67160366/C7-earphone-web/README.md

# C7-BioSync Earphone Posture Monitoring System (Protocol v2)

ระบบตรวจจับและวิเคราะห์มุมกระดูกคอ (Craniovertebral Angle: CVA) แบบ 3 มิติแบบเรียลไทม์ โดยใช้เซนเซอร์ BNO085 คู่ (ซ้าย-ขวา) ร่วมกับ MPU6050 ที่ต้นคอ (C7) และแสดงผลผ่านหน้าเว็บที่เชื่อมหูฟังทาง USB โดยตรง (Web Serial API)

---

## 📂 ไฟล์หลักในเวอร์ชันนี้

1. **[`esp32_c7_prototype/esp32_c7_prototype.ino`](esp32_c7_prototype/esp32_c7_prototype.ino)**
   - โค้ด Arduino สำหรับบอร์ด ESP32 (Protocol v2: ส่ง `mpu_tilt` แยกจาก `head_pitch`)
   - ใช้ไดรเวอร์ `SafeBNO085` ที่เขียนขึ้นใหม่เพื่อคุยโปรโตคอล SHTP แบบแบ่ง Chunk ละ 32 ไบต์
   - รองรับการอ่านค่าเซนเซอร์ BNO085 พร้อมกัน 2 ตัว (`0x4A` และ `0x4B`) และเซนเซอร์ต้นคอ MPU6050 (`0x68`)
   - USB **460800 baud** (เดิม 115200) คำสั่ง `z` ตั้งท่าเริ่มต้น, `i` ตรวจ address, `s` สแกน I2C, `r` / `n` เปิด/ปิดโหมดเก็บข้อมูลดิบ 50 Hz
2. **[`index.html`](index.html)** หน้าสำหรับผู้ใช้
   - เชื่อมหูฟังด้วยปุ่มเดียว ดูโมเดลศีรษะและคอ 3 มิติ (3 มิติ / ด้านข้างพร้อมเส้น CVA / ด้านหน้า แสดงแบบกระจกเป็นค่าเริ่มต้น) สถานะท่า (ท่าดี / เริ่มก้มคอ / คอยื่น) และแถบ ก้ม-เงย / เอียงศีรษะ / หันหน้า
   - ตั้งท่าเริ่มต้น และเตือนเมื่อคอยื่นนานเกินเวลาที่ตั้งไว้ ถ้ายังไม่มีหูฟัง เปิด `index.html?demo` เพื่อดูด้วยข้อมูลจำลอง (มีป้ายบอกตลอด)
   - โมเดล 3 มิติใช้ Three.js ที่เก็บไว้ในเครื่อง (`assets/vendor`) และหัวสแกน CC BY 3.0 (`assets/models/head`) ต้องเปิดผ่าน http เช่น `http://127.0.0.1:8090/`
3. **[`dev.html`](dev.html)** หน้าสำหรับนักพัฒนา
   - แผง **สูตรมุมคอ (CVA) ทีละขั้น**: ค่าที่รับจากบอร์ดพร้อมที่มา, ค่าคงที่ (วัดได้ / สมมติ / คำนวณ), การคำนวณทีละบรรทัดด้วยตัวเลขจริง, ภาพด้านข้าง SVG, โมเดล 3 มิติที่ขยับตามค่าเดียวกัน และเทียบกับสูตรเก่า v1
   - สถานะบอร์ด (boot_id, calibration_id, อัตราเฟรม), เซ็นเซอร์ 0x4A / 0x4B / 0x68, มุมดิบ, การเทียบ CVA ระหว่างบอร์ดกับเว็บ, log, คำสั่ง `z` / `i` / `s` / คำสั่งดิบ
   - ตรวจทิศทางเซ็นเซอร์ทีละท่า (ก้ม / เอียงขวา / หันซ้าย) เพื่อดูว่าแกนและเครื่องหมายตรงกับที่หน้าเว็บใช้หรือไม่ ดู [`docs/SENSOR_AXES.md`](docs/SENSOR_AXES.md)
   - บันทึกลง `api/save_angle.php` (ปิดไว้ก่อน), ส่งออก CSV, ข้อมูลจำลองแบบปรับมุมเอง และผังต่อสาย
4. **[`collect.html`](collect.html)** หน้าเก็บข้อมูลดิบไว้ทำ data model
   - รับค่า quaternion, accel, gyro และมุม x/y/z ของทั้ง 3 เซ็นเซอร์ที่ 50 Hz พร้อมกราฟสด อัตราจริง บรรทัดที่หาย, δ ซ้าย-ขวา และเวลาห่างของสองหู (ซิงก์)
   - จอกว้างแสดง 3 ส่วนในจอเดียว: สถานะเซ็นเซอร์ | กราฟ | มุมการหมุน 3 มิติ
   - ขั้นตอนท่าพร้อมนับถอยหลังและเสียง, ป้ายท่า, ช่องกรอกมุมอ้างอิงที่วัดเอง, ดาวน์โหลด CSV + JSON (ข้อมูลอยู่ในเครื่อง ไม่ส่งไปที่ไหน)
   - มุมการหมุน 3 มิติ: แกน x/y/z ของเซ็นเซอร์แต่ละตัวในทิศโลก (ตะวันออก/เหนือ/ขึ้น) แบบแยกกันหรือซ้อนกัน, ตามที่ติดจริงหรือจัดแนวสองหูให้ตรงกัน, ทิศที่แต่ละแกนชี้, accel/gyro และมุมระหว่างสองหู
   - แผง "อ่านค่าในหน้านี้" อธิบายที่มาของค่า แกน 3 มิติ กราฟ และคอลัมน์ CSV
   - ข้อมูลจำลอง: `collect.html?demo` รูปแบบข้อมูลและวิธีเก็บที่แนะนำอยู่ใน [`docs/DATA_COLLECTION.md`](docs/DATA_COLLECTION.md)
5. **[`wiring.html`](wiring.html)** แบบร่าง 3 มิติ "หูฟังของผู้ใช้ + อุปกรณ์เสริมของเรา" พร้อมผังต่อสาย (ข้อเสนอ ยังไม่ได้สร้างจริง)
   - ผู้ใช้ใช้หูฟังครอบหูของตัวเอง แล้วติดอุปกรณ์เสริม: ตลับเซ็นเซอร์แปะด้านนอกฝาครอบหูทั้ง 2 ข้าง (BNO085 ข้างละตัว), โครงพาดบ่าจากที่ดามนิ้วอะลูมิเนียม 18 นิ้ว และกล่อง C7 (ESP32 DevKit V1 + แบต + GY-521 + Qwiic Adapter 2 แผ่นเป็นจุดแยกสาย) กลางแถบ สายจากตลับแต่ละข้างลงกล่องเป็นสาย Qwiic 20 ซม. 2 เส้นต่อกันด้วย Qwiic Adapter
   - 3 มุมมอง: สวมใส่, แยกชิ้น, ผังต่อสาย (บอร์ดขนาดจริงมีชื่อขาตามบอร์ด: Adafruit BNO085, ESP32 DevKit V1 30 ขา, GY-521, TP4056, MT3608, LiPo, สวิตช์, SparkFun Qwiic Adapter; สายในผังเดินตามสายจริงทีละเส้นพร้อมหัวต่อ, แตะบอร์ดเพื่อซูม, แตะสายเพื่อดูชนิดสาย, เปิด/ปิดสายแต่ละกลุ่ม) พร้อมตารางต่อสายจัดกลุ่มตามสายจริง 9 ชุด (36 เส้น), วิธีแยกไฟ 3V3 ไปหลายเซ็นเซอร์, ตารางตำแหน่งและจำนวนอุปกรณ์ทุกชิ้น, มุมมองสวมใส่แบบมองทะลุเห็นบอร์ดในตลับและกล่อง พร้อมระยะสายหู → C7 ที่วัดจากโมเดลทุกท่า, วิธีต่อแบต, รายการของที่ต้องซื้อจากร้านในไทย และความยาวสายตลับ→กล่องขณะขยับศีรษะ
   - ไม่ต่อ USB และไม่ใช้ข้อมูลเซ็นเซอร์ ไฟล์คือ `wiring.html` + `assets/wiring.js` + `assets/wiring-models.js` (หูฟัง, ตลับ, โครง) + `assets/wiring-boards.js` (บอร์ด)
6. **[`structure.html`](structure.html)** โครงสร้างในกล่อง (ข้อเสนอ ยังไม่ได้พิมพ์จริง): กล่อง C7 96 × 60 × 35 มม. 2 ชั้นมีถาดบอร์ดคั่น, ตลับเซ็นเซอร์ข้างหู และกล่องข้อต่อกลางสาย
   - แต่ละชิ้นวางตรงไหน ยึดด้วยอะไร สายเดินทางไหน ดูแบบประกอบแล้วหรือแยกชิ้นทีละชั้น แตะชิ้นส่วนหรือแถวในตารางเพื่อดูรายละเอียด
   - ตำแหน่งและขนาดอยู่ใน `assets/structure-layout.js` (หน้า wiring ใช้ชุดเดียวกัน) และ `node scripts/check-web.mjs` ตรวจว่าชิ้นส่วนไม่ชนกันและอยู่ในกล่อง
7. **[`assets/c7-core.js`](assets/c7-core.js)** โค้ดที่ทั้งสองหน้าใช้ร่วมกัน: สูตร CVA geometry 1 (ตรงกับ `calculateCVA()` ในเฟิร์มแวร์และ `api/save_angle.php` อธิบายใน [`docs/FORMULA.md`](docs/FORMULA.md)), การตรวจ Protocol v2 (รับ v1 ได้โดยถอด pitch ออกจาก `c7_angle`), การเชื่อม USB และข้อมูลจำลอง ดีไซน์อยู่ที่ [`docs/DESIGN.md`](docs/DESIGN.md)

### เปิดใช้งาน

ต้องมี PHP 8+ (หรือ XAMPP) และเปิดด้วย Chrome หรือ Edge บนคอมพิวเตอร์ (Web Serial):

```powershell
powershell -NoProfile -ExecutionPolicy Bypass -File scripts/serve.ps1        # เปิด server
powershell -NoProfile -ExecutionPolicy Bypass -File scripts/serve.ps1 -Stop  # ปิด server
node scripts/check-web.mjs                                                     # เทสต์
```

แล้วเปิด http://127.0.0.1:8090/ (ข้อมูลจำลอง: `/?demo`, หน้า dev: `/dev.html`, เก็บข้อมูล: `/collect.html`, แบบอุปกรณ์เสริม: `/wiring.html`, โครงสร้างในกล่อง: `/structure.html`) เฟิร์มแวร์กับหน้าเว็บต้องเป็นรุ่นเดียวกัน (460800 baud) ถ้าบอร์ดยังเป็นรุ่น 115200 ต้อง flash ใหม่ ปิดโปรแกรมอื่นที่ใช้พอร์ต USB เดียวกัน (เช่น Serial Monitor ของ Arduino IDE) ก่อนกดเชื่อมต่อ

ก่อนแก้โค้ดให้อ่าน [AGENTS.md](AGENTS.md) (กฎการทำงาน) และ [HANDOFF.md](HANDOFF.md) (สถานะล่าสุด) ทุกครั้งที่จบงานต้องอัปเดต HANDOFF และเพิ่มบันทึกใน [docs/WORKLOG.md](docs/WORKLOG.md)

---

## 🔍 สาเหตุของปัญหาที่พบ และการแก้ไขเรื่อง I2C Address ชนกัน

### 1. ปัญหาที่พบ (Root Cause: On-Board Pull-Up & Address Collision)
- โมดูลเซนเซอร์ **BNO085 (GY-BNO08X)** มีตัวต้านทาน **Pull-up (หรือการกำหนดค่าเริ่มต้นบนแผ่นบอร์ด)** ต่ออยู่ที่ขาเลือก Address (`DI` / `SA0` / `ADR`) อยู่แล้ว ทำให้ตัวบอร์ดมี I2C Address ตั้งต้นของตัวเองอยู่แล้วตั้งแต่จ่ายไฟ
- ก่อนหน้านี้เราไม่ทราบว่าบอร์ดมี Pull-up และมี Address กำหนดไว้แล้ว จึงทำการต่อสายกำหนด Address ซ้ำเหมือนกันทั้ง 2 ตัว (หรือเข้าใจสลับกันว่าปล่อยว่างคืออีกค่าหนึ่ง) ส่งผลให้เซนเซอร์ทั้ง 2 ตัวกลายเป็น **Address เดียวกัน** บนบัส I2C เดียวกัน (`Wire` ขา `SDA=21, SCL=22`)
- เมื่อเซนเซอร์ 2 ตัวมี Address ชนกันบนบัสเดียวกัน จึงเกิดอาการแย่งกันตอบ ACK / ข้อมูล SHTP ตีกัน ทำให้ทำงานพร้อมกันสองตัวไม่ได้ หรือเห็นเซนเซอร์ขึ้นแค่ตัวเดียว

### 2. การแก้ไขให้เซนเซอร์ทำงานพร้อมกันได้ทั้ง 2 ตัว (Dual BNO085 Solution)
- **แยก I2C Address ของเซนเซอร์ทั้ง 2 ตัวให้ต่างกันอย่างชัดเจน:**
  - **หูซ้าย (`LeftEar_A`)** กำหนดเป็น Address **`0x4A`**
  - **หูขวา (`RightEar_B`)** กำหนดเป็น Address **`0x4B`**
  - **ต้นคอ (`C7` - MPU6050)** ใช้ Address **`0x68`**
- **ตรวจสอบด้วย I2C Scanner (`s`) และล็อกตำแหน่งในโค้ด:**
  - ปรับโค้ดใน `detectAndInitDualBno()` ให้สแกนหาและจับคู่ `0x4A` เป็นเซนเซอร์ฝั่งซ้าย (เริ่มทำงานตัวที่ 1) และ `0x4B` เป็นเซนเซอร์ฝั่งขวา (เริ่มทำงานตัวที่ 2) อย่างแม่นยำ พร้อมรองรับกรณีแยกบัสสำรอง (`Wire` 21/22 และ `Wire1` 18/19)

---

## 🛠️ สรุปการแก้ไขเพิ่มเติมในโค้ดเวอร์ชันใหม่

### 1. แก้ไขฝั่ง Arduino (`esp32_c7_prototype.ino`)
- **สร้างคลาส `SafeBNO085` แทนที่ไลบรารี `SparkFun_BNO080` เดิม:**
  - แก้ปัญหา `Guru Meditation Error: StoreProhibited` (บั๊ก I2C ของ ESP32 Core 3.0.x เมื่อชิป NACK กลางคัน)
  - เช็ค `waitWriteAck()` (`beginTransmission` / `endTransmission`) ก่อนเรียก `requestFrom()` ทุกครั้ง
  - จำกัดขนาดการอ่าน SHTP ครั้งละไม่เกิน **32 ไบต์** (~2.9 ms ที่ 100 kHz) เพื่อไม่ให้เกินเพดาน Hardware Timeout 13.1 ms ของซิลิคอน ESP32
  - ยกเลิกการสั่ง `softReset()` แล้วรอเพียง 50 ms ที่ทำให้ชิปยังไม่พร้อมและเกิด NACK โดยเปลี่ยนเป็นอ่าน SHTP ทันที และหากจำเป็นต้องรีเซ็ตจะใช้ `safeSoftResetAndWait()` ที่รอชิปบูตครบ 450 ms พร้อมเช็ค ACK 5 ครั้งติดกัน
- **ระบบตรวจสอบสายไฟและสลับขาอัตโนมัติ (Electrical PinCheck & Auto-Swap):**
  - เช็คสถานะทางไฟฟ้าของขา `D21` และ `D22` ตอนบูต (`OK_PULLUP_3V3`, `FLOATING`, หรือ `LOW_STUCK`) พร้อมฟังก์ชัน `unstickI2CPins()` ส่งคล็อก 16 ลูกเพื่อปลดล็อกกรณีสาย SDA ค้าง
  - หากไม่พบอุปกรณ์บน `(SDA=21, SCL=22)` บอร์ดจะทดลองสลับเป็น `(SDA=22, SCL=21)` อัตโนมัติเผื่อเสียบสายสลับกัน
- **การคำนวณมุมศีรษะจากเซนเซอร์คู่ (Dual-Ear Circular Midpoint) และ Protocol v2:**
  - ตั้งศูนย์ (Zero Calibration) แยกอิสระรายตัว (`offsetPitchL/R`, `offsetRollL/R`, `offsetYawL/R`, `offsetC7`)
  - เมื่อทั้ง `0x4A` และ `0x4B` ทำงานพร้อมกัน จะคำนวณค่าเฉลี่ยเชิงมุม (`circularMidpointDeg`) ของหูซ้ายและหูขวาเพื่อให้ได้มุมกลางกะโหลกที่แม่นยำ และส่งออกเป็น JSON **Protocol v2** ความถี่ 5 Hz (ทุก 200 ms)
  - field หลัก: `protocol_version: 2`, `geometry_id`, `tilt_estimated`, `mpu_tilt` (มุม MPU ที่ C7 เทียบตอนตั้งศูนย์ ไม่ผสม pitch, `null` ถ้าไม่มี MPU), `mpu_tilt_raw`, `head_pitch`, `head_roll`, `head_yaw`, `cva_angle`
  - CVA ใช้แบบจำลอง 2 ท่อนในระนาบด้านข้าง (geometry 1) roll/yaw ไม่เข้าสูตร ดู [`docs/FORMULA.md`](docs/FORMULA.md)
  - มีระบบ Auto-Reconnect / Health Check ทุก 3 วินาที หากสายหลุดแล้วเสียบใหม่จะกลับมาอ่านค่าต่อได้เองโดยไม่ต้องรีบูตบอร์ด

### 2. หน้าเว็บ
- หน้าเดิม (`live_test.html`, `wiring_guide.html` และ pitch deck ใน `index.html`) ถูกแทนด้วย `index.html` และ `dev.html` ชุดใหม่ ฟีเจอร์ USB เดิม (ปลด DTR/RTS, ตรวจ Protocol v1, Zero รอ `calibration_id`, สแกน I2C, log) ย้ายไปอยู่ใน `assets/c7-core.js` และหน้า dev
