67160366/C7-earphone-web/docs/README.md

# เอกสาร C7-earphone

| อยากรู้เรื่อง | เปิดไฟล์ |
| --- | --- |
| กฎการทำงาน, คำสั่ง, ข้อห้าม | [../AGENTS.md](../AGENTS.md) |
| สถานะล่าสุด, งานค้าง, สิ่งที่ยังไม่ได้ตรวจ | [../HANDOFF.md](../HANDOFF.md) |
| ประวัติการทำงานแต่ละรอบ | [WORKLOG.md](WORKLOG.md) |
| วิธีใช้งานและภาพรวมไฟล์ | [../README.md](../README.md) |
| สูตรมุมคอ (CVA): ตัวแปร, ค่าคงที่, ที่มา, ตัวอย่าง, ข้อจำกัด | [FORMULA.md](FORMULA.md) |
| ทิศแกน pitch/roll/yaw และปัญหาแกนในเฟิร์มแวร์ | [SENSOR_AXES.md](SENSOR_AXES.md) |
| เก็บข้อมูลดิบ 50 Hz: รูปแบบบรรทัด, คอลัมน์ CSV, วิธีเก็บที่แนะนำ | [DATA_COLLECTION.md](DATA_COLLECTION.md) |
| ดีไซน์หน้าเว็บ (สี, ตัวอักษร, หลักการเขียนข้อความ) | [DESIGN.md](DESIGN.md) |
| รายการสั่งซื้อชุดต่อสาย: ร้าน รุ่น ขนาด จำนวน ราคา | [SHOPPING_LIST.md](SHOPPING_LIST.md) ([PDF](SHOPPING_LIST.pdf)) |
| แผนและงานวิจัยเดิม | [../base_plan.md](../base_plan.md) (บางส่วนไม่ตรงกับโค้ดปัจจุบัน) |
