67160366/C7-earphone-web/HANDOFF.md

# Handoff: สถานะปัจจุบันของ C7-earphone

อ่านไฟล์นี้ก่อนเริ่มงาน และแก้ให้เป็นปัจจุบันทุกครั้งที่จบงาน (กฎอยู่ใน [AGENTS.md](AGENTS.md)) ประวัติการทำงานแต่ละรอบอยู่ใน [docs/WORKLOG.md](docs/WORKLOG.md)

## โปรเจกต์นี้คืออะไร
- หูฟังติดเซ็นเซอร์ BNO085 ที่หู (0x4A ซ้าย / 0x4B ขวา) และ MPU6050 ที่ต้นคอ (0x68, ไม่บังคับ) ต่อกับ ESP32
- บอร์ดส่ง JSON **Protocol v2** ทาง USB ที่ **460800 baud** (เปลี่ยนจาก 115200 รอบนี้) ทุก 200 ms โดยส่ง `mpu_tilt` แยกจาก `head_pitch`
- **โหมดเก็บข้อมูล** (คำสั่ง `r` / `n`): ส่งค่าดิบทั้ง 3 ตัวที่ 50 Hz ไปหน้า `collect.html` เพื่อทำ data model ดู [docs/DATA_COLLECTION.md](docs/DATA_COLLECTION.md)
- หน้าเว็บอ่าน USB โดยตรง (Web Serial) แล้วแสดงท่าคอ และเตือนเมื่อคอยื่นนานเกินไป
- สูตรมุมคอ (CVA geometry 1) อธิบายใน [docs/FORMULA.md](docs/FORMULA.md)

## Git
- Clone จาก `https://github.com/67160162-BUU/C7-earphone.git` (upstream `main` = `cf27bb4`)
- งานหน้าเว็บใหม่อยู่บน branch **`feature/user-web`** (ยังไม่ merge เข้า `main`)
- push ขึ้น repo ใหม่แบบ public แล้ว: https://github.com/67160366/C7-earphone-web (remote ชื่อ `web`, default branch = `feature/user-web`)
  - commit ล่าสุดที่ push แล้ว: `ca82c52` (เพิ่มหน้า structure.html, รายการสั่งซื้อ, แก้หน้า wiring) เมื่อ 2026-11-13
  - `origin` ยังชี้ไป upstream `67160162-BUU/C7-earphone` และยังไม่เคย push ไปที่นั่น
  - fork เดิม `67160366/C7-earphone` เป็นของโปรเจกต์ HeadSet ไม่ได้แตะ
- โปรเจกต์เดิม `D:\work\HeadSet` เป็นงานคนละชุด และ**ไม่มีอยู่ในเครื่องนี้แล้ว** (`C:\Users\ESP\Documents\C7-earphone-web`)

## สภาพแวดล้อมในเครื่องนี้ (ตั้งเมื่อ 2026-11-09)
- ติดตั้งผ่าน winget: PHP 8.4.27 (`PHP.PHP.8.4`), Node 24.20.0 (`OpenJS.NodeJS.LTS`), arduino-cli 1.5.1 (`ArduinoSA.CLI`, อยู่ที่ `C:\Program Files\Arduino CLI`)
  - เปิด terminal ใหม่ก่อน PATH จึงจะเห็น `php` / `node` / `arduino-cli`
  - PHP ไม่มี `php.ini` จึงไม่มี `pdo_mysql` API จะใช้ CSV อย่างเดียว (ตอบเร็ว ไม่ติด timeout MySQL) ถ้าจะใช้ MySQL ต้องเปิด extension เอง
- arduino-cli ตั้งค่าที่ `.local/arduino-cli.yaml` เก็บ core/ดาวน์โหลดไว้ใน `.local/arduino/` (gitignore แล้ว) พร้อม ESP32 core 3.3.12 ตรวจแล้วว่า compile ผ่าน (71% / RAM 14%)
  - ถ้า `core install` เจอ 504 จาก github.com ให้ดาวน์โหลดไฟล์ผ่าน GitHub API ไปไว้ใน `.local/arduino/downloads/packages/` ก่อน (ดู WORKLOG 2026-11-09)
- ไม่มี `.env` เพราะโค้ดไม่อ่าน environment variable (MySQL ใช้ `root` รหัสว่างแบบ XAMPP ฝังในโค้ด)
- Chrome และ Edge มีอยู่แล้ว

## วิธีรัน
```powershell
powershell -NoProfile -ExecutionPolicy Bypass -File scripts/serve.ps1
```
- หน้าผู้ใช้: http://127.0.0.1:8090/
- ข้อมูลจำลอง: http://127.0.0.1:8090/?demo
- หน้า dev: http://127.0.0.1:8090/dev.html
- หน้าเก็บข้อมูล: http://127.0.0.1:8090/collect.html (ข้อมูลจำลอง: `collect.html?demo`)
- โครงสร้างในกล่อง: http://127.0.0.1:8090/structure.html (ลิงก์จากหน้า dev และหน้า wiring) **ใหม่ 2026-11-13 (commit `ca82c52`)**
  - กล่อง C7 ออกแบบใหม่เป็น **96 × 60 × 35 มม.** (ด้านใน 92 × 56 × 31) เพราะหัวจัมเปอร์ใต้ ESP32 ต้องการความสูง 19.5 มม. กล่อง 22 มม. เดิมใส่ไม่ได้ รวมราง แผ่นหนีบ แผ่นรองด้านหลังแล้วยื่นจากผิวราว 44.5 มม.
    - ชั้นล่าง (พื้น): MT3608 (ใต้ ESP32), TP4056 (USB-C ผนังล่าง), LiPo (ช่องแบตมุมขวาบน), สวิตช์เลื่อน (ก้านโผล่ผนังล่าง)
    - ถาดบอร์ด สูง 20.5 มม. วางบนเสา 4 ต้น มีร่อง 5 ร่องให้ขาและหัวจัมเปอร์ลอด: ESP32 (micro-USB ผนังซ้าย), Qwiic Adapter 1 และ 2, GY-521
    - ที่ยึด: ESP32 สกรู 4, GY-521 สกรู 2, Adapter ตะขอล็อก, TP4056/MT3608 ช่อง + ตะขอ, LiPo ช่อง + เทปโฟม, ถาดสกรู 2 (เสาซ้าย/ขวา), ฝาสกรู M2.5×20 2 ตัวผ่านปลอกทะลุถาด (เสาบน/ล่าง), แผ่นหนีบแถบสกรู M3 4 ตัวเข้าราง 2 เส้นหลังกล่อง
    - สายหูเข้าทางร่องที่ผนังบน x = ±42.5 มม. สาย Qwiic 5 ซม. โค้งเป็นห่วงบนถาด (หย่อน 15.3 มม.)
  - ตลับข้างหู 39 × 28.5 × 9 มม. (BNO085 สกรู 2 + หมุด 2, แคลมป์รัดสาย, ฝากดล็อก, ตีนตุ๊กแก) และกล่องข้อต่อกลางสาย 45 × 22 × 9 มม. (Adapter วางบนบ่า ฝาสกรู 2, หมุดให้สายคดกันดึง, คลิปหลัง)
  - `assets/structure-layout.js` เป็นแหล่งความจริงของขนาดและตำแหน่ง (มม.) หน้า wiring อ่านไฟล์เดียวกันใน `fillBox()`; `DIM.box` / `DIM.pod` ใน `wiring-models.js` ต้องแก้ให้ตรงเอง
  - ทางเลือกที่ยังไม่ได้ตัดสินใจ: บัดกรีสายเข้าขาแทนหัวจัมเปอร์ จะลดความหนาได้ราว 12 มม. (ยังไม่ได้ออกแบบ)
  - ยังไม่ได้ทำ: ไฟล์ STL สำหรับพิมพ์, ใส่สกรูและตัวยึดใน `docs/SHOPPING_LIST.md` (รายการอยู่บนหน้า structure)
- แบบร่างอุปกรณ์เสริม 3 มิติ + ผังต่อสาย: http://127.0.0.1:8090/wiring.html (ลิงก์จากหน้า dev) **แก้รอบ 2026-11-13 (commit `ca82c52`)**
  - คอนเซ็ป (2026-11-11): ผู้ใช้ใช้หูฟังครอบหูของตัวเอง + อุปกรณ์เสริมของเรา
    - ตลับเซ็นเซอร์ข้างหู 2 ตลับ (Adafruit BNO085 #4754 ข้างละตัว) แปะด้านนอกฝาครอบหู
    - โครงพาดบ่า: ที่ดามนิ้วอะลูมิเนียมแบบตัด (rakmor RMM-FS002, 18 นิ้ว) 1 เส้น มีกล่อง C7 หนีบกลางแถบ
    - กล่อง C7 (96×60×35 มม. ดูหน้า structure): ESP32 DevKit V1 30 ขา, LiPo 503035, TP4056 USB-C, สวิตช์, MT3608, GY-521, SparkFun Qwiic Adapter 2 แผ่น
    - **ไม่มีโมดูลมอเตอร์สั่นแล้ว** (ผู้ใช้สั่งเอาออก 2026-11-13) เฟิร์มแวร์ยังมี `HAPTIC_MOTOR_PIN` (D25) ไม่ได้แตะ
  - **การต่อสายจริง (2026-11-13):** ขา ESP32 ขาละ 1 สาย ไม่แยกสายที่ขา จุดแยกคือแผ่น SparkFun Qwiic Adapter (ช่อง Qwiic 2 ช่อง + รู 4 รู GND/3V3/SDA/SCL บนบัสเดียวกัน)
    - ESP32 (3V3, GND ฝั่ง 3V3, D21, D22) → สายจัมเปอร์เมีย-เมีย 4 เส้น → ก้านขาที่บัดกรีบน Adapter 1
    - Adapter 1 ช่องซ้าย → หูซ้าย, ช่องขวา → สาย Qwiic 5 ซม. → Adapter 2 ช่องซ้าย
    - Adapter 2 ก้านขา → สายจัมเปอร์เมีย-เมีย 4 เส้น → GY-521, ช่องขวา → หูขวา
    - สายไปหูแต่ละข้าง: Flexible Qwiic 20 ซม. + Qwiic Adapter (ข้อต่อกลางสาย) + Flexible Qwiic 20 ซม. = 40 ซม.
    - BNO ซ้าย 0x4A (DI ว่าง), BNO ขวา 0x4B (บัดกรี 3Vo → DI), GY-521 0x68; ไฟ: LiPo → TP4056 B± → OUT+ ผ่านสวิตช์ → MT3608 (ตั้ง 5.0 V) → VIN/GND
  - **มุมมองสวมใส่ (2026-11-13 รอบ 3):** ติ๊ก "มองทะลุเห็นบอร์ดข้างใน" (เปิดเป็นค่าเริ่มต้น) เห็นบอร์ดขนาดจริงในตลับ (BNO085) และในกล่อง C7 2 ชั้น (ตำแหน่งจาก `structure-layout.js`) สายในกล่องดูที่หน้า structure
    - ระยะหู → C7 วัดจากโมเดลอัตโนมัติ (`measureRange()` ไล่ 75 ท่า): (วัดใหม่กับกล่อง 96×60×35) เส้นตรงท่าตรง 19.4 ซม., สายเดินจริงท่าตรง 17.2, ก้มสุด 45° 19.1, เงยสุด 30° 16.1, ยาวสุด 30.0 ซม. ที่ก้ม 45° หัน 70° เอียง -30° จึงเหลือเผื่อ 10.0 ซม. จากสาย 40 ซม. (ยังไม่รวมสายในกล่องและในตลับราว 1.5–2 ซม. ต่อปลาย) (หัวสแกนปรับให้ศีรษะกว้าง 16 ซม. ยังไม่ได้วัดจากผู้สวมจริง)
    - การ์ด "อุปกรณ์ตัวไหนอยู่ตรงไหน" ใน `wiring.html` บอกตำแหน่งและจำนวนทุกชิ้น
    - ปัญหากล่องหนา 22 มม. ไม่พอ แก้แล้วด้วยการขยายกล่องเป็น 35 มม. (ดูหน้า structure)
    - ยังไม่ได้ตรวจ: ภาพบอร์ดในตลับ/กล่องดูจากภาพขนาดเล็กเท่านั้น ไม่ได้ซูมตรวจว่าบอร์ดไม่ทะลุผนัง; ที่จอ 375 px กล่องตัวเลขระยะบังโมเดลเกือบครึ่ง; ไม่ได้ตรวจมุมมองแยกชิ้นกับบอร์ดข้างใน
  - **รายการสั่งซื้อ:** [docs/SHOPPING_LIST.md](docs/SHOPPING_LIST.md) และ `docs/SHOPPING_LIST.pdf` (สร้างจากไฟล์ md ด้วยสคริปต์ชั่วคราว + Edge headless ไม่มีสคริปต์ใน repo; ถ้าแก้ md ต้องสร้าง PDF ใหม่เอง) ผู้ใช้มีเซ็นเซอร์ ESP32 แบตแล้ว กล่องจะพิมพ์ 3 มิติ; หมวดสายและข้อต่อซื้อ Arduitronics ร้านเดียว 1,012 บาท; ยังไม่ได้เช็กราคา MT3608 และสต็อกที่ดามนิ้ว; ลิงก์สายไฟ 26AWG ชี้ไปหน้าค้นหาของร้าน
  - ร้านในไทยที่ใช้อ้างอิง (ดูหน้าร้าน 2026-11-13):
    - Arduitronics: Qwiic Adapter AG00305 95 บาท พร้อมส่ง; Flexible Qwiic 200 mm AG30260 120 บาท พร้อมส่ง; Flexible Qwiic 100 mm AG20260 120 บาท; Flexible Qwiic Female Jumper AG20282 125 บาท พร้อมส่ง; BNO085 AS90163 1,685 บาท **สินค้าหมด**
    - Cytron ไทย: สาย Qwiic 50 mm WR-SQ-50MM 10 บาท (สต็อก 18); Female to Female Jumper Wire 18 บาท (หน้าร้านไม่บอกความยาว)
    - ไม่พบ: สาย Qwiic 500 mm, Qwiic MultiPort / ตัวแยกหลายช่อง; หน้า ModuleMore (สาย SH1.0 สองหัว 30 ซม. แบบ reverse) เปิดไม่ได้ จึงไม่มีรายละเอียด
  - ไฟล์: `assets/wiring.js` (หน้า; รายการสายจริงอยู่ที่ `CABLES`, ทิศที่สายออกจากขาอยู่ที่ `wireEnd()`), `assets/wiring-models.js` (หูฟัง ตลับ โครง; ขนาดใน `DIM`), `assets/wiring-boards.js` (บอร์ดขนาดจริง รวม `qwiicAdapter`)
  - ตรวจแล้วในเบราว์เซอร์ (2026-11-13): ผังต่อสายแสดงบอร์ด 12 ชิ้น สาย 36 เส้นใน 9 ชุด, แตะสายแล้วการ์ดบอกชนิดสาย, ตารางจัดกลุ่มตามสาย, มุมมองสวมใส่มีข้อต่อสีแดงกลางสาย (ก้ม 40° หัน 60°: ยาวสุด 25.6 ซม. จาก 40 ซม.), 375 px ธีมสว่างไม่ล้น (scrollWidth 375), ธีมมืด, console ไม่มี error
  - ยังไม่ได้ยืนยัน:
    - ยังไม่ได้ซื้อของหรือต่อวงจรจริงตามผังนี้ ยังไม่ได้ทดสอบ I2C ผ่านสาย 40 ซม. 2 ข้าง + ข้อต่อกับบอร์ดจริง (Adafruit เตือนว่าสาย 300 มม. ก็ถือว่ายาวสำหรับ I2C)
    - ขนาดและลำดับรูของ Qwiic Adapter ในโมเดลเป็นค่าประมาณ (หน้าร้านไม่ระบุ) ต้องดูตัวหนังสือบนแผ่นจริง
    - ก้านขาตัวผู้ 2.54 มม.: ก้างปลาขาตรง 1×40 (Arduitronics SKU-00487 5 บาท พร้อมส่ง ขายาว 11 มม. หรือ Cytron ไทย CN-PH-M140S 10 บาท สต็อก 48) หักใช้ 4 ขา; ยังไม่ได้ยืนยันว่ารูของ Qwiic Adapter ห่างกัน 2.54 มม.; สายจัมเปอร์ของ Cytron ไม่รู้ความยาวและจำนวนเส้น; ราคาและสต็อกเปลี่ยนได้
    - รอบนี้ไม่ได้ตรวจท่าศีรษะสุดช่วงทุกแกนกับสาย 40 ซม. (รอบก่อนวัดยาวสุด 28.8 ซม.) และไม่ได้ตรวจมุมมองแยกชิ้น
    - ไม่ได้ซูมตรวจบอร์ด TP4056, MT3608, LiPo, สวิตช์ทีละชิ้น; ตำแหน่งขาของ TP4056 และ MT3608 เป็นแบบที่พบบ่อย ไม่ได้เทียบกับของที่ผู้ใช้มี
    - ขนาดบอร์ด ESP32 (51.5×28.2 มม. ระยะแถวขา 25.4 มม.) เป็นค่าประมาณ ต้องวัดจากบอร์ดจริง
    - ขนาดตลับ กล่อง ความหนาแถบ และฟองน้ำรองเป็นค่าสมมติ; การใส่ได้ของกล่อง 96×60×35 มม. ตรวจด้วยเทสต์กล่องสี่เหลี่ยมในโค้ดเท่านั้น ยังไม่ได้พิมพ์หรือประกอบจริง
    - เฟิร์มแวร์ส่งข้อมูลทาง USB เท่านั้น แบตจึงยังไม่ทำให้ใช้งานไร้สายได้; ผลของแม่เหล็กลำโพงต่อ BNO085 ยังไม่ได้ทดสอบ
  - skill ที่ใช้ทำโมเดล: `.claude/skills/threejs-procedural-geometry/` (MIT, untracked ยังไม่ commit) ใช้เป็นแนวทางเท่านั้น
  - ใช้ Three.js และหัวสแกนที่มีในเครื่อง (`assets/models/head/`, CC BY 3.0 ดู `assets/vendor/README.md`)
- บอร์ดที่ COM3 เป็นเฟิร์มแวร์รุ่น working tree **format 2** (460800, sha256 `5a26a7f9…`) แล้ว (flash 2026-11-10 ตามที่ผู้ใช้สั่ง) ใช้กับ `collect.html` ได้
- ต่อหูฟังได้ใน Chrome หรือ Edge ปิด Serial Monitor ตัวอื่นก่อนเชื่อมต่อ

Compile เฟิร์มแวร์ (ไม่ flash):
```bash
arduino-cli --config-file .local/arduino-cli.yaml compile --fqbn esp32:esp32:esp32 --build-path <โฟลเดอร์ชั่วคราว> esp32_c7_prototype
```

## สถานะปัจจุบัน

### สูตร CVA (geometry 1)
แบบจำลอง 2 ท่อนในระนาบด้านข้าง (หน่วย cm):
- คอ C7→C0 ยาว L = 12 cm หมุนตาม `tilt` ของ MPU
- ติ่งหูอยู่ที่ (1, 2) cm จาก C0 หมุนตาม `head_pitch`
- φ0 = 40.058° แก้สมการให้ท่าตั้งศูนย์ได้ 52.05°
- roll/yaw ไม่เข้าสูตร

ไม่นับ pitch ซ้ำแล้ว และยื่นคอพร้อมเงยหน้าสวนยังทำให้ค่าลด เช่น tilt +10 กับ pitch −10 ได้ 45.0° ขณะที่สูตรเก่าได้ 50.5°

ไม่มี MPU: `tilt ≈ 0.5 × max(0, pitch)` ติดป้ายประมาณ

สูตรเดียวกันอยู่ 3 ที่: `assets/c7-core.js`, เฟิร์มแวร์ และ `api/save_angle.php`

### Protocol v2
- field: `protocol_version: 2`, `geometry_id: 1`, `tilt_estimated`, `mpu_tilt`, `mpu_tilt_raw`, `head_pitch/roll/yaw`, `cva_angle` (ไม่มี `c7_angle` แล้ว)
- หน้าเว็บยังรับ v1 ได้: ถอด pitch ออกจาก `c7_angle` เอง แล้วติดป้าย "เฟิร์มแวร์ v1"
- `GEOMETRY_MISMATCH` เมื่อ `geometry_id` ไม่ตรง

### หน้าผู้ใช้ (`index.html`)
- **โมเดล 3 มิติแบบ skinned mesh ชิ้นเดียว:**
  - กระดูก `chest → c7 → c5 → c3 → C0`
  - ผิวยืดต่อเนื่อง ก้ม เงย หรือยื่นคอแล้วคอไม่หัก 2 ท่อน
  - เส้นวัดมุมวาดจากสูตรชุดเดียวกับตัวเลข
- ข้อความเป็น "มุมคอ (ค่าประมาณ)" ถ้าไม่มี MPU จะบอกว่าไม่มีเซ็นเซอร์ที่ต้นคอ
- สถานะท่า, แถบ ก้ม-เงย / เอียง / หัน, ตั้งท่าเริ่มต้น, แถบเตือน และตั้งค่า เหมือนเดิม
- demo มีช่วงยื่นคอพร้อมเงยหน้าสวน และช่วงก้มดูโต๊ะ

### หน้า dev (`dev.html`)
- แผง "การเชื่อมต่อเซ็นเซอร์" และ "บอร์ด" อยู่บนสุด
- โมเดลในแผงสูตรแสดงแบบกระจกเป็นค่าเริ่มต้นเหมือนหน้าผู้ใช้ และมีสวิตช์ปิดได้
- ใบหน้า คาง และปากหมุนไปกับหัวทั้งชิ้น (เส้นแบ่งหัวกับคอวัดจากสแกน) ตอนก้มหรือเงยจึงไม่บิด
- **แผงใหม่ "สูตรมุมคอ (CVA) ทีละขั้น"** (`assets/dev-formula.js`):
  - ค่าที่รับจากบอร์ด พร้อมที่มาและชนิด (วัดได้ / สมมติ / คำนวณ / ประมาณ / ไม่เข้าสูตร)
  - ตารางค่าคงที่
  - การคำนวณ 8 บรรทัดที่แทนตัวเลขจริง
  - ภาพด้านข้าง SVG หน่วย cm
  - โมเดล 3 มิติที่ขยับตามค่าเดียวกัน
  - เทียบกับ CVA จากบอร์ดและสูตรเก่า
  - ข้อจำกัด
- ข้อมูลจำลองใช้ตัวเลื่อน tilt และติ๊กได้ว่ามี MPU หรือไม่
- หน้า dev ส่งข้อมูลไป API เป็น v2

### โหมดเก็บข้อมูล (บอร์ดเป็น format 2 แล้ว)
- เฟิร์มแวร์:
  - `r` เปิด, `n` ปิด
  - บรรทัด `D` ทุก 20 ms: quaternion/accel/gyro/ความแม่นยำของทั้งสองหู และ accel/gyro ของ MPU เป็นจำนวนเต็มดิบ
  - **format 2 (flash แล้ว 2026-11-10):** ต่อท้ายบรรทัด `D` ด้วยอายุค่า `L_age,R_age,C_age` (ms) และอ่าน BNO ซ้าย-ขวาสลับกันทีละแพ็กเก็ต (`pollEarStep()`) ให้สองหูในบรรทัดเดียวกันมาจากเวลาใกล้กัน header เพิ่ม `age=ms,ear_poll=interleaved`
  - `H` ทุก 5 วินาที, `RATE` ทุก 1 วินาที, JSON v2 ทุก 1 วินาที
- BNO085 ในโหมดนี้: เปิด 0x28 + 0x01 + 0x02 ทุก 20 ms และปิด 0x05/0x08
- `getReadings()` อ่านทุก report ในแพ็กเก็ตเดียวแล้ว (เดิมอ่านแค่ตัวแรก)
- I2C 400 kHz ระหว่างโหมดนี้ กลับเป็น 100 kHz ตอนออก
- MPU ตั้ง DLPF ~44 Hz และอ่าน 14 ไบต์ (เพิ่ม gyro) ทุกโหมด
- `assets/c7-collect.js`:
  - อ่าน `H`/`D` และแปลงหน่วย
  - มุม x/y/z ตาม**แกนของชิป** (ยังไม่ใช่แกนศีรษะ)
  - δ ซ้าย-ขวา แบบไม่ขึ้นกับการติดตั้ง
  - สร้าง CSV และข้อมูลจำลองที่ติดป้าย
  - อ่านได้ทั้ง format 1 และ 2 (`FORMATS`), อายุค่า `.ageMs` และ `skewMs` (เวลาห่างสองหู)
  - ฟังก์ชันสำหรับแกน 3 มิติ: `alignTo()` (จัดแนวหูขวาเทียบหูซ้ายจากท่าเริ่มต้น), `relRotation()`, `worldAxes()`, `worldAcc()`, `worldUpCheck()`, `gravityQuat()` (MPU จากแรงโน้มถ่วง), `dirName()` (ชื่อทิศภาษาไทย)
  - ข้อมูลจำลองใช้โลก ENU (z ขึ้น) แบบเดียวกับ BNO085 และติดชิปสองหูแบบกระจก
- `collect.html` (จัดใหม่ 2026-11-10 ตามที่ผู้ใช้ขอ):
  - จอกว้าง ≥ 1280 px แสดง 3 คอลัมน์ในจอเดียว: **สถานะเซ็นเซอร์ | กราฟ | มุมการหมุน 3 มิติ** (หน้านี้กว้างสุด 1840 px) จอกลาง 2 คอลัมน์ มือถือแถวเดียว
  - สถานะ: การ์ด 3 ตัว (Hz, ความแม่นยำ), ซิงก์สองหู (เวลาห่างเฉลี่ย/สูงสุดใน 1 วิ, อายุค่า, δ), สาย USB (บรรทัด/วินาที, หาย, อ่านไม่ได้, รูปแบบ)
  - กราฟ: มุม/accel/gyro ของ 3 ตัว + δ และเวลาห่างซ้าย-ขวา
  - **มุมการหมุน 3 มิติ** (`assets/axes-view.js`, แทนโมเดลศีรษะ): แกน x/y/z ของเซ็นเซอร์แต่ละตัวในโลก ENU พร้อมคำบอกทิศ (เหนือ/ใต้/ตะวันออก/ตะวันตก/ขึ้น) ลูกศร accel ในทิศโลก โหมดแยกกัน/ซ้อนกัน และตามที่ติดจริง/จัดแนวให้ตรงกัน ตารางค่า (quaternion, มุมแกนชิป, ทิศแต่ละแกน, accel, ความเร่งตัด g, gyro, ความแม่นยำ, อายุค่า, เช็ก z โลกกับแรงโน้มถ่วง) และมุมระหว่างสองหู มุมแบบเฟิร์มแวร์ยังแสดงเป็นตัวเลขไว้เทียบ
  - ส่วนบันทึก ขั้นตอนท่า ข้อมูล session ข้อความจากบอร์ด และ "อ่านค่าในหน้านี้" อยู่ถัดลงไป
  - ดาวน์โหลด CSV 49 คอลัมน์ (เพิ่ม `L_age_ms`, `R_age_ms`, `C_age_ms`) + JSON metadata
- `.gitignore` เพิ่ม `data/` และไฟล์ `SIM_*` ไม่ให้ข้อมูลผู้เข้าร่วมเข้า git

### API
- `save_angle.php`:
  - ตรวจชนิดและช่วงค่า
  - คิด CVA ด้วยสูตรใหม่ทุกครั้ง
  - ปฏิเสธเมื่อ `cva_angle` ไม่ตรงกับสูตร
  - เพิ่มคอลัมน์ `mpu_tilt`, `protocol_version` (CSV ต่อท้ายเป็นคอลัมน์ 8–9, MySQL ALTER อัตโนมัติ)
- `get_latest.php` และ `db_init.sql` อัปเดตตามแล้ว

## ตรวจแล้ว
- `node scripts/check-web.mjs` ผ่าน 37 ข้อ (2026-11-13 เพิ่ม 3 ข้อของ `structure-layout.js`: ชิ้นส่วนในกล่อง C7 อยู่ในกล่อง ไม่ชนกัน ลอดร่องถาดได้ และความสูงรวมตรงกับด้านใน; ตลับและกล่องข้อต่อมีที่ให้หัวต่อ ≥ 8 มม.; ทุกชิ้นมีที่ยึดและสายทุกเส้นลงขาที่มีจริง ขาละ 1 เส้น) (2026-11-10 เพิ่ม 3 ข้อ: format 2/อายุค่า/อ่าน format 1 ได้, จัดแนว/มุมระหว่างหู/ทิศแกน/แรงโน้มถ่วง, simulator เป็นโลก ENU):
  - เดิม 21 ข้อ รวมเทียบกับสูตรที่เขียนแยก (63 จุด) ทิศตามกายวิภาค v1/v2 และ demo ครบ 3 สถานะ
  - ใหม่ 9 ข้อของโหมดเก็บข้อมูล: แปลงหน่วย, บรรทัดเสีย, Euler เทียบสูตรเฟิร์มแวร์, δ ซ้าย-ขวา, seq วนรอบ, CSV, รายการท่า, simulator และสถานะ live
- โหมดเก็บข้อมูล:
  - `SafeBNO085::getReadings()` ดึงออกมา compile ด้วย g++ แล้วป้อนแพ็กเก็ตปลอม (หลาย report ในแพ็กเก็ตเดียว, report ที่ไม่รู้จัก, ตัดกลาง, channel ควบคุม) ผ่านทุกข้อ
  - compile ESP32 Dev Module + core 3.3.12 ผ่าน (flash 71%, RAM 14%) **ยังไม่ได้ flash**
  - `collect.html?demo`: ได้ 50 บรรทัด/วินาที ทั้ง 3 ตัว 50 Hz
  - เดินขั้นตอนท่าจนจบ ได้ CSV 46 คอลัมน์ ป้ายท่า/มุมอ้างอิง/`simulated=1` ถูก และ JSON มีช่วงเวลาแต่ละขั้น
  - ความกว้าง 375 px ไม่ล้น, ธีมสว่างและมืด, console ไม่มี error
  - `index.html?demo` และ `dev.html` (ข้อมูลจำลอง) ยังทำงาน
- `node --check` ไฟล์ `assets/*.js` ทุกไฟล์ผ่าน และ `git diff --check` ผ่าน
- เฟิร์มแวร์:
  - `calculateCVA()` (ดึงออกมา compile ด้วย g++) ตรงกับ JS ต่างไม่เกิน 7.9e-6° ทั้ง 63 จุด
  - compile กับ ESP32 Dev Module + core 3.3.12 ผ่าน (flash 71%, RAM 14%) **ยังไม่ได้ flash**
- PHP:
  - `cva_geometry1()` ตรงกับ JS ต่างไม่เกิน 4.9e-11°
  - ยิง API จริงผ่าน server: v2, v2 ไม่มี MPU, v1, CVA ไม่ตรง, ชนิดผิด และค่าเกินช่วง ได้ผลตามคาด
  - คืนไฟล์ตัวอย่างด้วย `git restore` แล้ว
- เบราว์เซอร์ (โหมดจำลอง):
  - `?demo` ผ่านทั้ง ท่าดี / เริ่มก้มคอ / คอยื่น และแถบเตือนขึ้น "คอยื่นมา 15 วินาทีแล้ว"
  - โมเดลงอต่อเนื่องที่ tilt +15/pitch −6, tilt +5/pitch 45 และ tilt −10/pitch −25
  - ความกว้าง 375 px ไม่ล้นจอทั้งสองหน้า
  - ธีมสว่างและธีมมืด
  - console ไม่มี error

- **บอร์ดจริง (COM3) หลัง flash 2026-11-10:**
  - 460800 baud อ่านได้ปกติ
  - คำสั่ง `r` ได้ `H` และบรรทัด `D` 50 บรรทัดต่อวินาที (`RATE ... out=50`) และ `n` ใช้ได้
  - รอบแรกทุกช่องของเซ็นเซอร์ว่าง เพราะสาย I2C ค้าง LOW (เฟิร์มแวร์รุ่นเก่าก็เป็นเหมือนกัน)
  - **หลังผู้ใช้แก้สายแล้ว flash รุ่นใหม่กลับ:**
    - PinCheck `OK_PULLUP_3V3` ทั้ง 21/22, ACK ครบ 0x4A / 0x4B / 0x68
    - โหมดเก็บข้อมูลได้ `out=52` บรรทัด/วินาที, `RATE` วินาทีที่ 2: L q51/a64/g51, R q40/a47/g88, C7 38
    - บรรทัด `D` มีค่าครบทั้ง 3 ตัว (flags 63 ราวครึ่งหนึ่ง ที่เหลือคือบางตัวไม่มีค่าใหม่ในบรรทัดนั้น)
    - หูขวาตอนบูตไม่ได้ quaternion (rdFail=4) แต่ health check เปิด report ใหม่แล้วมาเอง
    - ความแม่นยำ BNO ตอนบูตเป็น 0 ยังไม่ได้หมุนให้ปรับตัว
- **ซิงก์สองหู + แกน 3 มิติ (2026-11-10, ข้อมูลจำลองเท่านั้น):**
  - compile เฟิร์มแวร์ format 2 กับ ESP32 Dev Module + core 3.3.12 ผ่าน (940596 B / 71%, RAM 48660 B / 14%) และ flash ลง COM3 แล้ว (hash verified)
  - **บอร์ดจริง หูฟังวางนิ่ง จับ 9.4 วินาที (473 บรรทัด):**
    - บรรทัด `D` 35 ช่องครบทุกบรรทัด, header `format=2 ... age=ms,ear_poll=interleaved`, 50.1 บรรทัด/วินาที (`RATE out=50–51`), `n` กลับโหมดปกติได้
    - เวลาห่างซ้าย-ขวา: เฉลี่ย 9.1 ms, มัธยฐาน 6, p95 24, สูงสุด 64 ms (หูขวาได้ quaternion แค่ 42–47/วินาที จึงอายุค่ามากกว่า: L เฉลี่ย 8.2 ms, R 10.7 ms)
    - หูซ้าย: `q·acc` ตรงกับ +z โลก 1.000 ทุกบรรทัด จึงยืนยันว่าโลกของ BNO เป็น z ขึ้น (ENU) และทิศ quaternion ที่หน้าเว็บใช้ถูก
  - `collect.html?demo` ที่ 1700 px: 3 ส่วนอยู่ในจอเดียว, แกน 3 มิติขยับ, แยกกัน/ซ้อนกัน, จัดแนวแล้วแกนหูขวาทับหูซ้ายสนิท (δ 0.0°), เวลาห่างซ้าย-ขวา 1–5 ms, เช็ก z โลก 1.00
  - บันทึก 2 วินาทีได้ 100 แถว CSV 49 คอลัมน์ มีอายุค่า (ดักจาก Blob)
  - 375 px ไม่ล้น (scrollWidth 375), ธีมสว่างและมืด, console ไม่มี error

- **ตรวจทานเฟิร์มแวร์ + โค้ดระบบ (2026-11-10, อ่านโค้ดและรันสคริปต์ ไม่ได้ต่อบอร์ด ไม่ได้แก้โค้ด):**
  - `check-web` 34/34, `node --check assets/*.js`, `git diff --check` ผ่าน
  - สคริปต์ตรวจข้ามที่เขียนแยก (17 ข้อ ผ่านหมด) อ่านค่าคงที่จากไฟล์จริง:
    - ค่าคงที่สูตร, `geometry_id`, baud, `COLLECT_FORMAT` และช่วง clamp ตรงกันทั้งเฟิร์มแวร์ / `c7-core.js` / PHP
    - สูตร CVA เทียบกับเรขาคณิตที่เขียนใหม่ด้วยเมทริกซ์หมุน (φ0 หาด้วย bisection) 898 จุด ต่าง 0
    - `calculateCVA()` จำลองแบบ float32 ต่างจาก JS ไม่เกิน 9.5e-6° และ JSON 2 ตำแหน่งที่บอร์ดพิมพ์ผ่าน `validatePacket` ครบ 898/898 (ต่างสูงสุด 0.005° จากเกณฑ์ 0.15°)
    - `cva_geometry1()` ของ PHP (ดึงจากไฟล์มารันจริง) ต่างจาก JS ไม่เกิน 4.3e-14°
    - `chipEulerDeg` = `quaternionToEulerDeg` ของเฟิร์มแวร์, บรรทัด `D` 35 ช่องแบบที่ `sendCollectLine()` พิมพ์ถอดหน่วยถูก, `lrDeg` / `alignTo` / `worldUpCheck` / `gravityQuat` ถูกตามนิยาม
  - อ่านโค้ดแล้วถูก: scale ของ SH-2 (Q14 / Q8 / Q9 / Q4 / Q12), ความยาว report, ลำดับไบต์ของ Set Feature / ME Calibration / Product ID, MPU6050 (±2 g, ±250 °/s, big-endian)
  - สิ่งที่พบเพิ่ม อยู่ในข้อ 8–13 ของ "ปัญหาที่รู้แล้วแต่ยังไม่ได้แก้"

## ยังไม่ได้ตรวจ
- **หน้า `collect.html` กับบอร์ด format 2:** ตรวจจากการอ่านพอร์ตตรง ๆ ยังไม่ได้เปิดหน้าเว็บต่อบอร์ดจริง และยังไม่ได้ลองหันศีรษะในโหมด "จัดแนวให้ตรงกัน"
- ทิศเหนือมาจากเข็มทิศในชิป (ความแม่นยำหูซ้าย 1 หูขวา 0 ตอนวัด ยังไม่ได้หมุนเลข 8) อาจเพี้ยนใกล้โลหะ
- **ความแม่นยำ BNO ค้างที่ 0 (ผู้ใช้แจ้ง 2026-11-10):** เฟิร์มแวร์เดิมไม่เคยส่งคำสั่ง SH-2 0x07 (Configure ME Calibration) และไม่ได้อ่านเข็มทิศ
  - working tree เพิ่ม `configureCalibration(accel, gyro, mag)` ตอน init และทุกครั้งที่เปิด report, อ่าน report 0x03 (สนามแม่เหล็ก 10 Hz เฉพาะโหมดเก็บข้อมูล) และค่าประมาณความคลาดเคลื่อนของ rotation vector (ไบต์ 12–13)
  - log ใหม่ทุก 1 วินาทีในโหมดเก็บข้อมูล: `ACCURACY L=rv<0-3>/err<องศา>/mag<uT>/a<0-3>/n<report> R=...` สนามแม่เหล็กโลกปกติราว 25–65 uT ถ้าเกินมากแปลว่าแม่เหล็กลำโพงรบกวน
  - compile ผ่าน (941868 B / 71%) **ยังไม่ได้ flash** บรรทัด `D` ไม่เปลี่ยน (ยัง format 2)
- **ค่าหูขวาเสีย (วางนิ่ง, แทนข้อ "gyro หูขวากระโดด" เดิม):**
  - accel z หูขวา 33 จาก 473 บรรทัด (7%) เหลือ ~150 แทน ~2198 คือ **ไบต์สูงของค่าสุดท้ายใน report หายเป็น 0** (0x0896 → 0x0096) ไม่ใช่การขยับ
  - quaternion หูขวาเป็น 0 ทั้งหมด 2 บรรทัด, ความแม่นยำหูขวา 0 ตลอด, `RATE` หูขวา g≈99/วินาที (ขอไว้ 50) และ rdFail R=2
  - หูซ้ายไม่มีอาการนี้ (|a| 9.73–9.80 ทุกบรรทัด) จึงน่าจะเป็นการอ่านแพ็กเก็ตของหูขวาสั้นไป 1 ไบต์ หรือแยก report ผิดใน `receivePacket()` / `getReadings()` ยังไม่ได้แก้
- **โหมดเก็บข้อมูลกับเซ็นเซอร์จริง (ส่วนที่เหลือ):**
  - 50 Hz ต่อเนื่องนานกว่า 2 วินาที และ C7 ได้ 38/วินาทีในวินาทีที่วัด
  - I2C 400 kHz กับสายหูฟังเสถียรหรือไม่
  - การปิด 0x05/0x08 และสลับกลับโหมดปกติ
  - MPU DLPF ไม่ทำให้ `mpu_tilt` ในโหมดปกติเปลี่ยนจนผิด
- ยังไม่ได้เปิดไฟล์ CSV จริงที่ดาวน์โหลดจาก UI (ตรวจผ่านการดัก Blob ในหน้าแทน)
- บอร์ด flash v2 แล้วและส่ง JSON v2 ได้ แต่ **ยังไม่ได้ข้อมูลจากเซ็นเซอร์จริง** เพราะสแกน I2C ไม่พบอุปกรณ์ จึงยังไม่ได้ตรวจตั้งศูนย์, CVA จากบอร์ดเทียบกับเว็บ และทิศแกน
- ค่าคงที่ของสูตร (L, t_z, t_y, g, k) และเกณฑ์ 48 / 43.5 ยังเป็นค่าสมมติ ยังไม่ได้ปรับเทียบกับคนจริง
- ตำแหน่งติด MPU ว่าจับการยื่นคอ (C4–C7) ได้จริงหรือไม่
- การ ALTER ตาราง MySQL (เครื่องนี้ไม่มี MySQL ทดสอบได้แค่ CSV)
- รูปร่างโมเดลในท่าสุดขอบ ตรวจด้วยตาจากภาพเล็กเท่านั้น ยังไม่มีเทสต์อัตโนมัติ

## ปัญหาที่รู้แล้วแต่ยังไม่ได้แก้
0. **(แก้แล้ว 2026-11-10 หลังผู้ใช้แก้สาย) สาย I2C ถูกดึงลง GND (ฮาร์ดแวร์):** ตอนบูต PinCheck ได้ `D21(SDA)=LOW_STUCK` และ `D22(SCL)=LOW_STUCK` ทั้งคู่ จึงไม่มีเซ็นเซอร์ตอบ
   - ครั้งแรกหลัง flash หูซ้าย (0x4A) ส่ง quaternion ได้ 1 ครั้งแล้วหลุด แปลว่าการต่อติด ๆ ดับ ๆ
   - สาเหตุที่เป็นไปได้: SDA/SCL แตะ GND, โมดูลไม่มีไฟเลี้ยงแต่ต่อสายข้อมูลอยู่ (ดึงสายลงผ่านไดโอดป้องกัน) หรือชิปค้างดึงสาย
   - ตอนบัสค้าง health check ทำให้บรรทัด `D` สะดุดราว 450 ms ทุก 3 วินาที (เห็น `out=28` ในวินาทีนั้น)
1. **ทิศแกนในเฟิร์มแวร์** ([docs/SENSOR_AXES.md](docs/SENSOR_AXES.md)): บอร์ดใช้ Euler ตามแกนของชิป ไม่ได้แปลงเป็นแกนศีรษะ
   - ถ้าติดบอร์ดแนบข้างศีรษะ การก้มกับการเอียงจะสลับแกน
   - สองหูเฉลี่ยกันแล้วหักล้างจนเหลือเกือบ 0
2. **เฟิร์มแวร์ใช้ข้อมูลการหมุน 3 แบบปนกัน** (report 0x28/0x05/0x08) ค่าหันหน้ากระโดดได้
3. **การตั้งศูนย์**บังคับท่าตอนนั้นเป็น 52.05° เสมอ จึงวัด CVA จริงของแต่ละคนไม่ได้
4. **แยกเอนตัวทั้งตัวกับคอยื่นไม่ได้** เพราะไม่มีเซ็นเซอร์ที่ลำตัว และ MPU วัดเทียบแรงโน้มถ่วง
5. **MPU ใช้ `atan2(ax, az)` จาก accelerometer อย่างเดียว** ไม่มี gyro/filter จึงสั่นตอนขยับเร็ว และขึ้นกับทิศที่ติดบอร์ด
6. **`api/save_angle.php`** ถ้าไม่มี MySQL แต่ละ request ใช้ราว 2 วินาทีขึ้นไป (timeout PDO) และเขียนลงไฟล์ตัวอย่างที่ git track อยู่
7. ข้อความใน `README.md` ส่วนเฟิร์มแวร์อ้างถึงบัส `Wire1` ที่โค้ดไม่ได้เปิดใช้
8. **เครื่องหมายของ `head_pitch` และ `mpu_tilt` ขึ้นกับการติดตั้ง** (พบจากการตรวจทาน 2026-11-10 ยังไม่ได้ยืนยันกับบอร์ด): สูตรต้องการ pitch บวก = ก้ม และ tilt บวก = เอนหน้า แต่เฟิร์มแวร์ไม่มีค่ากลับเครื่องหมาย
   - จำลองชิปวางราบแกนตรงศีรษะ ก้ม 15° ได้ `head_pitch` −15 (CVA จะเพิ่มแทนที่จะลด)
   - `mpu_tilt` = `atan2(ax, az)` ถ้าติดบอร์ดกลับด้าน การยื่นคอจะทำให้ CVA เพิ่ม
9. **ไม่มี MPU แล้วไวกว่ามาก:** ก้มหน้าอย่างเดียว 10° ได้ 46.3° (เริ่มก้มคอ) และ 20° ได้ 40.5° (คอยื่น) ขณะที่มี MPU และคอไม่ขยับ ก้ม 20° ได้ 48.9° (ยังท่าดี) มาจาก `CVA_EST_GAIN` 0.5 ที่ยังเป็นค่าสมมติ
10. **`receivePacket()` ไม่ดูบิต continuation ของ header แรก:** ถ้าอ่าน chunk กลางแพ็กเก็ตล้มเหลว ส่วนที่เหลือของแพ็กเก็ตนั้นจะถูกอ่านเป็นแพ็กเก็ตใหม่ แล้ว `getReadings()` แยก report จากกลางข้อมูล ค่าเพี้ยนได้ 1 รอบ
11. **เซ็นเซอร์ที่มาช้าตั้งศูนย์ตัวเองเงียบ ๆ:** หูที่เพิ่งต่อ หรือ MPU ที่ไม่ fresh ตอนตั้งศูนย์ จะใช้ค่าแรกที่อ่านได้เป็นศูนย์ (`leftZeroed` / `rightZeroed` / `c7Zeroed`) โดย `calibration_id` ไม่เปลี่ยน ท่าอ้างอิงของแต่ละตัวจึงอาจไม่ใช่ท่าเดียวกัน
12. **timeout ของ I2C ค้างที่ 500 ms** หลัง `initEarSlot()` และ `scanI2CBus()` (ตอน setup ตั้งไว้ 150 ms) ถ้าบัสค้างแต่ละครั้งจะสะดุดนานขึ้น
13. **การลบ Euler ทีละแกนเพี้ยนเมื่อขยับหลายแกนพร้อมกัน:** ชิปแกนตรงศีรษะ ก้ม 30° พร้อมเอียง 20° ได้ yaw ปลอม −10° (เป็นส่วนหนึ่งของข้อ 1 แก้ด้วยการตั้งศูนย์แบบควอเทอร์เนียน)

## งานต่อไป (เรียงตามความสำคัญ)
0. **หาสาเหตุไบต์หายของหูขวา** ใน `receivePacket()` / `getReadings()` (ดูความยาวแพ็กเก็ตและ report ที่ได้จาก 0x4B) ก่อนเก็บข้อมูลจริง
   - ข้อสังเกตจากการตรวจทาน (ยังเป็นสมมติฐาน): payload `[0xFB 5][0x28 14][0x01 10]` ยาว 29 ไบต์ `getData()` อ่านรอบแรก 28 ไบต์ ไบต์สุดท้าย (ไบต์สูงของ accel z) จึงถูกอ่านแยกในรอบที่สองแค่ 5 ไบต์ ตรงกับอาการ ให้ log `lastLen` กับ hex ของแพ็กเก็ตเมื่อ |a| ผิด และลองอ่านทั้งแพ็กเก็ตในครั้งเดียวเมื่อยาวไม่เกิน ~124 ไบต์ที่ 400 kHz
   - อีกทางคือบิตตกจาก 1 เป็น 0 บนสายหูขวาที่ 400 kHz (0x08 มีบิตเดียว) ให้ลอง `COLLECT_I2C_HZ` 200000 เทียบ
   - แล้วเปิด `collect.html` ต่อบอร์ด ลอง "จัดแนวให้ตรงกัน" + หันศีรษะ ดูว่าแกนสองหูทับกัน
2. เปิด `collect.html` กด "เริ่มส่งค่าดิบ" ดูว่าได้ 50 Hz ทั้ง 3 ตัว บรรทัดหาย <1% และ `RATE` ครบ ถ้าไม่ครบให้ปรับ `COLLECT_I2C_HZ` / `COLLECT_REPORT_MS` แล้วเก็บข้อมูลทดลองตาม `docs/DATA_COLLECTION.md`
3. ใช้ "ตรวจทิศทางเซ็นเซอร์" กับหูฟังจริงทีละหู และลองยื่นคอ / ก้ม ดูว่า `mpu_tilt` ขยับจริง บันทึกผลลง WORKLOG
4. แก้ทิศแกนในเฟิร์มแวร์ตาม `docs/SENSOR_AXES.md` (ตั้งศูนย์แบบควอเทอร์เนียน, แปลงแกนต่อหู, report 0x28 อย่างเดียว)
5. ปรับเทียบค่าคงที่และเกณฑ์ด้วย 4 ท่า ตาม `docs/FORMULA.md` หัวข้อ "ปรับเทียบ"
6. ตัดสินใจกับเพื่อนว่าจะรวม branch นี้เข้า upstream อย่างไร (ต้องให้ผู้ใช้สั่งก่อน)
