67160366/C7-earphone-web/docs/DATA_COLLECTION.md

# การเก็บข้อมูลดิบ (collect mode)

ใช้เก็บค่าดิบของเซ็นเซอร์ทั้ง 3 ตัวที่ 50 Hz ไว้ทำ data model ภายหลัง
- หูซ้าย BNO085 0x4A
- หูขวา BNO085 0x4B
- ต้นคอ MPU6050 0x68

หน้าเว็บคือ [`collect.html`](../collect.html) ข้อมูลจำลองเปิดได้ที่ `collect.html?demo`

ข้อมูลนี้ใช้พัฒนาแบบจำลองเท่านั้น ไม่ใช่การวินิจฉัยทางการแพทย์ และไม่ใช้กล้องในขั้นตอนใดเลย

## ภาพรวม
1. เฟิร์มแวร์เปิด USB ที่ **460800 baud** (เดิม 115200) ค่าดิบ 50 Hz ใช้แบนด์วิดท์ราว 9 KB/s ซึ่งเกือบเต็ม 115200
2. คำสั่ง `r` เข้าโหมดเก็บข้อมูล ส่วน `n` กลับโหมดปกติ (JSON v2 ที่ 5 Hz) ส่วน `z` / `i` / `s` ยังใช้ได้ทั้งสองโหมด
3. ระหว่างโหมดเก็บข้อมูล บอร์ดส่ง:
   - บรรทัด `D` ทุก 20 ms
   - บรรทัด `H` ตอนเข้าโหมดและทุก 5 วินาที
   - `[ESP-LOG] RATE ...` ทุก 1 วินาที
   - JSON v2 ทุก 1 วินาที เพื่อให้ปุ่มตั้งท่าเริ่มต้น (`calibration_id`) ยังทำงาน
4. ในโหมดนี้ BNO085 เปิด report 3 ชนิด ทุก 20 ms:
   - `0x28` ARVR rotation vector
   - `0x01` accelerometer
   - `0x02` calibrated gyro

   และปิด `0x05` / `0x08` ไม่ให้ quaternion ปนกันตาม [SENSOR_AXES.md](SENSOR_AXES.md) ข้อ 4
5. บัส I2C เปลี่ยนเป็น 400 kHz ระหว่างเก็บข้อมูล เพราะที่ 100 kHz อ่านไม่ทัน **ยังต้องตรวจกับสายจริง** ว่าไม่หลุด
6. MPU6050 ตั้ง DLPF ~44 Hz, accel ±2 g, gyro ±250 °/s และอ่าน 14 ไบต์ (accel + gyro) ทุก 20 ms
7. **ซิงก์สองหู:** บอร์ดอ่าน BNO ซ้ายและขวาสลับกันทีละแพ็กเก็ต (เดิมอ่านซ้ายจนหมดแล้วค่อยอ่านขวา) และจดเวลาที่อ่าน quaternion ของแต่ละตัวได้ ส่งเป็นอายุค่าท้ายบรรทัด `D` หน้าเว็บจึงบอกได้ว่าค่าของสองหูในบรรทัดเดียวกันห่างกันกี่ ms
   - เวลานี้คือเวลาที่ ESP32 อ่านได้ ไม่ใช่เวลาที่ชิปวัด (ชิปมีหน่วงภายในอีกเล็กน้อย และไม่ได้ต่อขา INT จึงไม่ได้ใช้ timestamp ของชิป)

## รูปแบบบรรทัด (format 2)

### `H` (header)
```
H,format=2,boot_id=123,calibration_id=1,rate_hz=50,i2c_hz=400000,bno_q=14,bno_acc_q=8,bno_gyro_q=9,mpu_acc_lsb_g=16384,mpu_gyro_lsb_dps=131,age=ms,ear_poll=interleaved,left=1,right=1,c7=1
```
หน้าเว็บอ่านได้ทั้ง format 1 และ 2 (`C7.Collect.FORMATS`) ถ้าเป็น 1 จะเตือนว่าไม่มีอายุค่า ถ้าเป็นเลขอื่นจะเตือนให้อัปเดต ถ้าเปลี่ยนลำดับคอลัมน์ของ `D` ต้องเพิ่ม `COLLECT_FORMAT` ในเฟิร์มแวร์และ `FORMAT` ใน `assets/c7-collect.js` พร้อมกัน

### `D` (ค่าดิบ 1 จังหวะ)
```
D,seq,t_ms,flags, L_qw,L_qx,L_qy,L_qz,L_ax,L_ay,L_az,L_gx,L_gy,L_gz,L_acc, R_...(11 ค่า), C_ax,C_ay,C_az,C_gx,C_gy,C_gz, L_age,R_age,C_age
```
มีทั้งหมด 35 ช่องรวม `D` (format 1 มี 32 ช่อง ไม่มีอายุค่า 3 ช่องท้าย) ทุกค่าเป็นจำนวนเต็มดิบ ตัวที่ไม่ fresh ส่งเป็นช่องว่างทั้งชุด รวมช่องอายุค่าของตัวนั้น

| ช่อง | ความหมาย |
| --- | --- |
| `seq` | ตัวนับ 16 บิต (วนรอบที่ 65536) ใช้นับบรรทัดที่หาย เริ่ม 0 ใหม่ทุกครั้งที่เข้าโหมด |
| `t_ms` | `millis()` ของ ESP32 |
| `flags` | bit0–2 = หูซ้าย / หูขวา / C7 fresh (ได้ค่าภายใน 500 ms), bit3–5 = มีค่าใหม่ตั้งแต่บรรทัดก่อน |
| `q` | quaternion w,x,y,z ของ report 0x28, Q14 (หาร 16384) |
| `a` (BNO) | accelerometer m/s², Q8 (หาร 256) รวมแรงโน้มถ่วง |
| `g` (BNO) | gyro rad/s, Q9 (หาร 512) |
| `acc` | ความแม่นยำของ rotation vector 0–3 (3 = ดีมาก) |
| `C_a` | MPU accel, 16384 LSB/g |
| `C_g` | MPU gyro, 131 LSB/(°/s) |
| `L_age`, `R_age`, `C_age` | ms ระหว่างที่ ESP32 อ่านค่านั้นได้ จนถึง `t_ms` ของบรรทัดนี้ ผลต่าง `|L_age − R_age|` คือเวลาห่างของสองหู |

ถ้าบัสอ่านไม่ทัน บรรทัด `D` ยังออกทุก 20 ms โดยใช้ค่าล่าสุดซ้ำ ให้ดูจาก bit3–5 และ `RATE`

## ไฟล์ที่ได้จากหน้าเว็บ
กดดาวน์โหลดได้ 2 ไฟล์ ชื่อ `<รหัส>_s<รอบ>_<YYYYMMDD-HHMMSS>` ข้อมูลจำลองขึ้นต้นด้วย `SIM_`

### CSV (49 คอลัมน์)
| คอลัมน์ | หน่วย / ความหมาย |
| --- | --- |
| `t_host_ms` | ms นับจากกดเริ่มบันทึก (นาฬิกาเบราว์เซอร์) |
| `seq`, `t_dev_ms`, `flags` | ตามบรรทัด `D` |
| `label` | ป้ายท่าตอนนั้น (`transition` = ช่วงเปลี่ยนท่า, `free` = ไม่ได้อยู่ในขั้นตอน) |
| `step` | ลำดับขั้นในรายการท่า (ว่าง = ตั้งป้ายเอง) |
| `ref_angle_deg` | มุมอ้างอิงที่วัดด้วยมือ (ว่าง = ไม่ได้วัด) |
| `L_qw..L_qz` | quaternion หน่วย |
| `L_ax..L_az` | m/s² |
| `L_gx..L_gz` | °/s |
| `L_acc` | ความแม่นยำ 0–3 |
| `L_ex, L_ey, L_ez` | มุม Euler ตาม**แกนของชิป** (สูตรเดียวกับ `quaternionToEulerDeg()`) ยังไม่ใช่ก้ม/เอียง/หันของศีรษะ |
| `R_...` | แบบเดียวกับหูซ้าย |
| `C_ax..C_az`, `C_gx..C_gz` | MPU, m/s² และ °/s |
| `C_ex`, `C_ey` | มุมจาก accel: `atan2(ay, az)`, `atan2(ax, az)` (`C_ey` คือค่าเดียวกับ `mpu_tilt_raw`) |
| `C_ez_gyro` | gyro z ของ MPU รวมสะสมตั้งแต่เริ่มบันทึก **ลอยไปเรื่อย ๆ** ใช้ดูแนวโน้มสั้น ๆ เท่านั้น |
| `L_age_ms`, `R_age_ms`, `C_age_ms` | อายุค่าจากบรรทัด `D` (ms) ว่าง = เฟิร์มแวร์ format 1 หรือเซ็นเซอร์ไม่ fresh |
| `lr_deg` | มุมที่สองหูหมุนต่างกัน นับจากตอนตั้งท่าเริ่มต้น (ค่าสูง = หูฟังหลวม) |
| `simulated` | 1 = ข้อมูลจำลอง |

เก็บค่าดิบไว้ครบ จึงคำนวณ feature ใหม่ (เช่น tare แบบควอเทอร์เนียน หรือแปลงแกนชิปเป็นแกนศีรษะ) ภายหลังได้โดยไม่ต้องเก็บใหม่

### JSON (metadata)
เก็บข้อมูลเหล่านี้:
- ข้อมูล session (รหัส, รอบ, ตำแหน่งติดเซ็นเซอร์, หมายเหตุ)
- header `H` ล่าสุด, `boot_id` และ `calibration_id`
- รายการท่าที่ตั้งไว้ และช่วงเวลาจริงของแต่ละขั้น (`steps`)
- มุมอ้างอิงที่กรอก, จำนวนบรรทัดที่หาย, ชื่อคอลัมน์ และหน่วย

## หน้าจอ: สถานะ กราฟ และมุมการหมุน 3 มิติ
จอกว้าง (≥ 1280 px) แสดง 3 คอลัมน์ในจอเดียว: สถานะเซ็นเซอร์ | กราฟ | มุมการหมุน 3 มิติ ส่วนบันทึก ขั้นตอนท่า ข้อมูล session และข้อความจากบอร์ดอยู่ถัดลงไป จอกลางเป็น 2 คอลัมน์ (สถานะ + 3 มิติ แล้วกราฟเต็มแถว) จอมือถือเรียงเป็นแถวเดียว

### มุมการหมุน 3 มิติ (`assets/axes-view.js`)
แทนโมเดลศีรษะเดิม แต่ละเซ็นเซอร์วาดเป็นแกน x (ส้ม) / y (เขียว) / z (ม่วง) ของชิปเอง พร้อมแผ่นแทนตัวชิป และลูกศร **a** = accel ในทิศโลก (`q · acc` ตอนนิ่งต้องชี้ขึ้น)
- **ทิศโลก:** ใช้ค่าเริ่มต้นของ BNO085 คือ ENU: x = ตะวันออก, y = เหนือแม่เหล็ก, z = ขึ้น ฉากใช้แกนนี้ตรง ๆ ไม่สลับหรือกลับแกน
  - แถว "z โลกตรงแรงโน้มถ่วง" ในตาราง = cos ระหว่าง `q · acc` กับ +z ตอนนิ่ง (`C7.Collect.worldUpCheck()`) ใกล้ 1.00 แปลว่าสมมติฐานนี้ถูก **ยังไม่ได้ตรวจกับบอร์ดจริง**
- **ตามที่ติดจริง:** หมุนตาม quaternion ดิบ สองหูติดกลับด้านกัน (กระจก) จึงชี้คนละทาง และ "ขวาเทียบซ้าย ตามที่ติดจริง" ควรใกล้ 180°
- **จัดแนวให้ตรงกัน:** ใช้ quaternion ตอนกด "ตั้งท่าเริ่มต้น" `qR_aligned = qR · qR0⁻¹ · qL0` (`alignTo()`) คือหูขวาที่เหมือนติดแนวเดียวกับหูซ้าย ถ้าศีรษะหมุนทั้งชิ้น แกนสองหูจะซ้อนกันสนิท มุมที่เหลือ = δ (`lr_deg`) และ "ต่างรอบแกน x y z" บอกว่าต่างรอบแกนไหนของชิปซ้าย
- **แยกกัน / ซ้อนกัน:** ซ้อนกันวางทุกแกนไว้จุดเดียว หูขวาเป็นเส้นจาง และซ่อนต้นคอ
- **ต้นคอ C7:** MPU ไม่มี quaternion จึงวาดจากแรงโน้มถ่วงอย่างเดียว (`gravityQuat()`) รู้แค่เอียง ไม่รู้ทิศหัน ตารางจึงบอกแค่มุมเหนือ/ใต้แนวราบของแต่ละแกน
- ตารางใต้ภาพ: quaternion, มุมรอบแกนชิป, ทิศที่แต่ละแกนชี้ (เช่น "เหนือ ↑12°"), accel และขนาด, ความเร่งเมื่อตัดแรงโน้มถ่วง, gyro และความเร็วหมุนรวม, ความแม่นยำ, อายุค่า
- "มุมแบบเฟิร์มแวร์" ยังคิดแบบเดียวกับเฟิร์มแวร์ทุกขั้น (`C7.Collect.firmwareHead()`: Euler แกนชิปลบท่าเริ่มต้น ค่ากลางสองหู) ไว้เทียบ ถ้าเลขไม่ตรงท่าแปลว่าเฟิร์มแวร์ต้องแก้ตาม [SENSOR_AXES.md](SENSOR_AXES.md)
- ข้อมูลจำลองติดชิปแบบกระจกเหมือนหูฟังจริง (หูขวา x หน้า y ขึ้น z ออกขวา, หูซ้าย x หลัง y ขึ้น z ออกซ้าย) ในโลก ENU หันหน้าไปทิศเหนือ

## วิธีเก็บข้อมูลที่แนะนำ

### ก่อนเริ่ม
1. ใส่หูฟังให้แน่น ติด MPU ที่ปุ่มกระดูก C7 ด้วยเทปให้ตำแหน่งเดิมทุกครั้ง และจดตำแหน่งในช่อง "ตำแหน่งติดเซ็นเซอร์"
2. กด "เริ่มส่งค่าดิบ" แล้วรอให้แผงสถานะขึ้น "สัญญาณพร้อมบันทึก" ซึ่งแปลว่า:
   - ทั้ง 3 ตัวได้ราว 50 Hz
   - บรรทัดหายน้อยกว่า 1%
   - ความแม่นยำ BNO 2 ขึ้นไป
3. ถ้าความแม่นยำต่ำ ให้หมุนศีรษะเป็นเลข 8 ช้า ๆ ราว 10 วินาที (รายการท่ามาตรฐานมีขั้น `calib_fig8` ให้แล้ว)
4. นั่งหลังตรง มองตรง แล้วกด "ตั้งท่าเริ่มต้น"
   - ค่าดิบไม่เปลี่ยน แต่ `lr_deg` และ JSON v2 จะนับจากท่านี้
   - จะ tare ใหม่ตอนวิเคราะห์ก็ได้

### ระหว่างเก็บ
1. ใช้ปุ่ม "เริ่มตามขั้นตอน" หน้าเว็บจะเริ่มบันทึก นับถอยหลัง และส่งเสียงทุกท่า
   - ระหว่างท่ามีช่วง `transition` (ค่าเริ่มต้น 3 วินาที) ตอนวิเคราะห์ให้ตัดช่วงนี้ หรือใช้เป็นข้อมูลการเคลื่อนไหว
2. ค้างท่าละ 20–30 วินาที ท่ามาตรฐาน:

| ป้าย | ท่า | ทำไม |
| --- | --- | --- |
| `neutral` | นั่งตรง มองตรง | ฐานอ้างอิง ทำซ้ำหลายครั้งระหว่างรอบ |
| `forward_head` | ยื่นคอไปหน้า ตามองจอ | คอยื่นแบบหัวตรง ซึ่งเซ็นเซอร์ที่หูอย่างเดียวจับยาก |
| `text_neck` | ก้มดูมือถือ | ก้มทั้งคอ |
| `desk_down` | ก้มดูโต๊ะ | ก้มหัวเป็นหลัก |
| `look_up` | เงยหน้า | ทิศตรงข้าม |
| `chin_tuck` | เก็บคาง | ทิศตรงข้ามของคอยื่น |
| `tilt_left` / `tilt_right` | เอียงหูลงหาไหล่ | roll |
| `turn_left` / `turn_right` | หันหน้า | yaw |
| `lean_back` | เอนหลังพิงเก้าอี้ | ลำตัวเอน คอไม่ยื่น |
| `trunk_forward` | โน้มตัวทั้งตัวไปหน้า คอตรง | ไว้แยกการเอนตัวออกจากคอยื่น (ปัญหาข้อ 4 ใน HANDOFF) |

3. **มุมอ้างอิง (ถ้าต้องการโมเดลประมาณ CVA):**
   - ระหว่างค้างท่า ให้อีกคนวัดมุมแนว C7 ถึงติ่งหูเทียบแนวนอน ด้วยไม้โปรแทรกเตอร์, goniometer หรือแอป inclinometer ในมือถือ (ใช้ accelerometer ไม่ใช่กล้อง)
   - กรอกตัวเลขแล้วกด "ใช้กับท่านี้"
   - ค่าจะติดเฉพาะแถวตั้งแต่ตอนกดจนจบท่านั้น
4. ถ้าทำท่าผิดหรือมีอะไรรบกวน ให้กด "ข้ามขั้นนี้" หรือตั้งป้ายเองด้วยปุ่มหรือคีย์ 1–9 แล้วจดในหมายเหตุ

### ต่อคนและต่อชุดข้อมูล
1. **ทำ 3 รอบต่อคน:**
   - กด "สลับลำดับ" ก่อนแต่ละรอบ ให้ลำดับท่าไม่เหมือนกัน
   - ถอดและใส่หูฟังใหม่ระหว่างรอบ ให้โมเดลเจอความต่างของการติดตั้ง
   - เปลี่ยน "รอบที่" ทุกครั้ง
2. **ช่วงใช้งานจริง:** หลังจบรอบ ให้ทำงานหน้าคอมตามปกติ 5–10 นาทีโดยไม่สั่งท่า (ป้าย `free`) ไว้ทดสอบว่าโมเดลใช้ได้นอกท่าที่สั่ง
3. **จำนวนคน:** ตั้งเป้าอย่างน้อย 8–10 คน ให้มีทั้งเพศ ส่วนสูง และทรงผมต่างกัน (ทรงผมมีผลกับการติดหูฟัง)
4. **แบ่ง train/test ตามคน** (leave-one-subject-out หรือ group k-fold)
   - ห้ามสุ่มแถวจากคนเดียวกันไปอยู่ทั้งสองชุด เพราะแถวที่ติดกันที่ 50 Hz แทบเหมือนกัน คะแนนจะสูงเกินจริง
5. **การเตรียม feature เบื้องต้น:**
   - ตัด `transition` และ 2 วินาทีแรกของแต่ละท่าออก
   - ตัดเป็นหน้าต่าง 1–2 วินาที (50–100 แถว) ซ้อนกันครึ่งหนึ่ง
   - ใช้ค่าเฉลี่ยและส่วนเบี่ยงเบนของ quaternion ที่ tare แล้ว, accel, gyro และมุม MPU

### ความเป็นส่วนตัวและการเก็บไฟล์
- ใช้รหัส (P01, P02, …) แทนชื่อ ตารางจับคู่รหัสกับชื่อเก็บแยกไว้นอก repo
- ไฟล์ข้อมูลอยู่ในเครื่องที่ดาวน์โหลดเท่านั้น หน้าเว็บไม่ส่งไปที่ไหน
- **ห้าม commit ไฟล์ข้อมูลเข้า git** ให้เก็บในโฟลเดอร์ `data/` (อยู่ใน `.gitignore` แล้ว)
- ขอความยินยอมจากผู้เข้าร่วมก่อนเก็บ และบอกว่าเป็นข้อมูลเพื่อพัฒนา ไม่ใช่การวินิจฉัย

## สิ่งที่ยังไม่ได้ตรวจกับบอร์ดจริง
ดูสถานะล่าสุดใน [HANDOFF.md](../HANDOFF.md) ตอนเขียนเอกสารนี้ยังไม่ได้ flash และยังไม่ได้ต่อเซ็นเซอร์ จึงยังไม่รู้ว่า:
- ได้ 50 Hz ครบทุก report ต่อหูหรือไม่ (ดู `[ESP-LOG] RATE`)
- I2C 400 kHz กับสายหูฟังจริงเสถียรหรือไม่ ถ้าไม่ ให้ลด `COLLECT_I2C_HZ` หรือ `COLLECT_REPORT_MS`
- 460800 baud กับชิป USB ของบอร์ดใช้ได้หรือไม่
