67160366/C7-earphone-web/docs/SENSOR_AXES.md

# ทิศทางแกนเซ็นเซอร์: หน้าเว็บกับเฟิร์มแวร์

## ทิศที่หน้าเว็บและสูตร CVA ใช้
`C7.cvaParts()` ใน `assets/c7-core.js`, `calculateCVA()` ในเฟิร์มแวร์, `cva_geometry1()` ใน PHP และโมเดล 3 มิติ (`assets/neck-model.js`) ใช้ทิศเดียวกัน คือศีรษะหันหน้าไปทาง +Z, แกน Y ชี้ขึ้น และหมุนแบบ Euler ลำดับ YXZ (ใช้กับโมเดล)
สูตร CVA อธิบายใน [FORMULA.md](FORMULA.md)

| ค่า (protocol v2) | ค่าบวกหมายถึง | ผลต่อ CVA |
| --- | --- | --- |
| `head_pitch` | ก้มหน้า (คางลง) | ติ่งหูหมุนรอบ C0 ลดลงเล็กน้อย (ก้ม 20° ลดราว 3°) |
| `head_roll` | เอียงหูขวาลงหาไหล่ขวา | ไม่เข้าสูตร |
| `head_yaw` | หันหน้าไปทางซ้ายของผู้สวม | ไม่เข้าสูตร |
| `mpu_tilt` | MPU ที่ต้นคอเอนไปข้างหน้าเทียบตอนตั้งศูนย์ (`null` = ไม่มี MPU) | CVA ลดลงราว 0.85° ต่อ 1° |

Protocol v1 ส่ง `c7_angle = −9 + ΔMPU + 0.35·pitch` (ผสม pitch) แทน `mpu_tilt` หน้าเว็บยังรับ v1 ได้โดยถอดกลับเป็น `tilt = c7_angle + 9 − 0.35·pitch`
ทั้งสี่ที่ตรงกันในเชิงซอฟต์แวร์: JS กับ PHP ต่างกันไม่เกิน 1e-10° และเฟิร์มแวร์ (float) ต่างไม่เกิน 1e-5° บน 63 จุด
`scripts/check-web.mjs` ตรวจเทียบกับสูตรที่เขียนแยกไว้อีกชุด
หน้าผู้ใช้แสดงแบบกระจกเป็นค่าเริ่มต้น เมื่อผู้ใช้เอียงหูขวาลง ภาพจะเอียงไปทางขวาของจอเหมือนส่องกระจก ถ้าปิดแบบกระจก ภาพจะเป็นเหมือนมองคนอื่นที่หันหน้าเข้าหาเรา และจะดูเหมือน "เอียงผิดด้าน"

## ปัญหาที่เฟิร์มแวร์ (ยังไม่ได้แก้ ต้องยืนยันกับบอร์ดจริง)
`quaternionToEulerDeg()` แปลงควอเทอร์เนียนของ BNO085 เป็น Euler ตาม**แกนของชิปเอง** แล้ว `calibrateNeutralPosture()` ลบค่าตอนตั้งศูนย์ออกทีละแกน
จากนั้นเฉลี่ยสองหูด้วย `circularMidpointDeg()` โดยไม่มีการแปลงจากแกนชิปเป็นแกนศีรษะเลย ชื่อ pitch/roll/yaw จึงตรงกับท่าจริงก็ต่อเมื่อชิปวางขนานกับแกนศีรษะพอดี

ผลจำลองด้วยสูตรของเฟิร์มแวร์ (`quaternionToEulerDeg` + ลบค่าตั้งศูนย์ + ค่ากลางสองหู):

| การติดตั้ง | ท่า | หูซ้าย | หูขวา | ค่าที่ส่งออก |
| --- | --- | --- | --- | --- |
| ชิปวางราบ แกนตรงกับศีรษะ | ก้ม 15° | pitch −15 | pitch −15 | pitch **−15** (เครื่องหมายกลับถ้าแกน X ของชิปชี้ไปทางขวา) |
| แผ่นบอร์ดตั้งแนบข้างศีรษะ ชิปหันออกด้านนอก | ก้ม 15° | roll −15 | roll +15 | ทุกค่า **0** |
| แบบเดียวกัน | เอียงหูขวาลง 15° | pitch −15 | pitch +15 | ทุกค่า **0** |
| แบบเดียวกัน | หันซ้าย 20° | yaw +20 | yaw +20 | yaw +20 |

สรุปจากผลจำลอง:
1. ถ้าติดแผ่นบอร์ดแนบข้างศีรษะ การก้มจะไปออกที่ `roll` และการเอียงไปออกที่ `pitch` คือแกนสลับกัน
2. ทิศ (+/−) ขึ้นกับว่าติดหูข้างไหน ถ้าใช้สองหูพร้อมกัน ค่า pitch และ roll ที่เฉลี่ยออกมาจะหักล้างกันจนเหลือเกือบ 0
3. ตอนนี้ทดสอบกับบอร์ดจริงที่มี BNO ตัวเดียว (หูขวา 0x4B) จึงยังไม่เห็นการหักล้าง แต่จะเห็นอาการแกนสลับหรือเอียงผิดด้าน ซึ่งตรงกับที่สังเกตได้

## วิธีตรวจกับบอร์ดจริง
เปิด `dev.html` แล้วใช้ส่วน **ตรวจทิศทางเซ็นเซอร์**: ตั้งท่าเริ่มต้น จากนั้นก้มหน้า เอียงหูขวาลง และหันซ้ายตามลำดับ
หน้าจะบอกว่าแต่ละท่าไปออกที่แกนไหนและเครื่องหมายถูกหรือไม่ ให้ตรวจทีละหูด้วย โดยถอดหูอีกข้างออกหรือดูสถานะ fresh

## ข้อเสนอแก้เฟิร์มแวร์
1. ตั้งศูนย์แบบควอเทอร์เนียนตาม `base_plan.md` §4.1: `q_rel = q_tare⁻¹ ⊗ q_now` ต่อหู แทนการลบ Euler
2. แปลงแกนชิปเป็นแกนศีรษะต่อหูด้วยค่าคงที่ที่ได้จากการตรวจด้านบน เช่น `q_head = M ⊗ q_rel ⊗ M⁻¹` (M ของหูซ้ายและขวาไม่เหมือนกัน)
3. แปลง `q_head` เป็น pitch/roll/yaw ตามทิศในตารางแรก แล้วค่อยเฉลี่ยสองหู
4. ใช้ report ชนิดเดียว (0x28 ARVR-stabilized rotation vector) ไม่ปนกับ 0x05/0x08 เพื่อไม่ให้ yaw กระโดด

การแก้ทั้งหมดนี้ต้อง compile และตรวจกับบอร์ดจริงก่อนถือว่าเสร็จ หน้าเว็บไม่ควรสลับหรือกลับเครื่องหมายแกนเอง
