67160366/C7-earphone-web/docs/SHOPPING_LIST.pdf

รายการสั่งซื้อ: ซื้ | ชุดต่อสายหูฟัง C7
ราคาและสต็อกดูจากห ดู | น้าร้านเ ร้ | มื่อ 13 พ.ย. 2026 อาจเปลี่ยนได้ ใด้ | ห้เห้ | ช็กอีกคอี | รั้งก่อนกดสั่ง ผังผั | ต่อสายและตำ แหน่งอุปกรณ์อยู่ในห ยู่ | น้า wiring.html
มีแมี | ล้วล้ | ไม่ต้ม่ | อต้ | งซื้อซื้
ของ | จำ นวน | หมายเหตุ
BNO085 (Adafruit #4754) | 2 | หูซ้หู าซ้ ย 0x4A, หูขหู วา 0x4B
GY-521 MPU6050 | 1 | ต้อต้ งมีก้มี าก้ นขาตัวตั ผู้บัผู้ ดบั กรีแรี ล้วล้
ESP32 DevKit V1 30 ขา | 1
แบต LiPo 3.7 V | 1
กล่อง C7 และตลับลั ข้าข้ งหู | 1 + 2 | พิมพิ พ์ 3 มิติมิ เติ อง
1. สายและข้อข้ | ต่อ (ต้อต้ | งซื้อซื้ | )
ซื้อจาก Ar ซื้ | duitronics ร้านเ ร้ | ดียวไ ดี | ด้ครบ ด้
# | ของ | รุ่นรุ่ / รหัสหั ร้าร้ น | ขนาด / ความยาว | จำ นวน | ราคาต่อ ชิ้นชิ้ | รวม | สต็อก | ใช้ตช้ รงไหน

1 | SparkFun Qwiic Adapter (https://www.arduitronics.com/product/1997/sparkfun-qwiic-adapter) | AG00305 | ช่อง Qwiic 2 ช่อง + รู 4 รู (GND, 3V3, SDA, SCL) ขนาดแผ่นร้าร้ นไม่ระบุ | 4 | 95 | 380 | พร้อร้ ม ส่ง | จุดจุ แยกในกล่อง 2 แผ่น, ข้อข้ ต่อกลางสายหูข้หู าข้ งละ 1 แผ่น
2 | Flexible Qwiic Cable 200 mm (https://www.arduitronics.com/product/6809/flexible-qwiic-cable-200mm-sparkfun-usa-%E0%B8%AA%E0%B8%B2%E0%B8%A2%E0%B8%AD%E0%B9%88%E0%B8%AD%E0%B8%99-%E0%B8%A2%E0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) | AG30260 | 20 ซม. หัวหั JST 1.0 มม. 4 ขา ฉนวนซิลิซิ โลิ คน | 4 | 120 | 480 | พร้อร้ ม ส่ง | สายหู → กล่อง ข้าข้ งละ 2 เส้นส้ (รวมข้าข้ งละ 40 ซม.)
3 | Flexible Qwiic Cable 100 mm (https://www.arduitronics.com/product/6808/flexible-qwiic-cable-100mm-sparkfun-usa-%E0%B8%AA%E0%B8%B2%E0%B8%A2%E0%B8%AD%E0%B9%88%E0%B8%AD%E0%B8%99-%E0%B8%A2%E0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) | AG20260 | 10 ซม. หัวหั JST 1.0 มม. 4 ขา ฉนวนซิลิซิ โลิ คน | 1 | 120 | 120 | พร้อร้ ม ส่ง | ในกล่อง: Adapter 1 → Adapter 2
4 | สาย Jumper Female to Female 40 × 10 cm (https://www.arduitronics.com/product/2588/%E0%B8%AA%E0%B8%B2%E0%B8%A2-jumper-female-to-female-40-x-10cm) | SD20033 | 10 ซม. หัวหั ตัวตั เมียมี 2.54 มม. 40 เส้นส้ /แพ | 1 แพ | 27 | 27 | สั่งซื้อซื้ ได้ | ใช้ 10 เส้นส้ : ESP32 → Adapter 1 (4), Adapter 2 → GY-521 (4), MT3608 → ESP32 (2)
5 | ก้าก้ งปลาตัวตั ผู้ขผู้ าตรง 1 × 40 ขา 2.54 มม. (https://www.arduitronics.com/product/487/%E0%B8%81%E0%B9%89%E0%B8%B2%E0%B8%87%E0%B8%9B%E0%B8%A5%E0%B8%B2-40p-2-54mm-pin-header-dip-straight-single-row-1-x-40-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) | SKU-00487 | ขายาว 11 มม. หักแหั บ่งบ่ ได้ | 1 เส้นส้ | 5 | 5 | พร้อร้ ม ส่ง | หัก หั 4 ขา 2 ชิ้นชิ้ บัดบั กรีบรี น Adapter 1 และ 2

รวมหมวด 1: 1,012 บาท (ไม่รวมค่าส่ง)
ทางเลือกของ ลื | ข้อ 3: ข้ | สาย Qwiic 50 mm ของ Cytron ไทย (https://th.cytron.io/p-stemmaqt-qwiic-jst-sh-4-pin-cable-50mm-long) รหัส WR-SQ-50MM ราคา 10 บาท หั | มีของ 18 เ มี | ส้น ส้ | ถูกกถู | ว่า 110 บาท แต่ต้องต้ | จ่ายค่าส่งอีกอี | ร้านร้

2. ชุดไฟแบต (ซื้อซื้ | เฉพาะที่ยัที่ | งยั | ไม่มีม่ | )มี
# | ของ | รุ่นรุ่ / รหัสหั ร้าร้ น | ขนาด | จำ นวน | ราคา | สต็อก | หมายเหตุ

6 | TP4056 1A Type-C มีวมี งจร ป้องกันกั (https://www.arduitronics.com/product/2610/tp4056-1a-type-c-usb-battery-charger-board-with-protection-2) | Arduitronics AG10211 | 26 × 17 มม. | 1 | 30 | พร้อร้ มส่ง | ชาร์จร์ 5 V สูงสู สุดสุ 1 A ตัดตั ที่ 4.2 V ต้อต้ งเป็นรุ่นรุ่ ที่มีที่ ขมี า OUT+ / OUT-
7 | MT3608 DC-DC Step Up 2A (https://www.allnewstep.com/product/961/2a-dc-dc-step-up-booster-power-mt3608-2) | ArduinoAll | ร้าร้ นไม่ได้เด้ ปิดดู ขนาดทั่วไปราว 36 × 17 มม. | 1 | ราว 20– 40 | ยังยั ไม่ได้ เช็ก | ตั้งไฟออก 5.0 V ก่อนต่อ ESP32
8 | สวิตวิ ช์เช์ลื่อน SS12D00 G3 (https://www.arduitronics.com/product/3365/%E0%B8%AA%E0%B8%A7%E0%B8%B4%E0%B8%95%E0%B8%8A%E0%B9%8C%E0%B9%80%E0%B8%A5%E0%B8%B7%E0%B9%88%E0%B8%AD%E0%B8%99-on-off-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) | Arduitronics SD00273 | 3 ขา ก้าก้ นยาว 3 มม. | 1 | 2.50 | พร้อร้ มส่ง | คั่นสาย OUT+ ระหว่าง TP4056 กับกั MT3608
MT3608 อีกอี | ร้าน: ร้ | Arduitronics (https://www.arduitronics.com/product/1230/dc-to-dc-boost-step-up-module-2v-24v-to-5v-28v-2) (เปิดหน้าไม่ได้ตอน ด้ | ค้น ค้ | ยังไยั | ม่รู้ราคา) และ รู้ | CyberTice รุ่น Mini รุ่ (https://cybertice.com/product/699/2a-dc-dc-step-up-booster-power-mt3608-2-24v-to-5-28v-2a)
3. ของประกอบ (ซื้อซื้ | เฉพาะที่ยัที่ | งยั | ไม่มีม่ | )มี
# | ของ | รุ่นรุ่ / รหัสหั ร้าร้ น | ขนาด / ความยาว | จำ นวน | ราคา | สต็อก | ใช้ตช้ รงไหน

9 | ที่ดที่ ามนิ้วนิ้ อะลูมิลู เมิ นียม JASMINE (https://rakmor.com/product/finger-splint-rmm-fs002/) | rakmor RMM-FS002 | ยาว 18 นิ้วนิ้ (45.7 ซม.) เลือลื ก กว้าว้ ง ¾ นิ้วนิ้ | 1 | 460–560 ตาม ความกว้าว้ ง | ข้อข้ มูลเก่าราว 5 เดือดื น ต้อต้ งเช็ก | โครงพาดบ่าบ่ ยึดยึ กล่อง C7
10 | สายไฟอ่อน 26AWG UL1007 10 ม. สีแสี ดงและสีดำสี ดำ (https://www.arduitronics.com/search?q=26AWG) | Arduitronics AG00822, AG00823 | 26AWG ไส้ฝอส้ ย ม้วม้ นละ 10 ม. | อย่าย่ งละ 1 | 45 ต่อม้วม้ น | สั่งซื้อซื้ ได้ | วงจรแบต และสายสั้นสั้ 3Vo → DI บน BNO085 ขวา
11 | ชุดชุ ท่อหดสีดำสี ดำ 385 ชิ้นชิ้ (https://www.arduitronics.com/product/2108/%E0%B8%8A%E0%B8%B8%E0%B8%94%E0%B9%80%E0%B8%8B%E0%B8%95-%E0%B8%97%E0%B9%88%E0%B8%AD%E0%B8%AB%E0%B8%94%E0%B8%AA%E0%B8%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) | Arduitronics AG10320 | 1–12 มม. ยาว 40–90 มม. | 1 ชุดชุ | 160 | พร้อร้ มส่ง | หุ้มหุ้ จุดจุ บัดบั กรี และหุ้มหุ้ ข้อข้ ต่อกลางสาย (ใช้ ขนาด 12 มม.)
12 | แผ่นตีนตี ตุ๊กแตุ๊ กแบบมีกามี ว หรือรื เทปกาว สองหน้า | ไม่พบใน Arduitronics | ราว 3 × 3 ซม. ต่อตลับลั | 2 ชิ้นชิ้ | – | – | แปะตลับลั เซ็นเซอร์กัร์ บกั ฝาครอบหูฟัหู ฟัง หาซื้อซื้ ร้าร้ นเครื่อรื่ งเขียขี นได้

## สรุปยอด

กลุ่มลุ่ | ยอด (บาท)
หมวด 1 สายและข้อข้ ต่อ | 1,012
หมวด 2 ชุดชุ ไฟแบต (ถ้าถ้ ซื้อซื้ ครบ 3 ชิ้นชิ้ ) | ราว 55–75
หมวด 3 สายไฟ 2 ม้วม้ น + ท่อหด | 250
หมวด 3 ที่ดที่ ามนิ้วนิ้ | 460–560

กลุ่มลุ่ | ยอด (บาท)
รวมถ้าถ้ ซื้อซื้ ทุกทุ อย่าย่ ง | ราว 1,780–1,900 ไม่รวมค่าส่งและตีนตี ตุ๊กแตุ๊ ก

## เช็กก่อนสั่ง

1. วัดระยะจ วั | ริง:ริ | จากหลังใบ ลั | หูถึหู | งถึ | ปุ่ม C7 ของคนที่จะใ ที่ | ส่ โมเดลได้ 19.4 ซม. และ ด้ | ท่าที่ยืที่ | ดยื | สุดใสุ | ช้สาย 29.8 ซม. สาย ช้ | ข้างละ 40 ซม. ข้ | จึงเ จึ | หลือเ ลื | ผื่อราว 10 ซม. ถ้าระยะจ ถ้ | ริงยาวก ริ | ว่าโมเดลเกิน 8 ซม. ใ กิ | ห้
เพิ่มสาย Qwiic 100 mm ( พิ่ | ข้อ 3) และ Qwiic Adapt ข้ | er (ข้อ 1) ข้ | ข้างละ 1 ข้ | ชุดชุ
2. ความหนากล่อง: หัวหั | จัมเ จั | ปอร์ที่ร์ที่เสียบสี | ตั้งฉากใต้ ESP32 ยาวราว 14 มม. ก ต้ | ล่องที่พิที่ | มพิ | พ์ต้พ์ | องหนาราว 35 มม. ต้ | ถ้าจะใ ถ้ | ห้กห้ | ล่องบาง 22 มม. ให้บัห้ | ดกบั | รีสายไฟ ( รี | ข้อ 10) เ ข้ | ข้าขา ESP32 แทนสาย ข้ | จัมเ จั | ปอร์
3. ระยะรูของ Qwiic Adapter: ร้านไ ร้ | ม่ระบุ คาดว่า 2.54 มม. ลองเทียบที | กับกั | ก้างปลา ก้ | ก่อนบัดกบั | รี
4. สายยี่ห้ยี่ | อห้ | อื่น: สาย JST-SH 1.0 มม. ที่ไม่ใช่ Qwiic / STEMMA QT อาจเรียงขาก รี | ลับลั | ด้าน ด้ | ต้องต้ | วัดวั | ด้วยด้ | มิเตอ มิ | ร์ก่ร์ | ก่อนเสียบสี
5. ยังไยั | ม่ไม่ | ด้ทดสอบ: ด้ | I2C ผ่านสาย 40 ซม. 2 ข้างพข้ | ร้อมร้ | ข้อข้ | ต่อกับบอ กั | ร์ดจร์ | ริง ริ | ถ้าถ้ | อ่านค่าผิดพลาดใ ผิ | ห้ลดความเ ห้ | ร็วร็ | บัสในเ บั | ฟิร์มแว ร์ | ร์
ร้าร้ | นที่อ้ที่ | าอ้ | งอิงอิ

Arduitronics (https://www.arduitronics.com/) ข้อ 1–6, 8, 10, 11 ข้
Cytron ไทย (https://th.cytron.io/) ทางเลือกของ ลื ข้อ 3 ข้ ArduinoAll (https://www.allnewstep.com/) ข้อ 7 ข้
rakmor (https://rakmor.com/) ข้อ 9 ข้
