67160366/C7-earphone-web/wiring.html

# หูฟังของคุณ + อุปกรณ์เสริม C7

หน้า dev · โครงสร้างในกล่อง · แบบร่างข้อเสนอ ยังไม่ได้สร้างจริง · ขนาดเป็นค่าประมาณ

กำลังโหลดโมเดลศีรษะ…

แถบที่ดามนิ้ว (ยาว 45.7 ซม.)

กว้าง–

ใช้จริง–

ปลาย–

ระยะหู → C7 (ค่าจากโมเดล)

เส้นตรง ท่าตรง–

สายเดินจริง ท่าตรง–

ก้มสุด 45°–

เงยสุด 30°–

ยาวสุดทุกท่า–

สายที่ใช้ 20 + 20 = 40 ซม.

ซ้าย ตอนนี้–

ขวา ตอนนี้–

เหลือเผื่อ–

ลากเพื่อหมุน · ล้อเมาส์/สองนิ้วเพื่อซูม · แตะชิ้นส่วนเพื่อดูรายละเอียด

## มุมมอง

สวมใส่ทุกชิ้นอยู่ในที่ แยกชิ้นชิ้นไหนเป็นของเรา ผังต่อสายบอร์ดจริง + ขา

เฉียงหลัง หน้า ข้าง หลัง บน

แสดงตัวคน ป้ายชื่อ มองทะลุเห็นบอร์ดข้างใน

สีเขียวอมฟ้าและสีขาว = อุปกรณ์เสริมของเรา · สีเทาเข้ม = หูฟังของผู้ใช้

## เปิด/ปิดสายในผัง

ดูทั้งผัง ป้ายชื่อขาทุกขา (ปกติแสดงเฉพาะขาที่ต่อสาย)

## ความกว้างแถบที่ดามนิ้ว

½ นิ้ว12.7 มม. ¾ นิ้ว19 มม. 1 นิ้ว25.4 มม.

ที่ดามนิ้วรุ่นนี้ขายเป็นแถบยาว 18 นิ้ว มี 3 ความกว้าง ตัดและดัดเองได้

## ลองขยับศีรษะ

ก้ม/เงย0°

หันซ้าย/ขวา0°

เอียงหู0°

ขยับอัตโนมัติ ท่าตรง

ค่าบวก: ก้ม, หันซ้าย, หูขวาลง (ตาม SENSOR_AXES.md) · หูฟังกับตลับขยับตามศีรษะ ส่วนโครงพาดบ่าอยู่กับลำตัว

## อุปกรณ์ตัวไหนอยู่ตรงไหน

ตำแหน่ง | อุปกรณ์ | จำนวน
ข้างหูซ้าย ด้านนอกฝาครอบหูฟัง | ตลับเซ็นเซอร์ | 1
| BNO085 (0x4A) ในตลับ | 1
ข้างหูขวา ด้านนอกฝาครอบหูฟัง | ตลับเซ็นเซอร์ | 1
| BNO085 (0x4B) ในตลับ + สายสั้น 3Vo → DI | 1
ข้างคอซ้าย จากใต้หูลงมาถึงหลังคอ | สาย Qwiic อ่อน 20 ซม. | 2
| Qwiic Adapter (ข้อต่อกลางสาย) | 1
ข้างคอขวา | สาย Qwiic อ่อน 20 ซม. | 2
| Qwiic Adapter (ข้อต่อกลางสาย) | 1
บ่าทั้งสองข้าง จากใต้ไหปลาร้า อ้อมหลังคอ | แถบที่ดามนิ้วอะลูมิเนียม 45.7 ซม. | 1
หลังคอ ตรงปุ่ม C7 กล่อง C7 หนีบกลางแถบ | กล่อง C7 | 1
| ESP32 DevKit V1 | 1
| GY-521 MPU6050 (0x68) | 1
| Qwiic Adapter (จุดแยก) + ก้านขา 4 ขา | 2
| สาย Qwiic 5 ซม. | 1
| สายจัมเปอร์เมีย-เมีย 8 เส้นสำหรับ I2C + 2 เส้นตัดปลายสำหรับ VIN, GND | 10
| แบต LiPo 503035 | 1
| TP4056 USB-C | 1
| สวิตช์เลื่อน | 1
| MT3608 | 1
บนศีรษะ | หูฟังครอบหูของผู้ใช้ | 1

รวม: BNO085 2, Qwiic Adapter 4, สาย Qwiic 20 ซม. 4, สาย Qwiic 5 ซม. 1 · ติ๊ก "มองทะลุเห็นบอร์ดข้างใน" ในมุมมองสวมใส่เพื่อดูบอร์ดขนาดจริงในตลับและกล่อง

กล่อง C7 ขยายเป็น 96 × 60 × 35 มม. เพื่อให้หัวจัมเปอร์ใต้ ESP32 ใส่ได้จริง ดูว่าแต่ละชิ้นวางและยึดอย่างไร สายเดินทางไหน และภาพแยกชิ้นได้ที่หน้า โครงสร้างในกล่อง

## ขา 3V3 ขาเดียว ไปเซ็นเซอร์ 3 ตัวได้อย่างไร

1. ขา ESP32 แต่ละขาเสียบสายได้เส้นเดียว จึงไม่แยกสายที่ขา ใช้ 4 ขา (3V3, GND, D21, D22) ขาละ 1 เส้น ไปที่แผ่น Qwiic Adapter 1
2. บนแผ่น Qwiic Adapter จุดที่ชื่อเดียวกันต่อถึงกันด้วยลายทองแดง: ช่อง Qwiic 2 ช่อง + รู 4 รู จึงเป็นจุดแยก 1 เข้า 2 ออก
3. Adapter 1: ช่องซ้าย → สายไปหูซ้าย, ช่องขวา → สายสั้นไป Adapter 2
4. Adapter 2: ขา 4 ขา → GY-521, ช่องขวา → สายไปหูขวา
5. สายไปหูแต่ละข้าง: สาย Qwiic 20 ซม. 2 เส้น ต่อกันด้วย Qwiic Adapter อีก 1 แผ่นกลางสาย

หัวต่อมี 2 แบบ · หัว Qwiic (JST-SH ระยะขา 1.0 มม. 4 ขา): ที่ปลายสายเป็นหัวพลาสติกขาวตัวเมีย เสียบเข้าช่องบนบอร์ดซึ่งเป็นขาตัวผู้ มีร่องบังคับ เสียบได้ทางเดียว · หัวจัมเปอร์ (ระยะขา 2.54 มม.): หัวพลาสติกดำตัวเมียรูเดียว เสียบเข้าขาตัวผู้ของ ESP32, GY-521 และก้านขาที่บัดกรีบน Adapter

ต้องบัดกรี 4 จุด: ก้านขาตัวผู้ 4 ขาบน Adapter 1 และ 2, ก้านขาของ GY-521, สายสั้น 3Vo → DI บน BNO085 ขวา ที่เหลือเสียบอย่างเดียว ดูสายทุกเส้นได้ในมุมมอง "ผังต่อสาย" (แตะสายเพื่อดูว่าเป็นสายอะไร)

## ของที่ต้องซื้อ (ร้านในไทย)

- SparkFun Qwiic Adapter × 4 (จุดแยกในกล่อง 2, ข้อต่อกลางสาย 2)Arduitronics AG00305 (https://www.arduitronics.com/product/1997/sparkfun-qwiic-adapter) · 95 บาท/แผ่น · พร้อมส่ง
- Flexible Qwiic Cable 200 mm × 4 (ข้างละ 2 เส้น) ฉนวนซิลิโคนอ่อน หัว JST 1 มม. 4 ขาArduitronics AG30260 (https://www.arduitronics.com/product/6809/flexible-qwiic-cable-200mm-sparkfun-usa-%E0%B8%AA%E0%B8%B2%E0%B8%A2%E0%B8%AD%E0%B9%88%E0%B8%AD%E0%B8%99-%E0%B8%A2%E0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) · 120 บาท/เส้น · พร้อมส่ง
- สาย Qwiic 50 mm × 1 (Adapter 1 → Adapter 2) หัว JST SH 4 ขาตัวเมียทั้งสองปลายCytron ไทย WR-SQ-50MM (https://th.cytron.io/p-stemmaqt-qwiic-jst-sh-4-pin-cable-50mm-long) · 10 บาท · มีของ 18 เส้น · ถ้าจะซื้อร้านเดียว ใช้ Flexible Qwiic 100 mm AG20260 (https://www.arduitronics.com/product/6808/flexible-qwiic-cable-100mm-sparkfun-usa-%E0%B8%AA%E0%B8%B2%E0%B8%A2%E0%B8%AD%E0%B9%88%E0%B8%AD%E0%B8%99-%E0%B8%A2%E0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) 120 บาทแทนได้
- สายจัมเปอร์เมีย-เมีย 8 เส้น (ESP32 → Adapter 1 และ Adapter 2 → GY-521)Cytron ไทย Female to Female Jumper Wire (https://th.cytron.io/c-jumper-wire) · 18 บาท · หน้าร้านไม่บอกความยาวและจำนวนเส้น ต้องเช็กก่อนสั่ง
- ก้านขาตัวผู้ 2.54 มม. 4 ขา × 2 (บัดกรีบน Adapter 1 และ 2) ซื้อก้างปลาขาตรง 1×40 ขา 1 เส้น แล้วหักออกมา 4 ขา 2 ชิ้น (ที่เหลือใช้กับ GY-521 ได้)Arduitronics SKU-00487 (https://www.arduitronics.com/product/487/%E0%B8%81%E0%B9%89%E0%B8%B2%E0%B8%87%E0%B8%9B%E0%B8%A5%E0%B8%B2-40p-2-54mm-pin-header-dip-straight-single-row-1-x-40-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) · 5 บาท/เส้น · พร้อมส่ง · ขายาว 11 มม. · หรือ Cytron ไทย CN-PH-M140S (https://th.cytron.io/p-straight-pin-header-male-1x40-ways) 10 บาท มีของ 48 เส้น

รวมทั้งหมด 893 บาท ไม่รวมค่าส่ง

รายการสั่งซื้อฉบับเต็ม (ซื้อร้านเดียว, ชุดไฟแบต, ของประกอบ, จำนวนและขนาดทุกชิ้น): docs/SHOPPING_LIST.pdf

ราคาและสต็อกดูจากหน้าร้านเมื่อ 13 พ.ย. 2026 อาจเปลี่ยนได้ · ไม่พบสาย Qwiic 50 ซม. และตัวแยก Qwiic หลายช่องในร้านไทยที่ค้น จึงใช้สาย 20 ซม. 2 เส้นต่อกันแทน · สาย JST-SH 1.0 มม. ยี่ห้ออื่น (เช่นสาย "reverse") อาจเรียงขากลับด้าน ต้องวัดด้วยมิเตอร์ก่อนเสียบ

Adafruit ระบุว่าสาย 300 มม. ถือว่ายาวสำหรับ I2C ยังไม่ได้ทดสอบสาย 40 ซม. 2 ข้างกับบอร์ดจริง ถ้าอ่านค่าผิดพลาดให้ลดความเร็วบัสในเฟิร์มแวร์

## วิธีต่อแบต

1. แบต LiPo 3.7 V: สายแดง → B+, สายดำ → B- ของ TP4056
2. TP4056 OUT+ → สวิตช์เลื่อน → VIN+ ของ MT3608
3. TP4056 OUT- → VIN- ของ MT3608
4. ยังไม่ต่อ ESP32: เปิดสวิตช์ หมุนตัวปรับของ MT3608 จนวัด VOUT ได้ 5.0 V
5. MT3608 VOUT+ → ขา VIN, VOUT- → ขา GND ของ ESP32
6. ชาร์จแบตผ่านช่อง USB-C ของ TP4056

ห้ามต่อแบตเข้าขา 3V3 หรือ VIN โดยตรง และปิดสวิตช์แบตก่อนเสียบ USB เข้า ESP32

เฟิร์มแวร์ตอนนี้ส่งข้อมูลผ่านสาย USB เท่านั้น แบตจึงจ่ายไฟได้ แต่หน้าเว็บยังรับค่าไม่ได้ถ้าไม่เสียบ USB

## ตารางต่อสาย

จัดกลุ่มตามสายจริงแต่ละเส้น · ความยาวสายในผังไม่ตรงมาตราส่วน · ตำแหน่งขาในผังตรงกับบอร์ดจริงในรูปที่ใช้อ้างอิง ถ้าบอร์ดที่ซื้อเป็นรุ่นอื่นให้ดูชื่อขาบนบอร์ด

## ชิ้นส่วนในแบบร่างนี้

ชิ้นส่วน | ของใคร | ขนาด
หูฟังครอบหู | ผู้ใช้ | ฝาครอบ ~100×84 มม.
ตลับเซ็นเซอร์ข้างหู × 2 | ของเรา | 39×28.5×9 มม.
แถบที่ดามนิ้วอะลูมิเนียม × 1 | ของเรา | 457 มม. × ½–1 นิ้ว
Adafruit BNO085 (#4754) × 2 | ของเรา | 25.6×22.7 มม.
ESP32 DevKit V1 30 ขา | ของเรา | ~51.5×28.2 มม.
GY-521 MPU6050 | ของเรา | 21×16 มม.
LiPo 503035 500 mAh | ของเรา | 35×30×5 มม.
TP4056 USB-C + MT3608 + สวิตช์ | ของเรา | 28×17 / 36×17 มม.
SparkFun Qwiic Adapter × 4 | ของเรา | ~25×13 มม.
กล่อง C7 | ของเรา | 96×60×35 มม.

บอร์ดในมุมมอง "ผังต่อสาย" มีขนาดจริง ส่วนตลับ กล่อง และแถบเป็นขนาดที่เสนอ

หัวสแกน: “Infinite, 3D Head Scan” โดย Lee Perry-Smith, CC BY 3.0 (https://creativecommons.org/licenses/by/3.0/), อ้างอิงจาก triplegangers.com ไฟล์จากตัวอย่างของ three.js (ดู assets/vendor/README.md) ส่วนหูฟังและอุปกรณ์เสริมสร้างจากโค้ด
