67160366/C7-earphone-web/docs/WORKLOG.md

# Work log

บันทึกทุกรอบการทำงาน รายการใหม่สุดอยู่บน ทุกรายการมีหัวข้อเหล่านี้:

```
## YYYY-MM-DD หัวข้อสั้น ๆ
- งานที่ทำ:
- ไฟล์ที่แตะ:
- ตรวจแล้ว: (คำสั่งที่รัน + ผล เช่น "check-web 17/17 ผ่าน")
- ยังไม่ได้ยืนยัน:
- งานต่อไป:
```

---

## 2026-11-13 commit และ push งานรอบ 2026-11-13 (ca82c52)
- งานที่ทำ (ผู้ใช้สั่ง push งานใหม่ขึ้น repo): commit งานที่ค้าง 3 รอบของวันนี้ (หน้า structure, รายการสั่งซื้อ, หน้า wiring) เป็น `ca82c52` แล้ว push ไป `web/feature/user-web` (`f535726..ca82c52`); แก้ HANDOFF ให้ตรง
- ไฟล์ที่แตะ: `HANDOFF.md`, `docs/WORKLOG.md` (ไม่ได้แก้โค้ด)
- ตรวจแล้ว: `node scripts/check-web.mjs` 37/37 ผ่าน, `node --check` ไฟล์ JS ที่แก้ 6 ไฟล์ผ่าน, `git diff --check` ผ่าน, `git status` ไม่มีไฟล์ที่ไม่ควรเข้า, ผู้เขียน commit = `67160366`
- ยังไม่ได้ยืนยัน: รอบนี้ไม่ได้เปิดเบราว์เซอร์ตรวจซ้ำ; รายการที่ยังไม่ได้ยืนยันของ 3 รอบด้านล่างยังเหมือนเดิม; ยังไม่ได้ทดสอบกับหูฟังจริง; ไม่ได้ push ไป `origin` (upstream) และไม่ได้ merge เข้า `main`
- งานต่อไป: เหมือนรายการ structure ด้านล่าง (ตัดสินใจหัวจัมเปอร์/บัดกรี, วัดบอร์ดจริง, STL, อัปเดตรายการสั่งซื้อ)

---

## 2026-11-13 หน้า structure: โครงสร้างในกล่อง C7 ตลับข้างหู และกล่องข้อต่อ
- งานที่ทำ (ผู้ใช้ถามว่าการต่อแบบนี้เรื่อง address และการส่งข้อมูลมีปัญหาหรือไม่ และขอหน้าใหม่แสดงโครงสร้างจริงในกล่อง: แต่ละตัววางและยึดอย่างไร สายไปไหน แยกชิ้นได้ เผื่อที่ให้โครงสร้างและสาย):
  - ตรวจ address จากเฟิร์มแวร์: 0x4A / 0x4B / 0x68 บนบัส D21/D22 เดียว ไม่ชนกัน Qwiic Adapter ไม่มีที่อยู่ จุดเสี่ยงคือ 400 kHz ในโหมดเก็บข้อมูลกับสาย 40 ซม. (สรุปไว้ในการ์ดบนหน้า structure)
  - `assets/structure-layout.js` (ใหม่): ขนาดกล่อง ตำแหน่งบอร์ด ที่ยึด ร่องถาด ช่องผนัง และสายในกล่อง หน่วย มม. ไม่แตะ DOM
  - `assets/structure.js` + `structure.html` (ใหม่): โมเดล 3 มิติ 5 กล่อง (C7, ข้อต่อซ้าย/ขวา, ตลับซ้าย/ขวา) ประกอบแล้ว/แยกชิ้นทีละชั้น, มองทะลุผนัง, ถอดฝา, แสดงสาย, แตะชิ้นหรือแถวตารางเพื่อดูตำแหน่ง ที่ยึด และจุดต่อ, ตารางสาย, ตารางความสูงสะสม, รายการสกรู
  - กล่อง C7 ขยายจาก 76×50×22 เป็น 96×60×35 มม. (หัวจัมเปอร์ใต้ ESP32 ต้องการ 19.5 มม.) แบ่ง 2 ชั้นด้วยถาดบอร์ด
  - หน้า wiring: `DIM.box` / `DIM.pod` เป็นขนาดใหม่, `fillBox()` อ่านตำแหน่งจาก `structure-layout.js`, ร่องสายย้ายไปมุมบน, ข้อความขนาดและลิงก์ไปหน้า structure; `dev.html` เพิ่มลิงก์
  - `scripts/check-web.mjs` เพิ่ม 3 ข้อ
- ไฟล์ที่แตะ: `structure.html` (ใหม่), `assets/structure.js` (ใหม่), `assets/structure-layout.js` (ใหม่), `assets/wiring.js`, `assets/wiring-models.js`, `wiring.html`, `dev.html`, `scripts/check-web.mjs`, `README.md`, `AGENTS.md`, `HANDOFF.md`, `docs/WORKLOG.md`
- ตรวจแล้ว:
  - `node scripts/check-web.mjs` 37/37 ผ่าน, `node --check` ไฟล์ที่แก้ผ่าน, `git diff --check` ผ่าน
  - เบราว์เซอร์ `structure.html`: กล่อง C7 มุมเฉียง/ด้านฝา/ข้าง, แยกชิ้น 0–100%, ตลับหูขวา (เห็นสาย 3Vo → DI), กล่องข้อต่อ, เลือกแถว Adapter 1 และสายจัมเปอร์แล้วการ์ดขึ้นข้อมูล, 375 px ธีมสว่าง scrollWidth 375, 1400 px ธีมมืด, console ไม่มี error
  - เบราว์เซอร์ `wiring.html` หลังแก้: โหลดได้ console ไม่มี error ระยะสายใหม่ ท่าตรง 17.2 / ก้ม 45° 19.1 / เงย 30° 16.1 / ยาวสุด 30.0 ซม. เหลือเผื่อ 10.0 ซม.
- ยังไม่ได้ยืนยัน:
  - ยังไม่ได้พิมพ์หรือประกอบจริง เทสต์ตรวจการชนด้วยกล่องสี่เหลี่ยมของบอร์ด เสา ครีบ และหัวจัมเปอร์เท่านั้น ไม่ได้ตรวจตะขอ บ่ารับ สกรู และทางเดินสายว่าชนอะไรหรือไม่
  - ตำแหน่งรูยึดของ ESP32 / GY-521 / BNO085 ขนาด Qwiic Adapter และตำแหน่งชิ้นส่วนบน TP4056 / MT3608 เป็นค่าประมาณ
  - ไม่ได้ตรวจ: ภาพรวม, ตลับหูซ้าย, มุมบนและด้านชิดตัว, การแตะชิ้นส่วนในโมเดลด้วยเมาส์ (ตรวจผ่านการกดแถวตาราง), ธีมสว่างที่จอกว้าง, หน้า wiring มุมมองแยกชิ้นและผังต่อสายหลังแก้
  - ยังไม่ได้ทดสอบ I2C กับสายและหัวต่อตามแบบ; คำเตือนของ Adafruit เรื่อง BNO08x กับ ESP32 เขียนจากความจำ ไม่ได้เปิดหน้าเว็บตรวจ
  - `docs/SHOPPING_LIST.md` / PDF ยังไม่มีสกรูและตัวยึด และยังเขียนขนาดกล่องเดิม
- งานต่อไป: ผู้ใช้ตัดสินใจว่าจะใช้หัวจัมเปอร์ (กล่อง 35 มม.) หรือบัดกรีสาย (บางลงราว 12 มม.); วัดบอร์ดจริงแล้วแก้ `structure-layout.js`; ทำไฟล์ STL; อัปเดตรายการสั่งซื้อ; ยังไม่ commit

---

## 2026-11-13 รายการสั่งซื้อ (docs/SHOPPING_LIST.md + PDF)
- งานที่ทำ (ผู้ใช้ขอรายละเอียดการสั่งซื้อ ระบุแหล่งซื้อ รุ่น ขนาด ความยาว จำนวน เป็นไฟล์ที่กดลิงก์ได้; ผู้ใช้มีเซ็นเซอร์ ESP32 แบตแล้ว กล่องพิมพ์ 3 มิติ):
  - ค้นร้านไทยเพิ่ม: TP4056 Type-C, MT3608, สวิตช์เลื่อน, สายจัมเปอร์เมีย-เมีย 10 ซม., สายไฟ 26AWG, ท่อหด, ที่ดามนิ้ว
  - เขียน `docs/SHOPPING_LIST.md` (12 รายการ 3 หมวด + ของที่มีแล้ว + สรุปยอด + ข้อที่ต้องเช็กก่อนสั่ง) และสร้าง `docs/SHOPPING_LIST.pdf` (A4 แนวนอน 3 หน้า)
  - `wiring.html` เพิ่มลิงก์ไป PDF, `docs/README.md` เพิ่มแถวในสารบัญ
- ไฟล์ที่แตะ: `docs/SHOPPING_LIST.md` (ใหม่), `docs/SHOPPING_LIST.pdf` (ใหม่), `docs/README.md`, `wiring.html`, `HANDOFF.md`, `docs/WORKLOG.md`
- ตรวจแล้ว: เปิด PDF ดูครบ 3 หน้า ตารางและภาษาไทยแสดงถูก มีลิงก์ในไฟล์ (นับ /URI ได้ 44 จุด); `git diff --check` ผ่าน; ไม่ได้แก้ JS
- ยังไม่ได้ยืนยัน:
  - ไม่ได้กดลิงก์ใน PDF ทีละลิงก์; ลิงก์สายไฟ 26AWG ชี้ไปหน้าค้นหาของร้าน
  - MT3608: หน้า Arduitronics เปิดไม่ได้ ราคา 20–40 บาทมาจากผลค้นหา ไม่ได้เปิดหน้าร้าน ArduinoAll; ที่ดามนิ้ว rakmor ราคา 460–560 บาทเป็นข้อมูลเก่าราว 5 เดือน
  - สายจัมเปอร์และสายไฟ 26AWG เห็นแค่ปุ่มสั่งซื้อในหน้าค้นหา ไม่ได้เปิดหน้าสินค้าดูสถานะ
  - ยอดในการ์ด "ของที่ต้องซื้อ" ของ `wiring.html` (893 บาท ใช้ของ Cytron บางชิ้น) ไม่ตรงกับยอดซื้อร้านเดียวในเอกสาร (1,012 บาท) ตั้งใจให้เป็นคนละทางเลือก
- งานต่อไป: ผู้ใช้ตรวจรายการแล้วสั่งซื้อ; ตัดสินใจความหนากล่องก่อนพิมพ์; ยังไม่ commit

---

## 2026-11-13 หน้า wiring: บอร์ดจริงในมุมมองสวมใส่ ระยะสายหู → C7 ตารางตำแหน่งอุปกรณ์
- งานที่ทำ (ผู้ใช้ขอรายละเอียดว่าอุปกรณ์ตัวไหนอยู่ตรงไหน กี่ตัว และแบบจำลองที่คิดความยาวสายจริงรวมเผื่อก้ม-เงย ใส่ในหน้าสวมใส่):
  - `assets/wiring.js`: บอร์ดขนาดจริงในตลับ (BNO085) และในกล่อง C7 2 ชั้น (`BOX_PARTS`, `fillBox()`), สวิตช์ "มองทะลุเห็นบอร์ดข้างใน" (`applyXray()`), วัดความยาวสายอัตโนมัติ 75 ท่า (`measureRange()`)
  - `assets/wiring-boards.js`: ตัวเลือก `bare` (ไม่มีก้านขา) สำหรับบอร์ดที่อยู่ในตลับ/กล่อง
  - `wiring.html`: กล่องตัวเลข "ระยะหู → C7" (เส้นตรง, สายเดินจริง, ก้มสุด, เงยสุด, ยาวสุดทุกท่า), การ์ด "อุปกรณ์ตัวไหนอยู่ตรงไหน" (ตำแหน่ง + จำนวนทุกชิ้น)
- ไฟล์ที่แตะ: `assets/wiring.js`, `assets/wiring-boards.js`, `assets/wiring-models.js` (คอมเมนต์), `wiring.html`, `HANDOFF.md`, `docs/WORKLOG.md`
- ตรวจแล้ว:
  - `node --check` 3 ไฟล์ผ่าน, `check-web` 34/34 ผ่าน, `git diff --check` ผ่าน
  - เบราว์เซอร์: ค่าจากโมเดล เส้นตรง 19.4 / ท่าตรง 18.0 / ก้ม 45° 19.6 / เงย 30° 17.2 / ยาวสุด 29.8 ซม. (ก้ม 45° หัน 70° เอียง -30°) เหลือเผื่อ 10.2 ซม.; มุมหลังและมุมข้างเห็นบอร์ดในกล่องและตลับ; ตารางตำแหน่ง 21 แถว; 375 px ธีมสว่าง scrollWidth 375; 1400 px ธีมมืด; console ไม่มี error
- ยังไม่ได้ยืนยัน:
  - ระยะทั้งหมดมาจากหัวสแกนที่ปรับขนาดเอง (ศีรษะกว้าง 16 ซม.) และเส้นทางสายที่สมมติ ยังไม่ได้วัดจากผู้สวมจริง
  - ภาพบอร์ดข้างในดูจากภาพขนาดเล็ก ไม่ได้ซูมตรวจการชนผนัง; ไม่ได้ตรวจมุมมองแยกชิ้น; ที่ 375 px กล่องตัวเลขบังโมเดลเกือบครึ่ง
  - กล่องหนา 22 มม. ไม่พอสำหรับหัวจัมเปอร์ใต้ ESP32 (ยังไม่ได้แก้ขนาดกล่อง)
- งานต่อไป: ผู้ใช้วัดระยะหู → C7 จริงแล้วเทียบ; ตัดสินใจเรื่องความหนากล่องหรือวิธีต่อสายเข้า ESP32; ยังไม่ commit

---

## 2026-11-13 หน้า wiring: ใส่รุ่นก้านขาตัวผู้ 2.54 มม.
- งานที่ทำ: ค้นก้านขาตัวผู้ (ก้างปลา) ขาตรง 1×40 ในร้านไทย แล้วใส่ร้าน รหัส ราคา ลงการ์ด "ของที่ต้องซื้อ" (Arduitronics SKU-00487 5 บาท, Cytron ไทย CN-PH-M140S 10 บาท) ยอดรวมเป็น 893 บาท; ตอบผู้ใช้เรื่องหัว XH2.54 4 ขาจาก Shopee (เปิดหน้าไม่ได้ ตอบจากชื่อสินค้า)
- ไฟล์ที่แตะ: `wiring.html`, `HANDOFF.md`, `docs/WORKLOG.md`
- ตรวจแล้ว: `git diff --check` ผ่าน; ไม่ได้แก้ JS จึงไม่ได้รัน check-web ซ้ำ; ไม่ได้เปิดหน้าในเบราว์เซอร์หลังแก้ข้อความ
- ยังไม่ได้ยืนยัน: ระยะรูของ Qwiic Adapter (คาดว่า 2.54 มม. หน้าร้านไม่ระบุ); ราคาและสต็อกดูเมื่อ 2026-11-13
- งานต่อไป: เหมือนรายการด้านล่าง; ยังไม่ commit

---

## 2026-11-13 หน้า wiring: ต่อสายตามของจริงที่ซื้อได้ในไทย + เอามอเตอร์สั่นออก
- งานที่ทำ (ผู้ใช้ถามว่าขา 3V3 ขาเดียวจะไปหลายเซ็นเซอร์อย่างไร ใช้สายอะไร ซื้อที่ไหนในไทย และสั่งเอาโมดูลมอเตอร์สั่นออก):
  - ค้นร้านในไทย (Arduitronics, Cytron ไทย) แล้วเลือกของที่มีขาย: SparkFun Qwiic Adapter เป็นจุดแยก, Flexible Qwiic Cable 200 mm, สาย Qwiic 50 mm, สายจัมเปอร์เมีย-เมีย
  - `assets/wiring.js`: เปลี่ยนรายการสายเป็น `CABLES` (สายจริง 9 ชุด 36 เส้น) ขา ESP32 ขาละ 1 สาย; สายออกจากช่อง Qwiic ทางด้านข้าง และออกจากหัวจัมเปอร์ใต้ก้านขา (`wireEnd()`); เพิ่มหัวต่อบนปลายสาย (`buildPlugs()`), โซน "กลางสาย", ตารางจัดกลุ่มตามสาย, การ์ดข้อมูลของสายแต่ละชุด; มุมมองสวมใส่เทียบกับสาย 20 + 20 ซม. และมีข้อต่อกลางสาย; ลบมอเตอร์สั่นและกลุ่มสายมอเตอร์
  - `assets/wiring-boards.js`: ลบ `motorModule` เพิ่ม `qwiicAdapter`
  - `wiring.html`: การ์ด "ขา 3V3 ขาเดียว ไปเซ็นเซอร์ 3 ตัวได้อย่างไร", การ์ด "ของที่ต้องซื้อ (ร้านในไทย)" พร้อมรหัสสินค้า ราคา วันที่ดู, ลบมอเตอร์จากรายการชิ้นส่วน
- ไฟล์ที่แตะ: `assets/wiring.js`, `assets/wiring-boards.js`, `wiring.html`, `README.md`, `AGENTS.md`, `HANDOFF.md`, `docs/WORKLOG.md`
- ตรวจแล้ว:
  - `node --check assets/wiring.js` และ `assets/wiring-boards.js` ผ่าน, `check-web` 34/34 ผ่าน, `git diff --check` ผ่าน
  - เบราว์เซอร์ (serve.ps1): ผังต่อสายขึ้นครบ, แตะสายซ้ายแล้วการ์ดขึ้น "สาย Adapter 1 → ข้อต่อซ้าย", ตาราง 46 แถว, มุมมองสวมใส่ก้ม 40° หัน 60° สายยาวสุด 25.6 ซม. เหลือ 14.4 ซม., 375 px ธีมสว่าง scrollWidth 375, ธีมมืด, console ไม่มี error
- ยังไม่ได้ยืนยัน:
  - ไม่ได้ซื้อของและไม่ได้ต่อวงจรจริง; I2C ผ่านสาย 40 ซม. + ข้อต่อยังไม่ได้ทดสอบ
  - ขนาดและลำดับรูของ Qwiic Adapter เป็นค่าประมาณ; ก้านขาตัวผู้ยังไม่ได้หาร้าน; สายจัมเปอร์ Cytron ไม่รู้ความยาว; ราคาและสต็อกดูเมื่อ 2026-11-13
  - ไม่พบสาย Qwiic 500 mm และตัวแยกหลายช่องในร้านไทยที่ค้น; หน้า ModuleMore เปิดไม่ได้; BNO085 ที่ Arduitronics สินค้าหมด
  - ไม่ได้ตรวจมุมมองแยกชิ้น และไม่ได้ไล่ท่าศีรษะสุดช่วงทุกแกนในรอบนี้
  - เฟิร์มแวร์ยังมี `HAPTIC_MOTOR_PIN` (ไม่ได้แก้เฟิร์มแวร์)
- งานต่อไป: ผู้ใช้ตรวจผังและรายการซื้อ; ถ้าจะสั่งของให้เช็กสต็อกอีกครั้ง; ตัดสินใจว่าจะลบโค้ดมอเตอร์ในเฟิร์มแวร์หรือไม่; ยังไม่ commit

---

## 2026-11-11 หน้า wiring รอบที่ 2: บอร์ดจริง ผังต่อสาย วงจรแบต สายตลับ→กล่อง
- งานที่ทำ (ผู้ใช้ส่งรูปบอร์ดจริง 3 รูป: Adafruit BNO085, ESP32 DevKit V1 30 ขา, GY-521):
  - เพิ่ม `assets/wiring-boards.js`: บอร์ดขนาดจริง 8 ชนิด (BNO085, ESP32 DevKit V1, GY-521, TP4056, MT3608, LiPo, สวิตช์, โมดูลมอเตอร์) silkscreen วาดด้วย canvas ตามชื่อขาบนบอร์ด, ชิ้นส่วน 3 มิติ, ขา header + ตะกั่ว
  - `assets/wiring.js`: มุมมองที่ 3 "ผังต่อสาย" (โซนตลับซ้าย/ขวา/กล่อง C7, สาย 23 เส้นสีตามชนิด, ป้ายชื่อขา, เปิด/ปิดกลุ่มสาย, แตะบอร์ดเพื่อซูม, ปุ่มดูทั้งผัง), ตารางต่อสาย, สายตลับ→กล่อง 2 เส้นบนตัวคนที่ขยับตามศีรษะพร้อมความยาว
  - `assets/wiring-models.js`: กล่อง C7 ขยายเป็น 76×50×22 มม., จุดสายเข้า 2 จุดบนกล่อง, จุดสายออกของตลับ
  - `wiring.html`: การ์ดสายที่ต้องซื้อ (SparkFun PRT-17257, Adafruit #5384), วิธีต่อแบต 6 ขั้น, ตารางต่อสาย, รายการชิ้นส่วน
  - ตัดสินใจ: ต่อแบบดาว (สาย Qwiic ข้างละเส้นลงกล่อง) บัสเดียว D21/D22 ตรงกับเฟิร์มแวร์; ไฟ LiPo → TP4056 → สวิตช์ → MT3608 5 V → VIN; ใช้โมดูลมอเตอร์สำเร็จแทนวงจร NPN
- ไฟล์ที่แตะ: `assets/wiring-boards.js` (ใหม่), `assets/wiring.js`, `assets/wiring-models.js`, `wiring.html`, `README.md`, `AGENTS.md`, `HANDOFF.md`, `docs/WORKLOG.md`
- ตรวจแล้ว:
  - `node --check` ทั้ง 3 ไฟล์ผ่าน, `check-web` 34/34 ผ่าน, `git diff --check` ผ่าน
  - เบราว์เซอร์: 3 มุมมอง, ซูมบอร์ด ESP32 / BNO085 ขวา / GY-521 เห็นชื่อขาและสายลงขาถูกตัว, ตาราง 23 เส้น, ท่าศีรษะสุดช่วงสายยาวสุด 28.8 ซม., 375 px ธีมสว่างไม่ล้นแนวนอน, ธีมมืด 1500 px, console ไม่มี error
- ยังไม่ได้ยืนยัน:
  - ไม่ได้ต่อวงจรจริง ไม่ได้ทดสอบ I2C ผ่านสาย 50 ซม. กับบอร์ดจริง
  - ไม่ได้ซูมตรวจ TP4056, MT3608, LiPo, สวิตช์, โมดูลมอเตอร์ทีละชิ้น; ตำแหน่งขาของ 3 โมดูลนี้ไม่ได้เทียบกับของจริงของผู้ใช้
  - ขนาด ESP32 DevKit V1 เป็นค่าประมาณ; เลขสินค้าสายมาจากการค้นเว็บ ไม่ได้เช็กสต็อก; ยืนยันรุ่นตัวแยก Qwiic ไม่ได้จึงไม่ได้ใส่
- งานต่อไป: ผู้ใช้ตรวจผังเทียบกับของจริง แล้วเลือกว่าจะทำบอร์ดในตลับ/กล่องบนตัวคน (มองทะลุ) หรือปรับผัง; ยังไม่ commit

---

## 2026-11-11 รื้อหน้า wiring เป็นหูฟังของผู้ใช้ + อุปกรณ์เสริม (รอบที่ 1: โมเดล)
- งานที่ทำ (ตามที่ผู้ใช้ขอ: ทำทีละอุปกรณ์ รอบนี้เฉพาะโมเดลหูฟังและอุปกรณ์เสริม อย่างอื่นลบได้):
  - ติดตั้ง skill `threejs-procedural-geometry` (MIT) ลง `.claude/skills/` ด้วย git clone แบบ sparse แล้วคัดลอกเฉพาะโฟลเดอร์ skill; ใช้เป็นแนวทาง (loft/sweep, ขอบมน, ตรวจมุมมองคงที่) ไม่ได้คัดลอก kit เข้า `assets/`
  - เพิ่ม `assets/wiring-models.js`: `loftRings`, `sweepStrip` (กำหนด frame จาก normal ของผิว ไม่บิด), `buildHeadphone` (ไม่มีอิเล็กทรอนิกส์ข้างใน ฝาครอบเป็น loft ชิ้นเดียว), `buildEarPod`, `buildC7Brace` (ฉายเส้นทางลงผิวหัวสแกน ตัดกึ่งกลางที่แนวกลางลำตัว ใช้แถบเต็ม 45.7 ซม.)
  - เขียน `assets/wiring.js` ใหม่ (690 → ราว 300 บรรทัด): ลบ bench ผังต่อขา สาย โหมดมองทะลุ; เพิ่มมุมมองแยกชิ้น, มุมกล้อง 5 มุม, เลือกความกว้างแถบ, ซ่อนตัวคน, render เฉพาะเมื่อมีการเปลี่ยนแปลง, guard ขนาดศูนย์, reduced-motion ตรวจทุกเฟรม
  - เขียน `wiring.html` ใหม่: ลบการ์ดบัส/สาย/ตารางขา/BOM เดิม, เพิ่มป้ายว่าเป็นแบบร่างข้อเสนอ
  - ผลจากการวัดหัวสแกน: มีบ่าและอกช่วงบนอยู่แล้ว (กว้าง ±18.8 ซม. ลงถึง y ≈ -17.5 ซม.) จึงไม่ต้องสร้างลำตัวเพิ่มตามแผนเดิม
- ไฟล์ที่แตะ: `wiring.html`, `assets/wiring.js`, `assets/wiring-models.js` (ใหม่), `dev.html` (ข้อความลิงก์), `README.md`, `AGENTS.md`, `HANDOFF.md`, `docs/WORKLOG.md`, `.claude/skills/threejs-procedural-geometry/` (ใหม่ untracked)
- ตรวจแล้ว:
  - `node --check assets/wiring.js` และ `assets/wiring-models.js` ผ่าน, `check-web` 34/34 ผ่าน, `git diff --check` ผ่าน
  - เปิด `wiring.html` ผ่าน serve.ps1 ในเบราว์เซอร์: มุมเฉียงหลัง/หน้า/ข้าง/หลัง/บน, ซูมใกล้กล่อง C7 และตลับ, แยกชิ้น, แถบ ½ / ¾ / 1 นิ้ว, ซ่อนตัวคน, ท่าก้ม 45° หัน -70° เอียง 30°, กว้าง 375 px ธีมสว่าง (ไม่ล้นแนวนอน), ธีมมืด, แตะป้ายแล้วการ์ดข้อมูลเปลี่ยน, console ไม่มี error
- ยังไม่ได้ยืนยัน:
  - ยังไม่ได้สร้างของจริง ขนาดตลับ กล่อง ความหนาแถบ และฟองน้ำรองเป็นค่าสมมติ (หน้าร้านไม่ระบุ)
  - ที่ท่าก้ม+หัน+เอียงสุดพร้อมกัน ฝาครอบหูเข้าใกล้แถบบนบ่ามาก ดูด้วยตาเท่านั้น ยังไม่ได้วัดระยะ
  - ไม่ได้รันตัวตรวจ topology ของ skill (ตรวจด้วยการดูมุมคงที่เท่านั้น)
- งานต่อไป: เพิ่มกลับทีละอุปกรณ์ตามที่ผู้ใช้เลือก (บอร์ดในตลับ/กล่อง → สายจากหูลง C7 → ผังต่อขา); ยังไม่ commit

---

## 2026-11-11 เพิ่มหน้าแบบจัดสายหูฟังครอบหู 3 มิติ (wiring.html)
- งานที่ทำ (ตามที่ผู้ใช้ขอ ย้ายจากโฟลเดอร์ HeadSet มาไว้ที่นี่):
  - หน้า `wiring.html` + `assets/wiring.js`: หัวสแกนสวมหูฟังครอบหู, BNO085 ในครอบหูทั้ง 2 ข้าง, ESP32 ในครอบหูซ้าย, ชุดไฟในครอบหูขวา, สาย 5 คอร์ในก้านคาดหัวและสาย 5 คอร์ลงกล่อง C7
  - 3 มุมมอง: แบบปกติ / มองทะลุ / ผังต่อขา (บอร์ดขนาดจริง ชื่อขาครบ เปิด/ปิดสายทีละกลุ่ม สลับบัสเดียว/แยกบัส), ตารางต่อขา 24 เส้น, ความยาวสายลง C7 ตามท่าศีรษะ
  - ปรับให้ใช้ Three.js และฟอนต์ในเครื่อง (ไม่ใช้ CDN), กล้องถอยอัตโนมัติให้เห็นครบที่จอแคบ
  - เพิ่ม `assets/models/head/Map-COL.jpg` และบันทึกที่มาใน `assets/vendor/README.md`, ลิงก์จาก `dev.html`
- ไฟล์ที่แตะ: `wiring.html`, `assets/wiring.js`, `assets/models/head/Map-COL.jpg`, `assets/vendor/README.md`, `dev.html`, `README.md`, `AGENTS.md`, `HANDOFF.md`, `docs/WORKLOG.md`
- ตรวจแล้ว:
  - `check-web` 31/31 ผ่าน, `node --check assets/wiring.js` ผ่าน, `git diff --check` ผ่าน
  - เปิด `wiring.html` ผ่าน serve.ps1: 1400 px ธีมมืด, 375 px ธีมสว่าง (ไม่ล้นแนวนอน), ทั้ง 3 มุมมอง, console ไม่มี error
- ยังไม่ได้ยืนยัน: ยังไม่ได้ประกอบหูฟังหรือต่อวงจรจริงตามผัง, ขนาดหูฟังและความยาวสายมาจากหัวสแกนที่ปรับขนาดเอง, ผลของแม่เหล็กลำโพงต่อ BNO085
- งานต่อไป: ถ้าจะสร้างจริง ตัดสินใจเรื่อง Game Rotation Vector และวัดความยาวสายจากผู้สวมจริง
- commit: `2ee0de2` push ขึ้น `web/feature/user-web` แล้ว

---

## 2026-11-10 ตรวจทานเฟิร์มแวร์และโค้ดระบบ ว่าทำงานและคำนวณถูกหรือไม่
- งานที่ทำ:
  - ผู้ใช้ขอให้อ่านเฟิร์มแวร์และโค้ดระบบ แล้วตรวจว่าทำงานและคำนวณถูกหรือไม่ (ตรวจอย่างเดียว ไม่ได้แก้โค้ด ไม่ได้ flash ไม่ได้ต่อบอร์ด)
  - อ่าน `esp32_c7_prototype.ino` ทั้งไฟล์, `assets/c7-core.js`, `assets/c7-collect.js`, `assets/user.js`, `api/save_angle.php`, `api/get_latest.php` และส่วนคำนวณของ `assets/collect.js`
  - เขียนสคริปต์ตรวจข้ามแยกต่างหาก (ไว้นอก repo ไม่ได้ commit) อ่านค่าคงที่จากไฟล์จริงแล้วเทียบ เฟิร์มแวร์ (จำลอง float32) / JS / PHP / เรขาคณิตที่เขียนใหม่
- ไฟล์ที่แตะ: `HANDOFF.md`, `docs/WORKLOG.md`
- ตรวจแล้ว:
  - `node scripts/check-web.mjs` 34/34 ผ่าน, `node --check assets/*.js` ผ่านทุกไฟล์, `git diff --check` ผ่าน
  - compile ESP32 Dev Module + core 3.3.12 ผ่าน (941868 B / 71%, RAM 48700 B / 14%) ไม่ได้ flash
  - สคริปต์ตรวจข้าม 17/17 ผ่าน:
    - ค่าคงที่สูตร, `geometry_id`, baud 460800, `COLLECT_FORMAT` 2 และช่วง clamp ตรงกันทุกที่
    - CVA เทียบเรขาคณิตที่เขียนใหม่ 898 จุด ต่าง 0, ท่าตั้งศูนย์ 52.05°, tilt +10 / pitch −10 ได้ 45.03°, ความชัน −0.851°/° ต่อ `mpu_tilt`, ก้ม 20° ลด 3.13°
    - เฟิร์มแวร์ float32 ต่างจาก JS ไม่เกิน 9.5e-6°, JSON 2 ตำแหน่งผ่าน `validatePacket` 898/898 (ต่างสูงสุด 0.005°)
    - PHP `cva_geometry1()` ต่างจาก JS ไม่เกิน 4.3e-14°
    - Euler ของหน้าเว็บตรงกับเฟิร์มแวร์ (2000 quaternion สุ่ม), บรรทัด `D` 35 ช่องถอดหน่วยถูก, เอกลักษณ์ของ `lrDeg` / `alignTo` / `worldUpCheck` / `gravityQuat` ถูก (500 กรณีสุ่ม)
  - จำลองการติดตั้งด้วยสูตรเฟิร์มแวร์: ชิปวางราบ ก้ม 15° ได้ pitch −15, ติดข้างศีรษะทีละหู ก้มไปออกที่ roll (ซ้าย −15 / ขวา +15), สองหูพร้อมกันเหลือ ~0, หันซ้าย 20° ได้ yaw +20 ทุกแบบ (ตรงกับ `docs/SENSOR_AXES.md`)
- สิ่งที่พบ (บันทึกเป็นข้อ 8–13 ใน HANDOFF):
  - เครื่องหมายของ `head_pitch` / `mpu_tilt` ขึ้นกับการติดตั้ง ไม่มีค่ากลับเครื่องหมายในเฟิร์มแวร์
  - ไม่มี MPU: ก้ม 10° ได้ 46.3° (เริ่มก้มคอ), 20° ได้ 40.5° (คอยื่น) เทียบกับมี MPU ก้ม 20° ได้ 48.9°
  - `receivePacket()` ไม่ดูบิต continuation, เซ็นเซอร์ที่มาช้าตั้งศูนย์เองโดย `calibration_id` ไม่เปลี่ยน, timeout I2C ค้าง 500 ms, ลบ Euler ทีละแกนได้ yaw ปลอม −10° ตอนก้ม 30° + เอียง 20°
  - สมมติฐานไบต์หายของหูขวา: payload 29 ไบต์ทำให้ไบต์สุดท้ายถูกอ่านแยกรอบ (28 + 1) หรือบิตตกที่ 400 kHz
- ยังไม่ได้ยืนยัน:
  - ทุกข้อใน "สิ่งที่พบ" มาจากการอ่านโค้ดและการจำลอง ยังไม่ได้ยืนยันกับหูฟังจริง
  - ไม่ได้เปิดหน้าเว็บในเบราว์เซอร์รอบนี้ (ไม่ได้แก้ UI) และไม่ได้ยิง API
  - ค่าจากเซ็นเซอร์จริง (ทิศแกน เครื่องหมาย ตั้งศูนย์ CVA จากบอร์ดเทียบเว็บ) ยังเหมือนเดิมคือยังไม่ได้ตรวจ
- งานต่อไป: หาสาเหตุไบต์หายของหูขวา (log ความยาวแพ็กเก็ต + ลองอ่านครั้งเดียว / ลด `COLLECT_I2C_HZ`), ตรวจทิศและเครื่องหมายกับหูฟังจริงด้วย "ตรวจทิศทางเซ็นเซอร์" แล้วแก้ข้อ 8, 10–12 ในเฟิร์มแวร์เมื่อผู้ใช้สั่ง

## 2026-11-10 ตรวจความแม่นยำ BNO ที่ค้างที่ 0
- งานที่ทำ: ผู้ใช้แจ้งว่าความแม่นยำยัง 0 ตรวจแล้วว่าเฟิร์มแวร์อ่านบิต status ถูก แต่ไม่เคยส่งคำสั่ง SH-2 0x07 เปิด dynamic calibration และไม่ได้อ่านเข็มทิศ จึงเพิ่ม `configureCalibration()`, report 0x03 (10 Hz ในโหมดเก็บข้อมูล), อ่านค่าประมาณความคลาดเคลื่อน และ log `ACCURACY` ทุก 1 วินาที
- ไฟล์ที่แตะ: `esp32_c7_prototype/esp32_c7_prototype.ino`, `HANDOFF.md`, `docs/WORKLOG.md`
- ตรวจแล้ว: compile ESP32 Dev Module + core 3.3.12 ผ่าน (941868 B / 71%, RAM 48700 B / 14%)
- ยังไม่ได้ยืนยัน: ยังไม่ได้ flash จึงยังไม่รู้ว่าความแม่นยำขึ้นหรือไม่ และสนามแม่เหล็กที่หูฟังมีค่าเท่าไร
- งานต่อไป: flash เมื่อผู้ใช้สั่ง แล้วให้ผู้ใช้หมุนหูฟังเป็นเลข 8 ระหว่างจับ log `ACCURACY`

## 2026-11-10 flash เฟิร์มแวร์ format 2 และตรวจกับบอร์ดจริง
- งานที่ทำ:
  - flash เฟิร์มแวร์ format 2 ลง COM3 ตามที่ผู้ใช้สั่ง (ครั้งแรกพอร์ตไม่ว่างเพราะหน้า collect ใน Chrome ต่ออยู่ ผู้ใช้ตัดการเชื่อมต่อแล้ว flash ใหม่)
  - อ่านพอร์ตตรงที่ 460800 ส่ง `r` จับ 9.4 วินาทีตอนหูฟังวางนิ่ง แล้วส่ง `n`
- ไฟล์ที่แตะ: `HANDOFF.md`, `docs/WORKLOG.md`
- ตรวจแล้ว:
  - upload สำเร็จ hash verified (sha256 bin `5a26a7f9…`)
  - header `format=2 ... age=ms,ear_poll=interleaved`, บรรทัด `D` 473 บรรทัด 35 ช่องครบทุกบรรทัด, 50.1 บรรทัด/วินาที, `RATE out=50–51`
  - เวลาห่างซ้าย-ขวา เฉลี่ย 9.1 ms, มัธยฐาน 6, p95 24, สูงสุด 64 (หูขวา quaternion 42–47/วินาที)
  - หูซ้าย `q·acc` ตรง +z 1.000 ทุกบรรทัด: โลกของ BNO เป็น z ขึ้น (ENU) ตามที่หน้าเว็บสมมติ
  - พบปัญหาหูขวา: accel z 33/473 บรรทัดเสียไบต์สูง (0x0896 → 0x0096), quaternion เป็น 0 ทั้งหมด 2 บรรทัด, ความแม่นยำ 0, gyro report ≈99/วินาที, rdFail 2 หูซ้ายปกติ
- ยังไม่ได้ยืนยัน:
  - ยังไม่ได้เปิดหน้า `collect.html` ต่อบอร์ดจริง และยังไม่ได้หันศีรษะทดสอบโหมดจัดแนว
  - ยังไม่รู้สาเหตุไบต์หายของหูขวา
- งานต่อไป: ไล่ `receivePacket()` / `getReadings()` ของหูขวา (ความยาวแพ็กเก็ตและ report ID) แล้วตรวจหน้า collect กับหูฟังจริง

## 2026-11-10 ซิงก์สองหู, แกน 3 มิติแทนโมเดล และหน้า collect 3 ส่วนในจอเดียว
- งานที่ทำ:
  - ผู้ใช้ขอให้ BNO สองหู sync กัน, ดูแกน 3 มิติของทั้งสองข้างว่าถ้าติดแนวเดียวกันจะทำมุมอย่างไรตอนขยับ, เปลี่ยนโมเดลหุ่นเป็นแกน x/y/z พร้อมบอกทิศและค่า accel ฯลฯ และให้เห็น สถานะ / กราฟ / มุมการหมุน ในหน้าเดียว
  - เฟิร์มแวร์ `COLLECT_FORMAT` 2: อ่าน BNO ซ้าย-ขวาสลับกันทีละแพ็กเก็ต (`pollEarStep()`) และต่อท้ายบรรทัด `D` ด้วยอายุค่า `L_age,R_age,C_age` (ms)
  - `c7-collect.js` `FORMAT` 2 (ยังอ่าน format 1 ได้), อายุค่าและ `skewMs`, CSV 49 คอลัมน์, ฟังก์ชัน `alignTo` / `relRotation` / `worldAxes` / `worldAcc` / `worldUpCheck` / `gravityQuat` / `dirName`, ข้อมูลจำลองเปลี่ยนเป็นโลก ENU และติดชิปสองหูแบบกระจก
  - `assets/axes-view.js` ใหม่: แกน x/y/z ของแต่ละเซ็นเซอร์ในโลก ENU, คำบอกทิศบนพื้น, ลูกศร accel, แยกกัน/ซ้อนกัน
  - `collect.html` / `collect.css` / `collect.js`: 3 คอลัมน์ (สถานะ | กราฟ | 3 มิติ) บนจอ ≥ 1280 px, แผงซิงก์สองหู, กราฟเวลาห่างซ้าย-ขวา, โหมด ตามที่ติดจริง/จัดแนวให้ตรงกัน, ตารางค่าใต้ภาพ, มุมระหว่างสองหู, เตือนเมื่อเวลาห่างเฉลี่ยเกิน 10 ms และเมื่อเฟิร์มแวร์เป็น format 1
- ไฟล์ที่แตะ: `esp32_c7_prototype/esp32_c7_prototype.ino`, `assets/c7-collect.js`, `assets/axes-view.js` (ใหม่), `assets/collect.js`, `assets/collect.css`, `collect.html`, `scripts/check-web.mjs`, `docs/DATA_COLLECTION.md`, `README.md`, `AGENTS.md`, `HANDOFF.md`, `docs/WORKLOG.md`
- ตรวจแล้ว:
  - `node scripts/check-web.mjs` 34/34 ผ่าน (เพิ่ม 3 ข้อ), `node --check assets/*.js` ผ่านทุกไฟล์, `git diff --check` ผ่าน
  - compile ESP32 Dev Module + core 3.3.12 ผ่าน (940596 B / 71%, RAM 48660 B / 14%) ไม่ได้ flash (arduino-cli เตือนเรื่อง signature ของ library index หมดอายุ แต่ compile สำเร็จ)
  - `collect.html?demo` ในเบราว์เซอร์: 3 ส่วนในจอเดียวที่ 1700 px, แยกกัน/ซ้อนกัน, จัดแนวแล้วแกนหูขวาทับหูซ้าย (δ 0.0°), ตารางทิศถูกตามที่ติดในข้อมูลจำลอง (หูซ้าย x ใต้ y ขึ้น z ตะวันตก), เวลาห่าง 1–5 ms, บันทึก 2 วินาทีได้ 100 แถว 49 คอลัมน์, 375 px ไม่ล้น, ธีมสว่าง/มืด, console ไม่มี error
- ยังไม่ได้ยืนยัน:
  - ยังไม่ได้ flash format 2 จึงยังไม่รู้เวลาห่างซ้าย-ขวาจริงและ 50 Hz หลังอ่านสลับ
  - ยังไม่รู้ว่าโลกของ BNO085 บนบอร์ดเป็น ENU จริง (แถว "z โลกตรงแรงโน้มถ่วง" ไว้เช็ก) และทิศเหนือขึ้นกับเข็มทิศของชิป
  - ไม่ได้เปิด `index.html` / `dev.html` ซ้ำ เพราะไม่ได้แตะไฟล์ที่สองหน้านั้นใช้
- งานต่อไป: flash format 2 เมื่อผู้ใช้สั่ง แล้วตรวจเวลาห่างซ้าย-ขวา, เช็ก z โลก และโหมดจัดแนวกับหูฟังจริง

## 2026-11-10 ย้ายกราฟกลับที่เดิม เหลือแค่โมเดลข้างกราฟ
- งานที่ทำ (ตามที่ผู้ใช้ขอ):
  - เอาแผงโมเดลแยกออก กราฟกลับไปอยู่บนสุดฝั่งขวา
  - ใส่โมเดลศีรษะอย่างเดียวไว้ข้างกราฟในแผงเดียวกัน (ด้านหน้า, แบบกระจก, ชิปบอก "ข้อมูลจำลอง" / "จากเซ็นเซอร์")
  - จอแคบ (≤ 900 px) โมเดลขึ้นไปอยู่เหนือกราฟ
  - เอาตารางตรวจท่า, มุมทีละหู, คำเตือนหักล้าง, ตัวเลือกมุมมองและกระจกออก (`firmwareHead()` และเทสต์ยังอยู่)
- ไฟล์ที่แตะ: `collect.html`, `assets/collect.js`, `assets/collect.css`, `docs/DATA_COLLECTION.md`, `README.md`, `AGENTS.md`, `HANDOFF.md`, `docs/WORKLOG.md`
- ตรวจแล้ว:
  - `check-web` 31/31 ผ่าน, `node --check` ผ่าน, `git diff --check` ผ่าน
  - `collect.html?demo`: โมเดลอยู่ข้างกราฟและขยับ, 375 px ไม่ล้น (โมเดลอยู่เหนือกราฟ), ธีมสว่างและมืด, console ไม่มี error
- ยังไม่ได้ยืนยัน: โมเดลหันถูกทางกับหูฟังจริง
- งานต่อไป: ลองกับหูฟังจริง
- commit: `cee351e` push ขึ้น `web/feature/user-web` แล้ว

## 2026-11-10 commit และ push งานหน้าเก็บข้อมูล
- งานที่ทำ: commit งานค้างทั้งหมดเป็น `32a8d2c` แล้ว push `feature/user-web` ขึ้น remote `web` (https://github.com/67160366/C7-earphone-web) ไม่ได้ push ไป `origin`
- ไฟล์ที่แตะ: `HANDOFF.md`, `docs/WORKLOG.md` (บันทึก commit)
- ตรวจแล้ว: `check-web` 31/31 ผ่าน, `node --check assets/*.js` ผ่าน, `git diff --check` ผ่าน, push สำเร็จ (`ccc2e9b..32a8d2c`)
- ยังไม่ได้ยืนยัน: เหมือนรายการก่อนหน้า (หน้า collect ยังต้องตรวจกับหูฟังจริงตามขั้นตอนท่า)
- งานต่อไป: ตามรายการก่อนหน้า

## 2026-11-10 โมเดล 3 มิติและคำอธิบายค่าในหน้าเก็บข้อมูล
- งานที่ทำ:
  - `c7-collect.js`:
    - `headTare()` และ `firmwareHead()` คิดมุมศีรษะแบบเดียวกับ loop ของเฟิร์มแวร์ ได้แก่ Euler ชิปลบท่าเริ่มต้น, ค่ากลางสองหู, ตัดช่วง
    - คืนค่าก่อนตัด และมุมที่เปลี่ยนทีละหูด้วย
  - `collect.html` / `collect.js` / `collect.css`:
    - แผงโมเดล 3 มิติ (ใช้ `neck-model.js` แบบหน้า dev) เลือกมุมมองได้ และแสดงแบบกระจกเป็นค่าเริ่มต้น
    - ตารางตรวจท่าพร้อมค่าตอนนี้, มุมที่เปลี่ยนทีละหู และเตือนเมื่อสองหูหักล้างกัน
    - แผง "อ่านค่าในหน้านี้": ที่มาของค่า, วิธีอ่านกราฟ, ตารางคอลัมน์ CSV
    - กด "ตั้งท่าเริ่มต้น" หรือเริ่มส่งค่าดิบแล้ว จะตั้งท่าเริ่มต้นของโมเดลใหม่
  - แก้ panel ฝั่งขวาล้นจอ 7 px ที่ 375 px (คอลัมน์ grid ของ `.block` ไม่ยอมหด)
  - เอกสาร: `docs/DATA_COLLECTION.md` เพิ่มหัวข้อโมเดล 3 มิติ, README, AGENTS
- ไฟล์ที่แตะ: `assets/c7-collect.js`, `assets/collect.js`, `assets/collect.css`, `collect.html`, `scripts/check-web.mjs`, `docs/DATA_COLLECTION.md`, `README.md`, `AGENTS.md`, `HANDOFF.md`, `docs/WORKLOG.md`
- ตรวจแล้ว:
  - `check-web` 31/31 ผ่าน, `node --check` ผ่าน
  - เบราว์เซอร์ `collect.html?demo`:
    - โมเดลโหลดได้และขยับ ชิปขึ้น "ข้อมูลจำลอง · เฉลี่ยสองหู" และตารางมีค่า
    - 375 px ไม่ล้นหลังแก้ (scrollWidth 375)
    - ธีมสว่างและมืด, console ไม่มี error
- ยังไม่ได้ยืนยัน: โมเดลหันถูกทางกับหูฟังจริงหรือไม่ (ยังไม่ได้ลองกับบอร์ด)
- งานต่อไป: ใส่หูฟัง กด "ตั้งท่าเริ่มต้น" แล้วทำ 4 ท่าในตาราง บันทึกว่าท่าไหนออกที่ค่าไหนลง WORKLOG

## 2026-11-10 Flash รุ่น 460800 กลับ (สำเร็จ หลังผู้ใช้ปิดโปรแกรมที่เปิด COM3)
- งานที่ทำ: upload บิลด์ `da83c32d…` เข้า COM3 แล้วรีบูตอ่าน 460800 พร้อมลอง `r` / `n`
- ไฟล์ที่แตะ: `HANDOFF.md`, `docs/WORKLOG.md`
- ตรวจแล้ว:
  - upload ผ่านครั้งแรก
  - PinCheck `OK_PULLUP_3V3` ทั้งคู่ (ผู้ใช้แก้สายแล้ว) และ ACK 0x4A, 0x4B, 0x68
  - หูซ้ายได้ quaternion ตอนบูต หูขวาได้หลัง health check เปิด report ใหม่
  - `r` ได้ 123 บรรทัด `D` ใน ~2.5 วินาที, `RATE` วินาทีที่ 2: L q51/a64/g51, R q40/a47/g88, C7 38, out 52
  - `n` กลับโหมดปกติ
- ยังไม่ได้ยืนยัน:
  - gyro หูขวากระโดดระหว่างใกล้ 0 กับ 13–22 rad/s ในบรรทัดติดกัน ไม่รู้ว่าเพราะบอร์ดถูกขยับหรือแยก report ผิด
  - อัตราต่อเนื่องนานกว่า 2 วินาที, ยังไม่ได้เชื่อมต่อจากหน้า `collect.html` (ต้องเลือกพอร์ตเอง)
- งานต่อไป: วางหูฟังนิ่งแล้วดู gyro หูขวาในหน้า collect

## 2026-11-10 Flash รุ่น 460800 กลับ (ครั้งแรกไม่สำเร็จ)
- งานที่ทำ: ผู้ใช้สั่ง flash รุ่นใน working tree กลับ compile ใหม่ได้ sha256 `da83c32d…` (เท่ากับที่ flash ครั้งแรก)
- ไฟล์ที่แตะ: `docs/WORKLOG.md`
- ตรวจแล้ว:
  - upload ล้มเหลว 3 ครั้ง (เว้น 5 วินาที) `exit status 2`
  - Windows เห็น COM3 แต่เปิดไม่ได้ "Access to the port 'COM3' is denied" แปลว่ามีโปรแกรมอื่นเปิดพอร์ตค้างอยู่ ไม่ใช่สคริปต์ของเราหรือหน้าเว็บในแอป
- ยังไม่ได้ยืนยัน: บอร์ดยังเป็นรุ่นเก่า (115200)
- งานต่อไป: ปิดโปรแกรมที่เปิด COM3 อยู่ (Serial Monitor หรือแท็บ Chrome ที่ต่อ USB) แล้ว upload ใหม่

## 2026-11-10 Flash เฟิร์มแวร์รุ่นเก่ากลับ (สำเร็จ)
- งานที่ทำ: หลังเสียบ USB ใหม่ upload บิลด์รุ่นเก่า (88d3b35, 115200, sha256 `72d72e06…e7db`) เข้า COM3
  - ครั้งแรก "port is used by another task" เพราะพอร์ตยังไม่พร้อมหลังเสียบ รอ 5 วินาทีแล้วเปิดได้
- ไฟล์ที่แตะ: `HANDOFF.md`, `docs/WORKLOG.md`
- ตรวจแล้ว:
  - "Hash of data verified"
  - รีบูตแล้วอ่าน 115200: บูตครบ 6 ขั้น ส่ง JSON v2
  - **PinCheck ยังเป็น `D21(SDA)=LOW_STUCK`, `D22(SCL)=LOW_STUCK`** ไม่มีเซ็นเซอร์ตอบ และ `s` ค้างหลัง `FULL_SCAN_BEGIN` เหมือนรุ่นใหม่
  - สรุป: ปัญหาอยู่ที่สายหรือฮาร์ดแวร์ ไม่ใช่เฟิร์มแวร์โหมดเก็บข้อมูล
- ยังไม่ได้ยืนยัน: ค่าจากเซ็นเซอร์จริง
- งานต่อไป: หาโมดูลที่ดึง SDA/SCL ลง GND แล้ว flash รุ่น 460800 กลับเพื่อใช้ `collect.html`

## 2026-11-10 พยายาม flash เฟิร์มแวร์รุ่นเก่ากลับ (ครั้งแรกไม่สำเร็จ)
- งานที่ทำ:
  - ผู้ใช้สั่ง flash รุ่นเก่าก่อน จึงดึง `esp32_c7_prototype.ino` จาก HEAD (88d3b35, 115200 baud) มา compile แยกใน scratchpad
  - compile ผ่าน 935688 B (ขนาดเท่ากับที่ flash เมื่อ 2026-11-09)
- ไฟล์ที่แตะ: `HANDOFF.md`, `docs/WORKLOG.md`
- ตรวจแล้ว:
  - upload ล้มเหลว `Failed uploading: exit status 2`
  - `arduino-cli board list` และ Windows เห็นแค่ COM1 คือ **COM3 หายไป** และหน้าเว็บไม่ได้เปิดพอร์ตค้างไว้
- ยังไม่ได้ยืนยัน: บอร์ดยังเป็นรุ่น 460800 อยู่ ยังไม่ได้ flash รุ่นเก่า
- งานต่อไป: เสียบ USB ใหม่ให้ COM3 กลับมา แล้ว upload บิลด์ที่เตรียมไว้

## 2026-11-10 Flash เฟิร์มแวร์โหมดเก็บข้อมูลเข้าบอร์ด
- งานที่ทำ:
  - flash `esp32_c7_prototype.ino` (sha256 `da83c32d…6230`) เข้า COM3 ตามที่ผู้ใช้สั่ง ใช้ FQBN และ arduino-cli ชุดเดิม
  - อ่าน serial ที่ 460800 และลองคำสั่ง `s` / `r` / `n`
  - เปิด `collect.html` ในเบราว์เซอร์ในแอป (Claude in Chrome ต่อไม่ได้)
- ไฟล์ที่แตะ: `HANDOFF.md`, `docs/WORKLOG.md` (ไม่ได้แก้โค้ด)
- ตรวจแล้ว:
  - compile ผ่าน (940404 B / 71%), upload ผ่าน "Hash of data verified"
  - 460800 baud อ่านได้ บูตครบ 6 ขั้น
  - `r` ได้ `H,format=1,...` และบรรทัด `D` 50 บรรทัดต่อวินาที, `RATE` ทุกวินาที
  - **PinCheck: `D21(SDA)=LOW_STUCK`, `D22(SCL)=LOW_STUCK`** ไม่มีเซ็นเซอร์ตอบ ทุกช่องใน `D` จึงว่าง
  - รอบแรกหลัง flash หูซ้าย (0x4A) ได้ quaternion 1 ครั้ง (`quats=1, rep=0x28`) แล้วหลุด
  - คำสั่ง `s` ค้างหลัง `I2C FULL_SCAN_BEGIN` ตอนบัสค้าง (แต่ละ address รอ timeout)
  - ตอนบัสค้าง บรรทัด `D` หายช่วงสั้น ๆ ราว 450 ms (`out=28`) จาก health check
  - หน้า collect เปิดในเบราว์เซอร์ในแอปได้ และมี Web Serial แต่ช่องเลือกพอร์ตต้องให้ผู้ใช้เลือกเอง
- ยังไม่ได้ยืนยัน: ค่าจากเซ็นเซอร์จริงทั้งหมด (50 Hz ต่อ report, I2C 400 kHz) เพราะสาย I2C ค้าง LOW
- งานต่อไป: หาว่าโมดูลไหนดึง SDA/SCL ลง GND แล้วรีบูต ดู PinCheck จากนั้นเชื่อมต่อจากหน้า collect

## 2026-11-10 โหมดเก็บข้อมูลดิบ 50 Hz และหน้า collect.html
- งานที่ทำ:
  - **เฟิร์มแวร์:**
    - เปลี่ยน USB เป็น 460800 baud
    - เพิ่มคำสั่ง `r` / `n` สำหรับโหมดเก็บข้อมูล: บรรทัด `D` 50 Hz ของหูซ้าย/ขวา (quat, accel, gyro, ความแม่นยำ) และ MPU (accel, gyro), `H` ทุก 5 วินาที, `RATE` ทุก 1 วินาที, JSON v2 1 Hz
    - BNO เปิด 0x28 + 0x01 + 0x02 ทุก 20 ms และปิด 0x05/0x08 ในโหมดนี้
    - `getReadings()` แยกทุก report ในแพ็กเก็ต
    - I2C 400 kHz เฉพาะโหมดนี้
    - MPU ตั้ง DLPF ~44 Hz และอ่าน gyro เพิ่ม
  - **หน้าเว็บ:**
    - `c7-core.js`: `BAUD`, อ่านบรรทัด `H`/`D`, บรรทัด `D` นับเป็นสัญญาณ live
    - ใหม่ `assets/c7-collect.js`: แปลงหน่วย, quaternion, δ ซ้าย-ขวา, CSV, รายการท่า, `CollectSimulator`
    - ใหม่ `collect.html` + `assets/collect.js` + `assets/collect.css`: สถานะ, กราฟสด, ขั้นตอนท่า, ป้าย, มุมอ้างอิง, ดาวน์โหลด CSV/JSON
    - หน้า dev มีลิงก์ไปหน้าเก็บข้อมูล
  - **เอกสาร:**
    - ใหม่ `docs/DATA_COLLECTION.md`: รูปแบบบรรทัด, คอลัมน์ และวิธีเก็บข้อมูลที่แนะนำ
    - แก้ README, AGENTS, docs/README
    - `.gitignore` เพิ่ม `data/` และ `SIM_*`
- ไฟล์ที่แตะ: `esp32_c7_prototype/esp32_c7_prototype.ino`, `assets/c7-core.js`, `assets/c7-collect.js`, `assets/collect.js`, `assets/collect.css`, `collect.html`, `dev.html`, `scripts/check-web.mjs`, `docs/DATA_COLLECTION.md`, `README.md`, `AGENTS.md`, `docs/README.md`, `.gitignore`, `HANDOFF.md`, `docs/WORKLOG.md`
- ตรวจแล้ว:
  - `check-web` 30/30 ผ่าน (เพิ่ม 9 ข้อ และแก้ข้อ baud เป็น 460800)
  - `node --check assets/*.js` ผ่าน, `git diff --check` ผ่าน
  - compile ESP32 ผ่าน (940324 B / 71%, RAM 14%)
  - parser ของ `SafeBNO085` ดึงออกมา compile ด้วย g++ และป้อนแพ็กเก็ตปลอม 5 แบบ ผ่านทุกข้อ
  - เบราว์เซอร์ `collect.html?demo`:
    - 50 บรรทัด/วินาที ทั้ง 3 ตัว 50 Hz
    - เดินขั้นตอนท่าจนจบ ได้ CSV 426 แถว 46 คอลัมน์ ป้ายท่าและมุมอ้างอิง 47.5 ถูกช่วง และ `simulated=1`
    - 375 px ไม่ล้น, ธีมสว่าง/มืด, console ไม่มี error
  - เจอและแก้ระหว่างทาง: δ ซ้าย-ขวาขึ้น 1.05° ทั้งที่หัวจำลองแข็ง เพราะ quaternion Q14 ไม่ได้ยาว 1 พอดี แก้ด้วย normalize ก่อน `acos` เหลือ ~0.01°
  - `index.html?demo` และ `dev.html` ข้อมูลจำลองยังทำงาน ไม่มี error
- ยังไม่ได้ยืนยัน:
  - **ยังไม่ได้ flash และยังไม่ได้ต่อเซ็นเซอร์** จึงยังไม่รู้ว่า 460800 baud, 50 Hz ต่อ report, I2C 400 kHz และการสลับโหมดใช้ได้จริง
  - บอร์ดที่ยังเป็นรุ่น 115200 จะอ่านจากหน้าเว็บรุ่นนี้ไม่ได้
  - ยังไม่ได้เปิดไฟล์ที่ดาวน์โหลดจริงจาก UI (ตรวจจาก Blob ในหน้า)
- งานต่อไป: flash เมื่อผู้ใช้สั่ง ต่อเซ็นเซอร์ให้สแกนเจอ แล้วดู `RATE` ในหน้า collect ก่อนเก็บข้อมูลทดลอง 1 คน

## 2026-11-09 ตั้งสภาพแวดล้อมในเครื่องใหม่
- งานที่ทำ:
  - เครื่องนี้ไม่มี PHP, Node และ `D:\work\HeadSet\.local` (arduino-cli เดิม) จึงติดตั้งผ่าน winget: PHP 8.4.27, Node 24.20.0 (LTS), arduino-cli 1.5.1
  - ตั้ง arduino-cli ให้ใช้ `.local/arduino-cli.yaml` และเก็บข้อมูลไว้ใน `.local/arduino/` (gitignore แล้ว) แล้วติดตั้ง ESP32 core 3.3.12
    - github.com ตอบ 504 กับไฟล์ release หลายไฟล์ จึงดาวน์โหลดผ่าน GitHub API (`/releases/assets/<id>`) แทน และตรวจ SHA-256 ตรงกับ index ทุกไฟล์ก่อนติดตั้ง
  - ไม่สร้าง `.env` เพราะโค้ดไม่อ่าน environment variable
- ไฟล์ที่แตะ: `HANDOFF.md`, `docs/WORKLOG.md` (ไฟล์ตั้งค่าอยู่ใน `.local/` ไม่เข้า git)
- ตรวจแล้ว:
  - `check-web` 21/21 ผ่าน, `node --check assets/*.js` ผ่านทุกไฟล์
  - `scripts/serve.ps1` เปิด server ได้ที่ 8090 หน้า `?demo` และ `dev.html` โหลดได้ console ไม่มี error
  - compile เฟิร์มแวร์ ESP32 Dev Module + core 3.3.12 ผ่าน (935672 B / 71%, RAM 48508 B / 14%) ไม่ได้ flash
- ยังไม่ได้ยืนยัน:
  - PHP ไม่มี `php.ini` จึงไม่มี `pdo_mysql` ยังไม่ได้ยิง API ในเครื่องนี้
  - ยังไม่ได้ต่อบอร์ดหรือเชื่อม USB จาก Chrome/Edge ในเครื่องนี้
- งานต่อไป: ต่อเซ็นเซอร์ให้สแกน I2C เจอ แล้วตรวจกับข้อมูลจริง

## 2026-11-09 สร้าง repo ใหม่และ push
- งานที่ทำ:
  - สร้าง repo public `67160366/C7-earphone-web` ตามที่ผู้ใช้สั่ง (ชื่อและการเปิด public ผู้ใช้เลือกเอง)
  - เพิ่ม remote `web` แล้ว push `feature/user-web` และตั้งเป็น default branch
  - commit งานค้างก่อน push เป็น `b9c5b6a`
- ไฟล์ที่แตะ: `HANDOFF.md`, `docs/WORKLOG.md`
- ตรวจแล้ว:
  - ก่อนเปิด public ได้สแกนหาความลับใน 51 ไฟล์ ไม่พบ token, key หรือ `.env` มีแค่อีเมลของผู้ใช้เอง และรหัส MySQL ค่าเริ่มต้นของ XAMPP (`root`, รหัสว่าง)
  - `gh repo view` ได้ PUBLIC, default=`feature/user-web`, fork=false
  - commit ทั้งหมดบน GitHub เป็นชื่อผู้ใช้หรือเพื่อน (upstream) มี contributors แค่ 67160366 และ 67160162-BUU
- ยังไม่ได้ยืนยัน: ไม่มี
- งานต่อไป: ต่อเซ็นเซอร์ให้สแกน I2C เจอ แล้วตรวจกับข้อมูลจริง

## 2026-11-09 แก้คางและปากบิดตอนก้มเงย, หน้า dev แสดงแบบกระจก
- งานที่ทำ:
  - **คางยืดตอนเงย และปากบิดตอนก้ม:**
    - สาเหตุ: เส้นแบ่งหัวกับคอใน `neck-model.js` ต่ำผิด (ลากจาก −5, 9.4 cm ไป 10.5, 5.8 cm) และยังมีตัวคูณ `u` ทำให้คางกับริมฝีปากล่างไปผูกกับกระดูกคอ
    - แก้: ใช้เส้นจากร่องท้ายทอย (3.4, 7.5) ไปร่องใต้คาง (12.5, 1.0) cm ที่วัดจากโปรไฟล์กลางของสแกน และเอาตัวคูณ `u` ออก
  - **เอียงซ้ายขวาดูสลับ:**
    - หน้า dev ตั้ง `setMirror(false)` ส่วนหน้าผู้ใช้แสดงแบบกระจก ทิศตามแกนถูกทั้งคู่ แต่สองหน้าแสดงต่างกัน
    - แก้: หน้า dev แสดงแบบกระจกเป็นค่าเริ่มต้น และมีสวิตช์ปิดได้
- ไฟล์ที่แตะ: `assets/neck-model.js`, `assets/dev-formula.js`, `dev.html`, `docs/FORMULA.md`
- ตรวจแล้ว:
  - `check-web` 21/21 ผ่าน, `node --check assets/*.js` ผ่าน, `git diff --check` ผ่าน
  - หน้า dev มุมมองด้านหน้า:
    - เงย −25° และก้ม 45° แล้วใบหน้า คาง และปากไม่บิดหรือยืด
    - roll +20 (หูขวาลง) แบบกระจกแล้วภาพเอียงไปทางขวาของจอ
  - console ไม่มี error
- ยังไม่ได้ยืนยัน:
  - ยังไม่ได้จับภาพหน้าผู้ใช้ตอนเอียงขวาใน demo (ช่วงนั้นสั้น) แต่ใช้โมเดลเดียวกันและแสดงแบบกระจกเหมือนกัน
  - ทิศ roll ของเซ็นเซอร์จริงยังตรวจไม่ได้ เพราะบอร์ดยังไม่เห็นเซ็นเซอร์ และเฟิร์มแวร์ยังมีปัญหาแกนตาม `docs/SENSOR_AXES.md`
- งานต่อไป: ต่อเซ็นเซอร์ให้สแกนเจอ แล้วใช้ "ตรวจทิศทางเซ็นเซอร์" ในหน้า dev

## 2026-11-09 Flash เฟิร์มแวร์ v2 เข้าบอร์ด
- งานที่ทำ: flash `esp32_c7_prototype.ino` (sha256 `0d9ab777…1942`) เข้า ESP32-D0WD-V3 ที่ COM3 ตามที่ผู้ใช้สั่ง
  - FQBN `esp32:esp32:esp32:FlashMode=dio,FlashFreq=40,FlashSize=4M,PartitionScheme=default,UploadSpeed=115200` แบบเดียวกับครั้งก่อน
  - ใช้ arduino-cli ใน `D:\work\HeadSet\.local`
- ไฟล์ที่แตะ: ไม่มีไฟล์โค้ด (ไฟล์ build อยู่ใน scratchpad)
- ตรวจแล้ว:
  - compile ผ่าน (935688 B / 71%, RAM 14%)
  - upload ผ่าน "Hash of data verified"
  - อ่าน serial 12 วินาที: บอร์ดส่ง `protocol_version: 2`, `geometry_id: 1` พร้อม field `mpu_tilt`, `mpu_tilt_raw`, `tilt_estimated` ครบ
  - **คำสั่ง `s` สแกน I2C ได้ `Wire(21/22)=[NONE]`** ไม่มีเซ็นเซอร์ตอบเลย (ทั้ง 0x4A, 0x4B, 0x68) และ DIAG แสดง `ack=0` ทุกตัว
- ยังไม่ได้ยืนยัน:
  - ข้อมูลจริงจากเซ็นเซอร์ เพราะบอร์ดยังไม่เห็นเซ็นเซอร์ ต้องตรวจสายหรือไฟเลี้ยง
  - CVA จากบอร์ดเทียบกับหน้าเว็บด้วยข้อมูลจริง
  - ทิศแกน
- งานต่อไป: ตรวจสาย SDA 21 / SCL 22, 3.3V, GND และขา PS0/PS1 ของ BNO085 แล้วกด "สแกน I2C" ในหน้า dev ใหม่

## 2026-11-09 ย้ายแผงการเชื่อมต่อเซ็นเซอร์ขึ้นบนสุดในหน้า dev, พยายาม flash v2
- งานที่ทำ:
  - ย้ายแผง "การเชื่อมต่อเซ็นเซอร์" (0x4A / 0x4B / 0x68 และผลสแกน I2C) กับแผง "บอร์ด" ขึ้นเหนือแผงสูตร
  - สองแผงวางคู่กันบนจอกว้าง และเรียงลงมาบนจอแคบ
- ไฟล์ที่แตะ: `dev.html`, `assets/dev.css`
- ตรวจแล้ว:
  - หน้า dev เปิดได้ และแผงเซ็นเซอร์อยู่บนสุด (ที่ 1280 px วางคู่กัน)
  - 375 px ไม่ล้นจอ
  - console ไม่มี error
- ยังไม่ได้ยืนยัน: **ยังไม่ได้ flash v2** เพราะ COM3 (บอร์ด ESP32-D0WD-V3) ถูกโปรแกรมอื่นเปิดค้างอยู่ ("Access to the port 'COM3' is denied")
- งานต่อไป: ปิดโปรแกรมที่ใช้ COM3 แล้ว flash เฟิร์มแวร์ v2

## 2026-11-09 commit งานหน้าเว็บและสูตรใหม่
- งานที่ทำ: commit ทุกไฟล์ในโฟลเดอร์ทำงานลง `feature/user-web` เป็น `88d3b35` (49 ไฟล์) ในชื่อ `67160366 <67160366@go.buu.ac.th>` ไม่มีชื่อ Claude ในข้อความ commit
- ไฟล์ที่แตะ: `HANDOFF.md`, `docs/WORKLOG.md`
- ตรวจแล้ว:
  - `git diff --cached --check` เจอแค่ช่องว่างท้ายบรรทัดใน `assets/fonts/OFL.txt` ซึ่งเป็นข้อความสัญญาอนุญาตของฟอนต์ จึงคงไว้ตามต้นฉบับ
  - ไม่มีไฟล์ `.env`, `.local/` หรือ log ใน commit
  - `api/posture_logs.csv` และ `api/latest_angle.json` ไม่มีการเปลี่ยนแปลง
- ยังไม่ได้ยืนยัน: ยังไม่ได้ push และยังไม่ได้ทดสอบกับบอร์ดจริง
- งานต่อไป: flash v2 แล้วตรวจกับบอร์ดจริงในหน้า dev

## 2026-11-09 สูตร CVA ใหม่ (geometry 1), Protocol v2, โมเดลคองอได้, แผงสูตรในหน้า dev
- งานที่ทำ:
  - **ตรวจปัญหาสูตรเดิม** (ใช้ agent 3 ตัว):
    - ยืนยันว่าเฟิร์มแวร์ผสม 0.35·pitch เข้าไปใน `c7_angle` และนับ pitch 3 ครั้ง
    - เงยหน้าสวนตอนยื่นคอทำให้ CVA ดีขึ้น (+10/−10 ได้ 50.46° ซึ่งนับเป็นท่าดี)
    - roll/yaw เปลี่ยน CVA
    - ค่าคงที่ไม่มีหน่วยและไม่มีที่มา
    - คอในโมเดลเป็นทรงกระบอกแข็ง และหัวที่สแกนถูกตัดเป็นรู
    - มุมที่วาดบนโมเดล (ราว 65°) ไม่ใช่ตัวเลขที่แสดง (52°)
  - **สูตรใหม่ geometry 1:** แบบจำลอง 2 ท่อนในระนาบด้านข้าง หน่วย cm
    - φ0 คำนวณจากสมการ
    - tilt จาก MPU กับ pitch จาก BNO แยกกัน
    - roll/yaw ไม่เข้าสูตร
    - ใส่ไว้ใน `c7-core.js`, เฟิร์มแวร์ และ PHP
  - **Protocol v2:**
    - เฟิร์มแวร์ส่ง `mpu_tilt`, `mpu_tilt_raw`, `tilt_estimated`, `geometry_id`
    - เว็บรับ v1 ได้โดยถอด pitch กลับเอง
    - PHP ตรวจชนิดและช่วงค่า แล้วคิดสูตรใหม่
  - **โมเดล 3 มิติ:** เปลี่ยนเป็น skinned mesh ชิ้นเดียวมีกระดูก 5 ชิ้น
    - ผิวไล่น้ำหนักต่อเนื่อง
    - หมุนสแกนให้เส้น C7→ติ่งหูตรงกับท่าศูนย์
    - เส้นวัดมุมวาดจาก `cvaParts()`
  - **หน้า dev:** เพิ่มแผงสูตรทีละขั้น (ค่าดิบพร้อมที่มา, ค่าคงที่, 8 บรรทัดที่แทนตัวเลขจริง, SVG ด้านข้าง, โมเดล 3 มิติ, เทียบสูตรเก่า, ข้อจำกัด) และเปลี่ยนตัวเลื่อนเป็น tilt พร้อมตัวเลือกมี/ไม่มี MPU
  - **หน้าผู้ใช้:** ข้อความเป็น "มุมคอ (ค่าประมาณ)" และ demo มีช่วงยื่นคอพร้อมเงยหน้าสวน
  - **เอกสาร:** เพิ่ม `docs/FORMULA.md`
- ไฟล์ที่แตะ:
  - โค้ดหน้าเว็บ: `assets/c7-core.js`, `assets/neck-model.js`, `assets/user.js`, `assets/dev.js`, `assets/dev-formula.js` (ใหม่), `assets/dev.css`, `dev.html`
  - เฟิร์มแวร์: `esp32_c7_prototype/esp32_c7_prototype.ino`
  - API: `api/save_angle.php`, `api/get_latest.php`, `api/db_init.sql`
  - เทสต์: `scripts/check-web.mjs`
  - เอกสาร: `docs/FORMULA.md` (ใหม่), `docs/SENSOR_AXES.md`, `docs/README.md`, `README.md`, `AGENTS.md`, `HANDOFF.md`
- ตรวจแล้ว:
  - `node scripts/check-web.mjs`: 21/21 ผ่าน
  - `node --check assets/*.js`: ผ่าน
  - `git diff --check`: ผ่าน
  - เฟิร์มแวร์:
    - `calculateCVA()` compile ด้วย g++ เทียบกับ JS: ต่างไม่เกิน 7.9e-6° (63 จุด)
    - arduino-cli `esp32:esp32:esp32` core 3.3.12: compile ผ่าน (flash 935608 B / 71%, RAM 48508 B / 14%) ยังไม่ได้ flash
  - PHP:
    - `php -l` ทั้งสองไฟล์ผ่าน
    - `cva_geometry1` เทียบกับ JS: ต่างไม่เกิน 4.9e-11°
    - curl ไป API: v2 / v2 ไม่มี MPU / v1 / CVA ไม่ตรง / ชนิดผิด / ค่าเกินช่วง ได้ผลตามคาด
    - `git restore api/posture_logs.csv api/latest_angle.json` แล้ว
  - เบราว์เซอร์ (โหมดจำลอง):
    - `?demo` ผ่านครบ ท่าดี / เริ่มก้มคอ / คอยื่น และแถบเตือน "คอยื่นมา 15 วินาทีแล้ว"
    - หน้า dev: tilt +15/pitch −6 ได้ 40.17° (สูตรเก่า 46.49°)
    - โมเดลไม่หักทั้งตอนก้ม 45° และเงย −25°
    - 375 px ไม่ล้นจอทั้งสองหน้า (แก้ grid ของแผงสูตรแล้ว)
    - ธีมสว่างและธีมมืด
    - console ไม่มี error
- ยังไม่ได้ยืนยัน:
  - ยังไม่ได้ทดสอบกับหูฟังและบอร์ดจริง และยังไม่ได้ flash v2
  - ค่าคงที่และเกณฑ์ยังเป็นค่าสมมติ
  - ตำแหน่ง MPU จับการยื่นคอได้จริงหรือไม่
  - ALTER ของ MySQL (เครื่องนี้ไม่มี MySQL)
- งานต่อไป: flash v2 แล้วตรวจกับบอร์ดจริงในหน้า dev, ตรวจทิศแกน, แล้วปรับเทียบ 4 ท่า

## 2026-11-09 ตั้งกฎการทำงานและไฟล์ส่งต่อ
- งานที่ทำ: เพิ่มกฎการทำงาน (ต้องอัปเดต HANDOFF และ WORKLOG ทุกครั้ง), สถานะปัจจุบัน, บันทึกงาน, สคริปต์เปิด server และ `.gitignore`
- ไฟล์ที่แตะ: `AGENTS.md`, `CLAUDE.md`, `HANDOFF.md`, `docs/WORKLOG.md`, `docs/README.md`, `scripts/serve.ps1`, `.gitignore`
- ตรวจแล้ว: `scripts/serve.ps1` เปิดและปิด server ได้ (HTTP 200), `node scripts/check-web.mjs` 17/17 ผ่าน, `git diff --check` ผ่าน
- ยังไม่ได้ยืนยัน: ไม่มีเพิ่ม
- งานต่อไป: ตรวจทิศทางเซ็นเซอร์กับหูฟังจริง

## 2026-11-09 โมเดลคอ 3 มิติ, แถบเอียงและหัน, ตรวจทิศแกน
- งานที่ทำ:
  - เปลี่ยนโปรแทรกเตอร์ 2 มิติเป็นโมเดลศีรษะและคอ 3 มิติ (Three.js และหัวสแกนจากหน้า sensor_demo ของ HeadSet)
  - เพิ่มมุมมอง 3 มิติ / ด้านข้าง / ด้านหน้า แสดงแบบกระจกเป็นค่าเริ่มต้น
  - เพิ่มแถบ ก้ม-เงย / เอียงศีรษะ / หันหน้า และเอาสรุป "วันนี้" ออก
  - เพิ่มส่วนตรวจทิศทางเซ็นเซอร์ในหน้า dev
  - ตรวจทิศแกนของเว็บเทียบกับเฟิร์มแวร์ และเขียนผลไว้ที่ `docs/SENSOR_AXES.md`
- ไฟล์ที่แตะ: `index.html`, `assets/user.js`, `assets/user.css`, `assets/neck-model.js` (ใหม่), `assets/vendor/` และ `assets/models/head/` (ยกมาจาก HeadSet), `dev.html`, `assets/dev.js`, `assets/dev.css`, `assets/c7-core.js` (สคริปต์ข้อมูลจำลอง), `docs/SENSOR_AXES.md`, `README.md`
- ตรวจแล้ว:
  - `check-web` 17/17 ผ่าน
  - ในเบราว์เซอร์ (`?demo`):
    - "เอียงขวา 16°" แล้วภาพเอียงขวาแบบกระจก
    - "หันซ้าย 26°"
    - มุมมองด้านข้างแสดง CVA 41° ตอนคอยื่น และแถบเตือนขึ้น
    - console ไม่มี error
  - ส่วนตรวจทิศทางจับ roll ที่กลับเครื่องหมายได้
  - จำลองสูตรเฟิร์มแวร์ (`quaternionToEulerDeg` + ลบค่าตั้งศูนย์ + ค่ากลางสองหู) พบว่าถ้าติดบอร์ดแนบข้างศีรษะ แกนสลับกัน และค่าจากสองหูหักล้างกัน
- ยังไม่ได้ยืนยัน: ทิศแกนจริงบนบอร์ด และการใช้งานกับหูฟังจริง
- งานต่อไป: ตรวจทิศทางกับหูฟังจริง แล้วแก้เฟิร์มแวร์

## 2026-11-09 แก้บั๊กจากการรีวิวโค้ดหน้าเว็บ
- งานที่ทำ: แก้ 10 จุดที่ agent รีวิวพบ
  - ต่อพอร์ตเดิมซ้ำแล้วเปิดไม่ได้
  - กดเชื่อมต่อซ้อนกันแล้วค้างรอข้อมูล
  - packet เสียครั้งเดียวทำให้หลุดสถานะวัดอยู่
  - คำสั่งชนกันตอนเขียนพอร์ต
  - สแกนค้างเมื่อตัดการเชื่อมต่อ
  - ตั้งศูนย์ก่อนมีข้อมูลแล้วรายงานว่าสำเร็จ
  - บอร์ดเงียบแต่ไม่ขึ้นว่าสัญญาณขาด
  - ค่าตั้งค่าที่เก็บไว้เสียทำให้หน้าพัง
  - สถิติข้ามวันหาย
  - CSV ไม่ระบุแถวที่เป็นข้อมูลจำลอง
- ไฟล์ที่แตะ: `assets/c7-core.js`, `assets/user.js`, `assets/dev.js`, `scripts/check-web.mjs`
- ตรวจแล้ว: check-web 17/17 ผ่าน (เพิ่มเทสต์ regression 5 ข้อ), ลองในเบราว์เซอร์ทั้งสองหน้าแล้วไม่มี error
- ยังไม่ได้ยืนยัน: พฤติกรรมกับพอร์ต USB จริง
- งานต่อไป: ทดสอบกับหูฟัง

## 2026-11-09 หน้าเว็บใหม่ (หน้าผู้ใช้ + หน้า dev) แทนหน้าเดิม
- งานที่ทำ:
  - ลบ `live_test.html`, `wiring_guide.html` และ pitch deck ใน `index.html`
  - ทำ `index.html` (หน้าผู้ใช้) และ `dev.html` ใหม่ ใช้ design tokens และฟอนต์ IBM Plex ที่เก็บไว้ในเครื่อง
  - ย้ายตรรกะ USB และการตรวจข้อมูลไปไว้ใน `assets/c7-core.js`
  - ใช้ ui-ux-pro-max และ taste-skill เป็นข้อมูลอ้างอิงอย่างเดียว (clone ไว้ที่ `D:\work\_design-skills` ไม่ได้รันสคริปต์ในนั้น)
- ไฟล์ที่แตะ: `index.html`, `dev.html`, `assets/*`, `assets/fonts/*`, `docs/DESIGN.md`, `scripts/check-web.mjs`, `README.md`
- ตรวจแล้ว: check-web ผ่าน และ CVA ตรงกับเฟิร์มแวร์ทั้ง 216 กรณี
- ยังไม่ได้ยืนยัน: กับหูฟังจริง
- งานต่อไป: รีวิวโค้ด

## 2026-11-09 Clone ใหม่ ตรวจการคำนวณ และ set up
- งานที่ทำ:
  - Clone upstream (`cf27bb4`) ลงโฟลเดอร์นี้
  - แบ่ง agent ตรวจเฟิร์มแวร์ การคำนวณ และเว็บกับ API
  - เทียบ CVA ระหว่าง JS / PHP / C++ ด้วยกรณีทดสอบชุดเดียวกัน
  - Build เฟิร์มแวร์โดยไม่ flash
  - ทดสอบ API กรณีขอบ (ค่าว่าง, ค่าผิดชนิด, เกินช่วง)
- ตรวจแล้ว:
  - JS ↔ C++ ต่างกันไม่เกิน 0.0001°
  - PHP fallback คลาดสูงสุด 8.16°
  - Build ผ่าน (flash 71%, RAM 14%)
  - API รับค่าเสียได้ทั้งหมด และช้า 6–8 วินาทีเมื่อไม่มี MySQL
  - คืนไฟล์ตัวอย่างแล้ว
- ยังไม่ได้ยืนยัน: บนฮาร์ดแวร์
- งานต่อไป: ทำหน้าเว็บใหม่
