67160366/C7-earphone-web/(commit log)

2026-11-05 Update Arduino SafeBNO085 dual-sensor code, live_test.html, and add README
2026-11-09 Add user/dev web pages, CVA geometry 1 and protocol v2
    New offline web pages (no CDN, no build step) replace live_test.html and
    wiring_guide.html:
    - index.html: posture state, head direction meters, alert, settings and a
    3D head/neck model (vendored Three.js, Lee Perry-Smith scan).
    - dev.html: board/sensor status, log, commands, axis-direction check,
    simulator, API save, CSV export and a step-by-step CVA formula panel
    (inputs with sources, constants, substituted steps, side-view SVG and the
    3D model driven by the same numbers).
    - assets/c7-core.js: CVA model, packet validation, Web Serial session,
    labelled simulator; scripts/check-web.mjs runs 21 dependency-free checks.
    CVA geomet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
    [esp32_c7_prototype.ino]
2026-11-09 Fix face distortion on flexion, mirror dev model, sensors panel on top
    - neck-model.js: the head/neck skin boundary now runs from the nape
    hollow (3.4, 7.5 cm from C7) to the crease under the chin (12.5, 1.0 cm),
    measured on the scan's midline profile. Before, the chin and lower lip
    were weighted to neck bones, so they stretched when looking up and
    twisted when looking down.
    - dev page: the formula panel's 3D model is mirrored by default like the
    user page (right ear down tilts to the right of the screen), with a
    switch to turn it off. Roll direction was correct; only the two pages
    were drawn differently.
    - dev page: the sensor connection and board panels sit at the top.
    - HAND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
2026-11-10 Add 50 Hz data collection page, collect mode firmware and 460800 baud
2026-11-11 Add over-ear headset wiring page with 3D model and pin diagram
2026-11-11 Update collect page with 3D sensor axes view and refine wiring page and firmware
2026-11-13 Add structure page for C7 box internals, shopping list, and wiring page updates
